256foundation/libreboard/README.md

# Libre-Board
Open Source Bitcoin Mining Control Board.
Learn more at https://libreboard.org/

Libre Logo

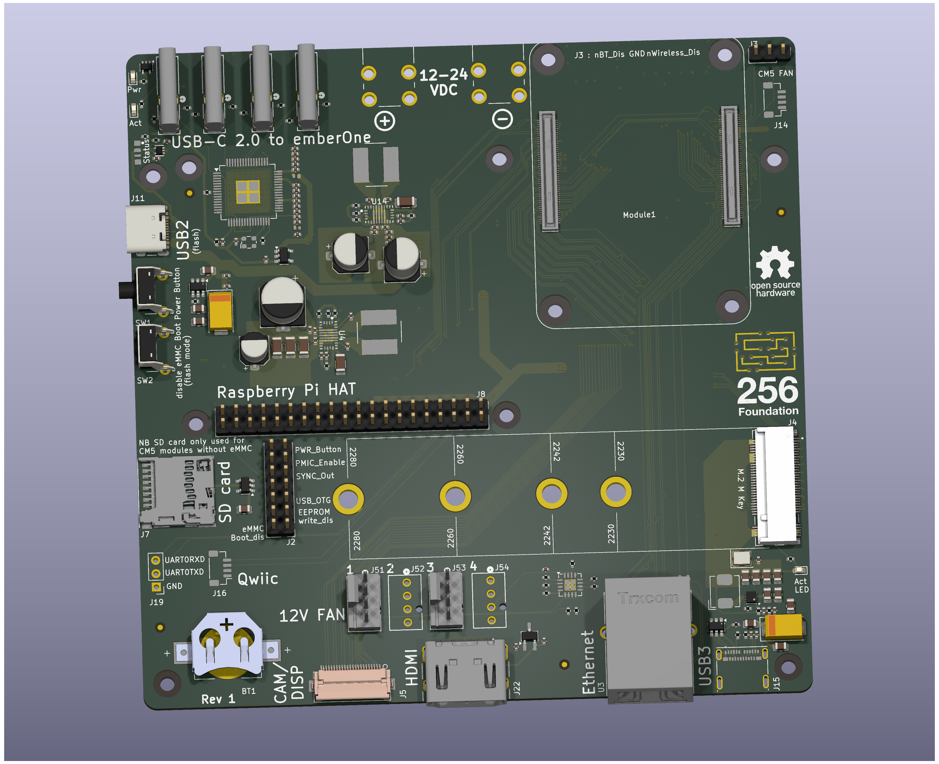
[picture p1: assets/renders/libreboard_front.png]
Libre Board Front


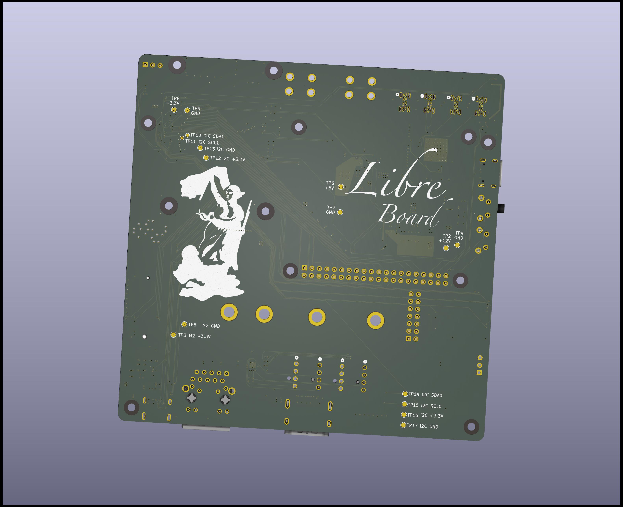
[picture p2: assets/renders/libreboard_back.jpg]
Libre Board Back
