256foundation/libreboard/250916_schematic-pcb-error-report.txt

Info: Processing symbol 'J15:Connector_USB:USB_C_Receptacle_Molex_105450-0101'.
Info: Processing symbol 'J6:libreboard:216989-0001_MOL'.
Info: Processing symbol 'U18:Package_TO_SOT_SMD:SOT-23-5'.
Info: Processing symbol 'U15:Package_TO_SOT_SMD:SOT-23-6'.
Info: Processing symbol 'J7:CM5IO:SDCARD_MOLEX_503398-1892'.
Info: Processing symbol 'J8:Connector_PinHeader_2.54mm:PinHeader_2x20_P2.54mm_Vertical'.
Info: Processing symbol 'J10:libreboard:216989-0001_MOL'.
Info: Processing symbol 'U14:libreboard:RYQ0021A-MFG'.
Info: Processing symbol 'U13:Package_TO_SOT_SMD:SOT-23-5'.
Info: Processing symbol 'U12:Package_TO_SOT_SMD:TSOT-23_HandSoldering'.
Info: Processing symbol 'J11:Connector_USB:USB_C_Receptacle_GCT_USB4105-GF-A_16P_TopMnt_Horizontal'.
Info: Processing symbol 'U11:Package_QFP:HTQFP-64-1EP_10x10mm_P0.5mm_EP8x8mm_Mask4.4x4.4mm_ThermalVias'.
Info: Processing symbol 'J14:Connector_JST:JST_SH_BM04B-SRSS-TB_1x04-1MP_P1.00mm_Vertical'.
Info: Processing symbol 'U10:Package_DFN_QFN:Texas_RGV0016A_VQFN-16-1EP_4x4mm_P0.65mm_EP2.1x2.1mm_ThermalVias'.
Info: Processing symbol 'U9:CM5IO:LED-SMD_4P-L4.0-W1.6-L'.
Info: Processing symbol 'BT1:CM5IO:BatteryHolder_Keystone_3034_1x20mm'.
Info: Processing symbol 'J16:Connector_JST:JST_SH_BM04B-SRSS-TB_1x04-1MP_P1.00mm_Vertical'.
Info: Processing symbol 'U8:Package_DFN_QFN:DFN-8-1EP_2x2mm_P0.5mm_EP1.05x1.75mm'.
Info: Processing symbol 'J17:libreboard:216989-0001_MOL'.
Info: Processing symbol 'U7:Crystal:Crystal_SMD_3225-4Pin_3.2x2.5mm'.
Info: Processing symbol 'U6:Package_TO_SOT_SMD:SOT-23-6'.
Info: Processing symbol 'J19:Connector_PinHeader_2.54mm:PinHeader_1x03_P2.54mm_Vertical'.
Info: Processing symbol 'J22:CM5IO:EDAC 690-019-298-412'.
Info: Processing symbol 'J51:libreboard:CONN_SD-47053-001_H10p00_MOL'.
Info: Processing symbol 'J52:libreboard:CONN_SD-47053-001_H10p00_MOL'.
Info: Processing symbol 'J53:libreboard:CONN_SD-47053-001_H10p00_MOL'.
Info: Processing symbol 'J54:libreboard:CONN_SD-47053-001_H10p00_MOL'.
Info: Processing symbol 'J100:libreboard:KEYSTONE_7790'.
Info: Processing symbol 'U5:Package_TO_SOT_SMD:SOT-353_SC-70-5'.
Info: Processing symbol 'H1:libreboard:MountingHole_2.7mm_M2.5_DIN965'.
Info: Processing symbol 'C62:Capacitor_SMD:C_0402_1005Metric'.
Info: Processing symbol 'C63:Capacitor_SMD:C_0402_1005Metric'.
Info: Processing symbol 'C64:Capacitor_SMD:C_0402_1005Metric'.
Info: Processing symbol 'C65:Capacitor_SMD:C_0402_1005Metric'.
Info: Processing symbol 'C66:Capacitor_SMD:C_0402_1005Metric'.
Info: Processing symbol 'C67:Capacitor_SMD:C_0402_1005Metric'.
Info: Processing symbol 'C68:Capacitor_SMD:C_0402_1005Metric'.
Info: Processing symbol 'C69:Capacitor_SMD:CP_Elec_6.3x9.9'.
Info: Processing symbol 'D1:LED_SMD:LED_0603_1608Metric'.
Info: Processing symbol 'D2:LED_SMD:LED_0603_1608Metric'.
Info: Processing symbol 'D3:LED_SMD:LED_0603_1608Metric'.
Info: Processing symbol 'FB1:libreboard:BEADC1005X55N'.
Info: Processing symbol 'FB2:libreboard:BEADC1005X55N'.
Info: Processing symbol 'U4:libreboard:RYQ0021A-MFG'.
Info: Processing symbol 'H2:libreboard:MountingHole_2.7mm_M2.5_DIN965'.
Info: Processing symbol 'H3:libreboard:MountingHole_2.7mm_M2.5_DIN965'.
Info: Processing symbol 'H4:libreboard:MountingHole_2.7mm_M2.5_DIN965'.
Info: Processing symbol 'H5:libreboard:MountingHole_2.7mm_M2.5_DIN965'.
Info: Processing symbol 'H6:libreboard:MountingHole_2.7mm_M2.5_DIN965'.
Info: Processing symbol 'H7:libreboard:MountingHole_2.7mm_M2.5_DIN965'.
Info: Processing symbol 'H8:libreboard:MountingHole_2.7mm_M2.5_DIN965'.
Info: Processing symbol 'J1:libreboard:216989-0001_MOL'.
Info: Processing symbol 'J2:Connector_PinHeader_2.54mm:PinHeader_2x07_P2.54mm_Vertical'.
Info: Processing symbol 'J3:Connector_PinHeader_2.54mm:PinHeader_1x03_P2.54mm_Vertical'.
Info: Processing symbol 'J4:CM5IO:M.2 M Key socket'.
Info: Processing symbol 'J5:CM5IO:Hirose_FH12-22S-0.5SH_1x22-1MP_P0.50mm_Horizontal'.
Info: Processing symbol 'Y1:Oscillator:Oscillator_SMD_ECS_2520MV-xxx-xx-4Pin_2.5x2.0mm'.
Info: Processing symbol 'R34:Resistor_SMD:R_0402_1005Metric'.
Info: Processing symbol 'R21:Resistor_SMD:R_0402_1005Metric'.
Info: Processing symbol 'R22:Resistor_SMD:R_0402_1005Metric'.
Info: Processing symbol 'R23:Resistor_SMD:R_0402_1005Metric'.
Info: Processing symbol 'R24:Resistor_SMD:R_0402_1005Metric'.
Info: Processing symbol 'R25:Resistor_SMD:R_0402_1005Metric'.
Info: Processing symbol 'R26:Resistor_SMD:R_0402_1005Metric'.
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
Warning: No net found for component J10 pad 16 (no pin 16 in symbol).
Warning: No net found for component J10 pad 17 (no pin 17 in symbol).
Warning: No net found for component J1 pad 16 (no pin 16 in symbol).
Warning: No net found for component J14 pad MP (no pin MP in symbol).
Warning: No net found for component J1 pad 18 (no pin 18 in symbol).
Warning: No net found for component J14 pad MP (no pin MP in symbol).
Warning: No net found for component J16 pad MP (no pin MP in symbol).
Warning: No net found for component J17 pad 18 (no pin 18 in symbol).
Warning: No net found for component J17 pad 17 (no pin 17 in symbol).
Warning: No net found for component J17 pad 16 (no pin 16 in symbol).
Warning: No net found for component J17 pad 15 (no pin 15 in symbol).
Warning: No net found for component J1 pad 17 (no pin 17 in symbol).
Warning: No net found for component J100 pad 1_2 (no pin 1_2 in symbol).
Warning: No net found for component J100 pad 1_4 (no pin 1_4 in symbol).
Warning: No net found for component J100 pad 1_1 (no pin 1_1 in symbol).
Warning: No net found for component J100 pad 1_3 (no pin 1_3 in symbol).
Warning: No net found for component J1 pad 15 (no pin 15 in symbol).
Warning: No net found for component J101 pad 1_4 (no pin 1_4 in symbol).
Warning: No net found for component J101 pad 1_2 (no pin 1_2 in symbol).
Warning: No net found for component J101 pad 1_3 (no pin 1_3 in symbol).
Warning: No net found for component J101 pad 1_1 (no pin 1_1 in symbol).
Error: Cannot add BT1 (footprint 'CM5IO:BatteryHolder_Keystone_3034_1x20mm' not found).
Error: Cannot update J4 (footprint 'CM5IO:M.2 M Key socket' not found).
Error: Cannot update U9 (footprint 'CM5IO:LED-SMD_4P-L4.0-W1.6-L' not found).
Error: Cannot update J5 (footprint 'CM5IO:Hirose_FH12-22S-0.5SH_1x22-1MP_P0.50mm_Horizontal' not found).
Error: Cannot update J7 (footprint 'CM5IO:SDCARD_MOLEX_503398-1892' not found).
Error: Cannot update J11 (footprint 'Connector_USB:USB_C_Receptacle_GCT_USB4105-GF-A_16P_TopMnt_Horizontal' not found).
Error: Cannot update Module1 (footprint 'CM5IO:Raspberry-Pi-5-Compute-Module' not found).
Error: Cannot update J22 (footprint 'CM5IO:EDAC 690-019-298-412' not found).
Error: Cannot update U3 (footprint 'CM5IO:TRJG0926HENL' not found).
Error: Cannot update L1 (footprint 'CM5IO:L_Bourns_SRP5030CC' not found).

Info: Total warnings: 34, errors: 10.
