256foundation/libreboard/bom/rev3-sourcing.csv

refs | qty_per_board | value | footprint | manufacturer | mpn | original_mpn | digikey_pn | digikey_status | digikey_stock | digikey_lifecycle | lcsc | jlc_mpn | jlc_manufacturer | jlc_type | jlc_stock | jlc_unit_price | jlc_decision | compared_specs | notes
R1 R10 R17 | 3 | 1kΩ | R_0402_1005Metric | Panasonic | ERJ-H2RF1001X |  | 10-ERJ-H2RF1001XTR-ND | ok | 21581 | Active | C11702 | 0402WGF1001TCE | UNI-ROYAL(Uniroyal Elec) | basic | 8252664 | 0.0035 | substitute | 1kΩ=1kΩ; 0402=0402; ±1%=±1%; 62.5 mW accepted (worst case < 5 mW); ±100ppm=±100ppm; thick film | Rule change from the coordinator: 62.5 mW is now accepted for all 0402 parts (the designer's worst-case dissipation is under 5 mW). Stock 8252664 covers the 30 needed. The substitute is rated -55..155 °C, against the original's 175 °C. Fallback (previous choice): substitute_extended C242161 ERJ2RKF1; DigiKey returned the same MPN. -55..175 °C rating. Reel (TR) number: the DigiKey 'price' is the single-unit price, and reel price breaks start at 5k/10k.
R2 R3 R9 | 3 | 470Ω | R_0402_1005Metric | Panasonic | ERJ-2RKF4700X |  | P470LTR-ND | ok | 266392 | Active | C25117 | 0402WGF4700TCE | UNI-ROYAL(Uniroyal Elec) | basic | 768020 | 0.0027 | substitute | 470Ω=470Ω; 0402=0402; ±1%=±1%; 62.5 mW accepted (worst case < 5 mW); ±100ppm=±100ppm; thick film | Rule change from the coordinator: 62.5 mW is now accepted for all 0402 parts (the designer's worst-case dissipation is under 5 mW). Stock 768020 covers the 30 needed. These are the LED resistors, the worst case on the board at about 4 mW. Fallback (previous choice): exact_extended C413076 ERJ2RKF470; DigiKey returned the same MPN. Reel (TR) number: the DigiKey 'price' is the single-unit price, and reel price breaks start at 5k/10k.
R6 R18 | 2 | 301kΩ | R_0402_1005Metric | Panasonic | ERJ-2RKF3013X |  | P301KLTR-ND | ok | 248697 | Active | C7209900 | AC0402FR-7W301KL | YAGEO | extended | 5260 | 0.0012 | substitute_extended | 301kΩ=301kΩ; 0402=0402; ±1%=±1%; 125mW>=100mW; ±100ppm=±100ppm; thick film | The exact part ERJ2RKF3013X (C416511) has only 8 in stock at JLC, short of the 20 needed. 62.5 mW is now accepted for 0402 parts, but no Basic/Preferred 0402 part has this exact resistance (live check of all 58 no-fee 0402 resistors). There is no Basic/Preferred 301k (only 300k, C25774). Backup: UNI; DigiKey returned the same MPN. Reel (TR) number: the DigiKey 'price' is the single-unit price, and reel price breaks start at 5k/10k.
R7 R19 | 2 | 45.3kΩ | R_0402_1005Metric | Panasonic | ERJ-2RKF4532X |  | P45.3KLTR-ND | ok | 68079 | Active | C2986582 | ERJ2RKF4532X | PANASONIC | extended | 55136 | 0.0058 | exact_extended | exact part: 45.3kΩ ±1% 100mW ±100ppm 0402 | 62.5 mW is now accepted for 0402 parts, but no Basic/Preferred 0402 part has this exact resistance (live check of all 58 no-fee 0402 resistors). No Basic/Preferred 45.3k exists.; DigiKey returned the same MPN. Reel (TR) number: the DigiKey 'price' is the single-unit price, and reel price breaks start at 5k/10k.
R8 | 1 | 48.7kΩ | R_0402_1005Metric | Panasonic | ERJ-2RKF4872X |  | P48.7KLTR-ND | ok | 0 | Active | C2077134 | ERJ2RKF4872X | PANASONIC | extended | 1373 | 0.0064 | exact_extended | exact part: 48.7kΩ ±1% 100mW ±100ppm 0402 | 62.5 mW is now accepted for 0402 parts, but no Basic/Preferred 0402 part has this exact resistance (live check of all 58 no-fee 0402 resistors). No Basic/Preferred 48.7k exists.; DigiKey returned the same MPN. Tape&reel listing shows 0 stock at DigiKey. Reel (TR) number: the DigiKey 'price' is the single-unit price, and reel price breaks start at 5k/10k.
R11 | 1 | 60.4kΩ | R_0402_1005Metric | Panasonic | ERJ-2RKF6042X |  | P60.4KLTR-ND | ok | 161300 | Active | C2986234 | ERJ2RKF6042X | PANASONIC | extended | 15475 | 0.0063 | exact_extended | exact part: 60.4kΩ ±1% 100mW ±100ppm 0402 | 62.5 mW is now accepted for 0402 parts, but no Basic/Preferred 0402 part has this exact resistance (live check of all 58 no-fee 0402 resistors). No Basic/Preferred 60.4k exists.; DigiKey returned the same MPN. Reel (TR) number: the DigiKey 'price' is the single-unit price, and reel price breaks start at 5k/10k.
R12 R46 | 2 | 15kΩ | R_0402_1005Metric | Panasonic | ERJ-2RKF1502X |  | P15.0KLTR-ND | ok | 975659 | Active | C25756 | 0402WGF1502TCE | UNI-ROYAL(Uniroyal Elec) | basic | 842369 | 0.0016 | substitute | 15kΩ=15kΩ; 0402=0402; ±1%=±1%; 62.5 mW accepted (worst case < 5 mW); ±100ppm=±100ppm; thick film | Rule change from the coordinator: 62.5 mW is now accepted for all 0402 parts (the designer's worst-case dissipation is under 5 mW). Stock 842369 covers the 20 needed. Fallback (previous choice): exact_extended C413097 ERJ2RKF1502X (PANASONIC, 100 mW, stock 52329).; DigiKey returned the same MPN. Reel (TR) number: the DigiKey 'price' is the single-unit price, and reel price breaks start at 5k/10k.
R13 | 1 | 50kΩ | R_0402_1005Metric | Vishay Dale | CRCW040250K0FKED |  | 541-CRCW040250K0FKEDTR-ND | ok | 477581 | Active | C7501196 | CRCW040250K0FKED | Vishay Intertech | extended | 7761 | 0.0256 | exact_extended | exact part: 50kΩ ±1% 63mW ±100ppm 0402 | No Basic/Preferred 50k 0402 exists (the list has only 49.9k C25897 and 51k C25794, both wrong values). The part is rated 63 mW (1/16 W), not the 0.1 W in the BOM description.; DigiKey returned the same MPN. DigiKey rates this part 0.063 W (1/16 W), not the 0.1 W in the BOM description. Reel (TR) number: the DigiKey 'price' is the single-unit price, and reel price breaks sta
R16 | 1 | 2.2kΩ | R_0402_1005Metric | Panasonic | ERJ-2RKF2201X |  | P2.20KLTR-ND | ok | 1063778 | Active | C25879 | 0402WGF2201TCE | UNI-ROYAL(Uniroyal Elec) | basic | 1604628 | 0.0017 | substitute | 2.2kΩ=2.2kΩ; 0402=0402; ±1%=±1%; 62.5 mW accepted (worst case < 5 mW); ±100ppm=±100ppm; thick film | Rule change from the coordinator: 62.5 mW is now accepted for all 0402 parts (the designer's worst-case dissipation is under 5 mW). Stock 1604628 covers the 10 needed. Fallback (previous choice): exact_extended C413087 ERJ2RKF2201X (PANASONIC, 100 mW, stock 54381).; DigiKey returned the same MPN. Reel (TR) number: the DigiKey 'price' is the single-unit price, and reel price breaks start at 5k/10k.
R20 | 1 | 25.5kΩ | R_0402_1005Metric | Panasonic | ERJ-2RKF2552X |  | P25.5KLTR-ND | ok | 33362 | Active | C2076811 | ERJ2RKF2552X | PANASONIC | extended | 6384 | 0.0058 | exact_extended | exact part: 25.5kΩ ±1% 100mW ±100ppm 0402 | 62.5 mW is now accepted for 0402 parts, but no Basic/Preferred 0402 part has this exact resistance (live check of all 58 no-fee 0402 resistors). No Basic/Preferred 25.5k exists.; DigiKey returned the same MPN. Reel (TR) number: the DigiKey 'price' is the single-unit price, and reel price breaks start at 5k/10k.
R21 R22 R23 R24 R29 R30 R33 R62 R4 R52 R15 | 11 | 10kΩ | R_0402_1005Metric | Panasonic | ERJ-U02F1002X |  | 10-ERJ-U02F1002XTR-ND | ok | 252849 | Active | C25744 | 0402WGF1002TCE | UNI-ROYAL(Uniroyal Elec) | basic | 19735080 | 0.0034 | substitute | 10kΩ=10kΩ; 0402=0402; ±1%=±1%; 62.5 mW accepted (worst case < 5 mW); ±100ppm (better than the original's ±200ppm); thick film | Rule change from the coordinator: 62.5 mW is now accepted for all 0402 parts (the designer's worst-case dissipation is under 5 mW). Stock 19735080 covers the 110 needed. Loses the ERJ-U anti-sulfur feature. Fallback (previous choice): substitute_extended C191123 ERJ2RKF1002X (PANASONIC, 100 mW, stoc; DigiKey returned the same MPN. Anti-sulfur, ±200 ppm/°C. Reel (TR) number: the DigiKey 'price' is the single-unit price, and reel price breaks start at 5k/10k.
R27 | 1 | 9.53kΩ | R_0402_1005Metric | Panasonic | ERJ-2RKF9531X |  | P9.53KLTR-ND | ok | 91600 | Active | C409938 | ERJ2RKF9531X | PANASONIC | extended | 999 | 0.0069 | exact_extended | exact part: 9.53kΩ ±1% 100mW ±100ppm 0402 | 62.5 mW is now accepted for 0402 parts, but no Basic/Preferred 0402 part has this exact resistance (live check of all 58 no-fee 0402 resistors). No Basic/Preferred 9.53k exists.; DigiKey returned the same MPN. Reel (TR) number: the DigiKey 'price' is the single-unit price, and reel price breaks start at 5k/10k.
R28 R58 | 2 | 4.7kΩ | R_0402_1005Metric | Panasonic | ERJ-U02F4701X |  | 10-ERJ-U02F4701XTR-ND | ok | 0 | Active | C25900 | 0402WGF4701TCE | UNI-ROYAL(Uniroyal Elec) | basic | 14590156 | 0.0027 | substitute | 4.7kΩ=4.7kΩ; 0402=0402; ±1%=±1%; 62.5 mW accepted (worst case < 5 mW); ±100ppm (better than the original's ±200ppm); thick film | Rule change from the coordinator: 62.5 mW is now accepted for all 0402 parts (the designer's worst-case dissipation is under 5 mW). Stock 14590156 covers the 20 needed. Loses the ERJ-U anti-sulfur feature. Fallback (previous choice): exact_extended C1858865 ERJU02F4701X (PANASONIC, 100 mW, stock 928; DigiKey returned the same MPN. Tape&reel listing shows 0 stock at DigiKey. Anti-sulfur, ±200 ppm/°C. Reel (TR) number: the DigiKey 'price' is the single-unit price, and reel price breaks start at 5k/1
R31 | 1 | 22kΩ | R_0402_1005Metric | Panasonic | ERJ-2RKF2202X |  | P22.0KLTR-ND | ok | 758224 | Active | C25768 | 0402WGF2202TCE | UNI-ROYAL(Uniroyal Elec) | basic | 739614 | 0.0024 | substitute | 22kΩ=22kΩ; 0402=0402; ±1%=±1%; 62.5 mW accepted (worst case < 5 mW); ±100ppm=±100ppm; thick film | Rule change from the coordinator: 62.5 mW is now accepted for all 0402 parts (the designer's worst-case dissipation is under 5 mW). Stock 739614 covers the 10 needed. Fallback (previous choice): exact_extended C413100 ERJ2RKF2202X (PANASONIC, 100 mW, stock 29316).; DigiKey returned the same MPN. Reel (TR) number: the DigiKey 'price' is the single-unit price, and reel price breaks start at 5k/10k.
R32 | 1 | 33kΩ | R_0402_1005Metric | Panasonic | ERJ-U02F3302X |  | 10-ERJ-U02F3302XTR-ND | ok | 38199 | Active | C25779 | 0402WGF3302TCE | UNI-ROYAL(Uniroyal Elec) | basic | 1171145 | 0.0058 | substitute | 33kΩ=33kΩ; 0402=0402; ±1%=±1%; 62.5 mW accepted (worst case < 5 mW); ±100ppm (better than the original's ±200ppm); thick film | Rule change from the coordinator: 62.5 mW is now accepted for all 0402 parts (the designer's worst-case dissipation is under 5 mW). Stock 1171145 covers the 10 needed. Loses the ERJ-U anti-sulfur feature. Fallback (previous choice): substitute_extended C278593 ERJ2RKF3302X (PANASONIC, 100 mW, stock ; DigiKey returned the same MPN. Anti-sulfur, ±200 ppm/°C. Reel (TR) number: the DigiKey 'price' is the single-unit price, and reel price breaks start at 5k/10k.
R34 R35 R36 R37 R38 R39 R40 R41 | 8 | 56kΩ | R_0402_1005Metric | Panasonic | ERJ-2RKF5602X |  | P56.0KLTR-ND | ok | 10089 | Active | C25796 | 0402WGF5602TCE | UNI-ROYAL(Uniroyal Elec) | preferred | 196831 | 0.003 | substitute | 56kΩ=56kΩ; 0402=0402; ±1%=±1%; 62.5 mW accepted (worst case < 5 mW); ±100ppm=±100ppm; thick film | Rule change from the coordinator: 62.5 mW is now accepted for all 0402 parts (the designer's worst-case dissipation is under 5 mW). Stock 196831 covers the 80 needed. Fallback (previous choice): exact_extended C413104 ERJ2RKF5602X (PANASONIC, 100 mW, stock 6041).; DigiKey returned the same MPN. Reel (TR) number: the DigiKey 'price' is the single-unit price, and reel price breaks start at 5k/10k.
R47 | 1 | 4.7kΩ | R_0603_1608Metric | Panasonic | ERJ-3EKF4701V |  | P4.70KHTR-ND | ok | 1040879 | Active | C23162 | 0603WAF4701T5E | UNI-ROYAL(Uniroyal Elec) | basic | 20999866 | 0.0028 | substitute | 4.7kΩ=4.7kΩ; 0603=0603; ±1%=±1%; 100mW=100mW; ±100ppm=±100ppm; thick film | The exact part ERJ3EKF4701V (C192166) is an extended part (stock 57835).; DigiKey returned the same MPN. Reel (TR) number: the DigiKey 'price' is the single-unit price, and reel price breaks start at 5k/10k.
R48 | 1 | 90.9kΩ | R_0603_1608Metric | Panasonic | ERJ-3EKF9092V |  | P90.9KHTR-ND | ok | 47115 | Active | C403390 | ERJ3EKF9092V | PANASONIC | extended | 49056 | 0.0084 | exact_extended | exact part: 90.9kΩ ±1% 100mW ±100ppm 0603 | No Basic/Preferred 90.9k 0603 exists. The search returned only 91k C23265, which is the wrong value.; DigiKey returned the same MPN. Reel (TR) number: the DigiKey 'price' is the single-unit price, and reel price breaks start at 5k/10k.
R49 | 1 | 10kΩ | R_0603_1608Metric | Panasonic | ERJ-3EKF1002V |  | P10.0KHTR-ND | ok | 2231125 | Active | C25804 | 0603WAF1002T5E | UNI-ROYAL(Uniroyal Elec) | basic | 26133491 | 0.0018 | substitute | 10kΩ=10kΩ; 0603=0603; ±1%=±1%; 100mW=100mW; ±100ppm=±100ppm; thick film | The exact part ERJ3EKF1002V (C191124) is an extended part (stock 535392).; DigiKey returned the same MPN. Reel (TR) number: the DigiKey 'price' is the single-unit price, and reel price breaks start at 5k/10k.
R50 | 1 | 158kΩ | R_0603_1608Metric | Panasonic | ERJ-3EKF1583V |  | P158KHTR-ND | ok | 43820 | Active | C22883 | 0603WAF1583T5E | UNI-ROYAL | extended | 52000 | 0.0052 | substitute_extended | exact part: 158kΩ ±1% 100mW ±100ppm 0603 | exact C403004 has only 15 at JLC for 10 needed; UNI-ROYAL 0603WAF1583T5E 158k 1% 0603 100 mW, 52k in stock; LOW STOCK: only 15 in stock (live check) for 10 needed, which leaves almost no room for assembly attrition. No Basic/Preferred 158k 0603 exists. Recommended backup: UNI-ROYAL 0603WAF1583T5E C22883 (extended, 158kΩ ±1% 100mW ±100ppm, stock 52435, $0.0014).; DigiKey returned the same MPN. Reel (TR) number: the DigiKey 'price' is the single-unit price, and reel price breaks start at 5k/10k.
R51 | 1 | 100kΩ | R_0603_1608Metric | Panasonic | ERJ-3EKF1003V |  | P100KHTR-ND | ok | 0 | Active | C25803 | 0603WAF1003T5E | UNI-ROYAL(Uniroyal Elec) | basic | 21036877 | 0.0031 | substitute | 100kΩ=100kΩ; 0603=0603; ±1%=±1%; 100mW=100mW; ±100ppm=±100ppm; thick film | The exact part ERJ3EKF1003V (C189597) is an extended part (stock 10239).; DigiKey returned the same MPN. Tape&reel listing shows 0 stock at DigiKey. Reel (TR) number: the DigiKey 'price' is the single-unit price, and reel price breaks start at 5k/10k.
R53 R55 R63 R42 R14 | 5 | 100kΩ | R_0402_1005Metric | Panasonic | ERJ-U02F1003X |  | 10-ERJ-U02F1003XTR-ND | ok | 65237 | Active | C25741 | 0402WGF1003TCE | UNI-ROYAL(Uniroyal Elec) | basic | 8076053 | 0.0024 | substitute | 100kΩ=100kΩ; 0402=0402; ±1%=±1%; 62.5 mW accepted (worst case < 5 mW); ±100ppm (better than the original's ±200ppm); thick film | Rule change from the coordinator: 62.5 mW is now accepted for all 0402 parts (the designer's worst-case dissipation is under 5 mW). Stock 8076053 covers the 50 needed. Loses the ERJ-U anti-sulfur feature. Fallback (previous choice): exact_extended C4331556 ERJU02F1003X (PANASONIC, 100 mW, stock 1013; DigiKey returned the same MPN. Anti-sulfur, ±200 ppm/°C. Reel (TR) number: the DigiKey 'price' is the single-unit price, and reel price breaks start at 5k/10k.
R54 | 1 | 30.1kΩ | R_0402_1005Metric | Panasonic | ERJ-2RKF3012X |  | P30.1KLTR-ND | ok | 57013 | Active | C2076806 | ERJ2RKF3012X | PANASONIC | extended | 28662 | 0.0059 | exact_extended | exact part: 30.1kΩ ±1% 100mW ±100ppm 0402 | 62.5 mW is now accepted for 0402 parts, but no Basic/Preferred 0402 part has this exact resistance (live check of all 58 no-fee 0402 resistors). No Basic/Preferred 30.1k exists.; DigiKey returned the same MPN. Reel (TR) number: the DigiKey 'price' is the single-unit price, and reel price breaks start at 5k/10k.
R56 | 1 | 11.0kΩ | R_0402_1005Metric | Panasonic | ERJ-2RKF1102X |  | P11.0KLTR-ND | ok | 198499 | Active | C409880 | ERJ2RKF1102X | PANASONIC | extended | 11322 | 0.0082 | exact_extended | exact part: 11kΩ ±1% 100mW ±100ppm 0402 | 62.5 mW is now accepted for 0402 parts, but no Basic/Preferred 0402 part has this exact resistance (live check of all 58 no-fee 0402 resistors). No Basic/Preferred 11k exists.; DigiKey returned the same MPN. Reel (TR) number: the DigiKey 'price' is the single-unit price, and reel price breaks start at 5k/10k.
R57 | 1 | 887kΩ | R_0402_1005Metric | Panasonic | ERJ-2RKF8873X |  | P887KLTR-ND | ok | 150601 | Active | C409935 | ERJ2RKF8873X | PANASONIC | extended | 11735 | 0.0062 | exact_extended | exact part: 887kΩ ±1% 100mW ±100ppm 0402 | 62.5 mW is now accepted for 0402 parts, but no Basic/Preferred 0402 part has this exact resistance (live check of all 58 no-fee 0402 resistors). No Basic/Preferred 887k exists.; DigiKey returned the same MPN. Reel (TR) number: the DigiKey 'price' is the single-unit price, and reel price breaks start at 5k/10k.
R59 | 1 | 499kΩ | R_0402_1005Metric | Panasonic | ERJ-2RKF4993X |  | P499KLTR-ND | ok | 199751 | Active | C2986233 | ERJ2RKF4993X | PANASONIC | extended | 34194 | 0.0066 | exact_extended | exact part: 499kΩ ±1% 100mW ±100ppm 0402 | 62.5 mW is now accepted for 0402 parts, but no Basic/Preferred 0402 part has this exact resistance (live check of all 58 no-fee 0402 resistors). No Basic/Preferred 499k exists.; DigiKey returned the same MPN. Reel (TR) number: the DigiKey 'price' is the single-unit price, and reel price breaks start at 5k/10k.
R60 R61 | 2 | 200kΩ | R_0402_1005Metric | Panasonic | ERJ-2RKF2003X |  | P200KLTR-ND | ok | 604734 | Active | C25764 | 0402WGF2003TCE | UNI-ROYAL(Uniroyal Elec) | basic | 2227884 | 0.0018 | substitute | 200kΩ=200kΩ; 0402=0402; ±1%=±1%; 62.5 mW accepted (worst case < 5 mW); ±100ppm=±100ppm; thick film | Rule change from the coordinator: 62.5 mW is now accepted for all 0402 parts (the designer's worst-case dissipation is under 5 mW). Stock 2227884 covers the 20 needed. Fallback (previous choice): exact_extended C413111 ERJ2RKF2003X (PANASONIC, 100 mW, stock 48403).; DigiKey returned the same MPN. Reel (TR) number: the DigiKey 'price' is the single-unit price, and reel price breaks start at 5k/10k.
C2 C7 C8 C56 C58 C59 C75 C77 C5 C4 C6 C14 C15 C16 C17 | 15 | 10µF | C_0805_2012Metric | Kyocera | 0805ZD106KAT2A |  | 478-KGM21AR51A106KUTR-ND | ok | 59 | Active | C15850 | CL21A106KAYNNNE | Samsung Electro-Mechanics | basic | 4331767 | 0.0688 | substitute | orig 10uF 10V X5R +-10% 0805 -> sub 10uF 25V X5R +-10% 0805 (V higher, same dielectric/tol) | Exact part at JLC is extended C4153103 (stock 4591). Need 150.; DigiKey returns mfr_part_number 0805ZD106KAT2A for this number (DigiKey PN uses Kyocera's new KGM name). 10uF 10V X5R +-10% 0805. LOW STOCK: 59 vs 150 needed; T&R min_qty 3000.
C3 | 1 | 100µF | CP_EIA-7343-31_Kemet-D | Kemet | A700X107M010ATE010 |  | 399-11382-2-ND | ok | 14515 | Active | C3275146 | A700X107M010ATE010 | KEMET | extended | 31 | 5.347 | exact_extended | exact part: 100uF 10V aluminium polymer 10mOhm SMD 7.3x4.3mm | No basic/preferred polymer caps at JLC. LOW STOCK: 31 vs 20 needed (live stock check confirms 31). No 7343 aluminium-polymer alternative at JLC meets ESR <= 10mOhm (closest: C135491 AISHI SA11AM101A19R15XXX and C2997484 Ymin MPD101M1AD19015R, both 100uF 10V 15mOhm@100kHz).; MPN matches. DigiKey: Polymer (aluminium polymer, not tantalum), 100uF 10V 10mOhm, 2917/7343, 4.3mm H, 125C. T&R min_qty 500.
C9 C18 C31 C12 C13 C35 C36 C37 C38 C39 C40 C41 C42 C43 C44 C45 C50 C1 C70 C10 C19 | 21 | 100nF | C_0402_1005Metric | Kyocera | 04026D104KAT4A |  | 478-11504-2-ND | ok | 55525 | Active | C1525 | CL05B104KO5NNNC | Samsung Electro-Mechanics | basic | 24116891 | 0.0045 | substitute | orig 100nF 6.3V X5R +-10% 0402 -> sub 100nF 16V X7R +-10% 0402 (V higher, dielectric better, tol equal) | Exact MPN not found at JLC. Need 210. 50V alternative also basic: C307331 CL05B104KB54PNC.; MPN matches (KYOCERA AVX 04026D104KAT4A, 0.1uF 6.3V X5R +-10% 0402). T&R number, min_qty 50000 - order cut tape for 210 pcs.
C11 | 1 | 4.7nF | C_0402_1005Metric | Kyocera | KGM05AR71A472KH |  | 478-KGM05AR71A472KHTR-ND | ok | 53601 | Active | C1538 | 0402B472K500NT | FH (Guangdong Fenghua Advanced Tech) | basic | 1185783 | 0.0038 | substitute | orig 4.7nF 10V X7R +-10% 0402 -> sub 4.7nF 50V X7R +-10% 0402 (V higher, same dielectric/tol) | Exact MPN not at JLC.; Lookup by DigiKey number returned an API error; lookup by MPN returned this same DigiKey number with matching MPN (4700pF 10V X7R +-10% 0402). T&R min_qty 10000.
C20 | 1 | 39µF | CP_Elec_8x6.7 | Kemet | A770KE396M1HLAS042 |  | 399-A770KE396M1HLAS042TR-ND | ok | 6839 | Active | C7059708 | A770KE396M1HLAS042 | KEMET | extended | 24 | 0.3242 | exact_extended | exact part: 39uF 50V polymer 42mOhm D8xL6.7 (7mm max) | No basic/preferred polymer aluminium caps exist at JLC. LOW STOCK: 24 vs 10 needed (live stock check confirms 24). Backup with same specs/case: C1517683 KEMET A768KE396M1HLAE042 (39uF 50V 42mOhm@100kHz, 8x6.7mm, 125C, stock 45, $1.0571, extended).; MPN matches. DigiKey: Type Polymer (aluminium polymer, not wet electrolytic), 39uF 50V 42mOhm, 8mm dia x 7.0mm, AEC-Q200, 125C. T&R min_qty 1000.
C21 C52 | 2 | 10µF | C_0805_2012Metric | Murata Electronics | GRM21BR61H106KE43L |  | 490-18663-2-ND | ok | 0 | Active | C440198 | GRM21BR61H106KE43L | Murata Electronics | basic | 1370400 | 0.2069 | exact | exact part: 10uF 50V X5R +-10% 0805 | Exact part is basic at JLC. Need 20.; MPN matches. DigiKey STOCK 0 on this T&R number (min_qty 3000).
C22 C30 C54 C74 | 4 | 1µF | C_0402_1005Metric | Murata Electronics | GRM155R61H105KE05D |  | 490-GRM155R61H105KE05DTR-ND | ok | 0 | Active | C1518208 | GRM155R61H105KE05D | Murata Electronics | extended | 191710 | 0.0341 | exact_extended | exact part: 1uF 50V X5R +-10% 0402 | Only basic 1uF 0402 is C52923 (25V) - lower voltage than original 50V, so not used. Need 40.; MPN matches. DigiKey STOCK 0 on this T&R number (min_qty 10000).
C23 C53 | 2 | 4.7µF | C_1206_3216Metric | Kyocera | 12065C475KAT2A |  | 478-KGM31AR71H475KUTR-ND | ok | 12061 | Active | C29823 | 1206B475K500NT | FH (Guangdong Fenghua Advanced Tech) | basic | 531847 | 0.1674 | substitute | orig 4.7uF 50V X7R +-10% 1206 -> sub 4.7uF 50V X7R +-10% 1206 (identical ratings) | Exact part also at JLC as extended C141667 (stock 2248, $0.4121). Need 20.; DigiKey returns mfr_part_number 12065C475KAT2A for this number (DigiKey PN uses Kyocera's new KGM name). 4.7uF 50V X7R +-10% 1206. T&R min_qty 2000.
C24 C25 C55 C65 C76 C78 | 6 | 100nF | C_0402_1005Metric | Murata Electronics | GRM155R71H104KE14D |  | 490-10700-2-ND | ok | 1300291 | Active | C307331 | CL05B104KB54PNC | Samsung Electro-Mechanics | basic | 16068309 | 0.0104 | substitute | orig 100nF 50V X7R +-10% 0402 -> sub 100nF 50V X7R +-10% 0402 (identical ratings) | Exact part at JLC is extended C77020 (stock 1601775). Need 60.; MPN matches. T&R min_qty 10000.
C26 | 1 | 56µF | CP_Elec_5x5.9 | APAQ Technology | 250AVCP470M0506 | 20SVF56M |  | not_checked |  |  | C54864098 | 250AVCP470M0506 | APAQ Tech | extended | 1035 | 0.1927 | substitute_extended (decided 2026-10-20) | polymer, 47uF (was 56uF), 25V (was 20V), 35 mOhm @100kHz (was 30), 1.7A ripple, D5xL5.8mm (same 5 mm footprint) | Fitted again (was DNP by accident since 82c34c4). Panasonic 20SVPF56MX C2162042 has 2 at JLC, min order 6. Distributor = LCSC C54864098; no EasyEDA footprint.
C27 C28 C29 | 3 | 33µF | C_1206_3216Metric | TDK Corporation | C3216X5R1E336M160AC |  | 445-8046-1-ND | ok | 0 | Active | C342307 | C3216X5R1E336MT000E | TDK | extended | 22926 | 1.1825 | substitute_extended | orig 33uF 25V X5R +-20% 1206 -> sub 33uF 25V X5R +-20% 1206 (identical ratings, same maker) | strip trailing ' - Cut Tape' text; Exact MPN not at JLC; no basic/preferred 33uF 1206 exists. Need 30.; Lookup of 445-8046-1-ND resolved to its T&R sibling 445-8046-2-ND with matching MPN (TDK C3216X5R1E336M160AC, 33uF 25V X5R +-20% 1206); existing cut-tape number kept. Stock/price shown are those retur
C34 C46 | 2 | 10µF | C_0402_1005Metric | Kyocera | 04026D106MAT2A |  | 478-KGM05CR50J106MHTR-ND | ok | 155910 | Active | C15525 | CL05A106MQ5NUNC | Samsung Electro-Mechanics | basic | 10912233 | 0.0256 | substitute | orig 10uF 6.3V X5R +-20% 0402 -> sub 10uF 6.3V X5R +-20% 0402 (identical ratings) | Exact part at JLC is extended C2178725 (stock 6189). Need 30.; DigiKey returns mfr_part_number 04026D106MAT2A for this number (DigiKey PN uses Kyocera's new KGM name). 10uF 6.3V X5R +-20% 0402. T&R min_qty 10000.
C71 | 1 | 10µF | C_0402_1005Metric | Murata | GRM155R61A106ME11D | 04026D106MAT2A | 490-GRM155R61A106ME11DTR-ND | ok | 0 | Active | C408132 | GRM155R61A106ME11D | Murata Electronics | extended | 184526 | 0.0453 | upgrade (decided 2026-10-20) | 10uF 0402 X5R +-20%, 10 V instead of 6.3 V (C71 sits on +5v at 5.19 V) | Voltage margin only; any 0402 10 uF keeps a fraction of its capacity at 5 V. DigiKey TR reel number (0 in stock on 2026-10-20, Active); Mouser 81-GRM155R61A106ME1D.
C51 | 1 | 22µF | CP_Elec_6.3x5.9 | Kemet | A768EB226M1HLAE048 |  | 399-A768EB226M1HLAE048TR-ND | ok | 8911 | Active | C46550474 | MA50V22M6X6 | jieerrui | extended | 73859 | 0.1862 | substitute_extended | orig polymer 22uF 50V 48mOhm D6.3x6.0 -> sub polymer 22uF 50V 40mOhm@100kHz SMD D6.3xL6mm (C equal, V equal, ESR lower, same case) | Exact MPN not at JLC; no basic/preferred polymer caps exist. Substitute rated -55~+105C, 2000h@105C (original 125C). On 12-24 V input: 50 V rating kept.; MPN matches. DigiKey: Polymer (aluminium polymer), 22uF 50V 48mOhm, 6.3mm dia x 6.0mm, 125C. T&R min_qty 1000.
C60 | 1 | 6.8pF | C_0402_1005Metric | Kyocera | 04025A6R8CAT2A |  | 478-KGM05ACG1H6R8CHTR-ND | not_at_digikey |  |  | C1576 | 0402CG6R8C500NT | FH (Guangdong Fenghua Advanced Tech) | preferred | 202831 | 0.0046 | substitute | orig 6.8pF 50V C0G +-0.25pF 0402 -> sub 6.8pF 50V C0G 0402; tolerance letter 'C' in MPN (+-0.25pF) - JLC tolerance field is empty | AVX renamed 04025A6R8CAT2A to KGM05ACG1H6R8CH (new global PN); DigiKey lists the new PN; Exact part at JLC is extended C597037 with only 18 in stock (need 10). Substitute tolerance taken from the MPN code, not a JLC spec field - confirm +-0.25pF in datasheet before use.; Blank dkpn. digikey_get_part('04025A6R8CAT2A') returned 'DigiKey part lookup failed' on 2 attempts - not found or API error; UNCONFIRMED, check manually.
C61 | 1 | 1nF | C_0402_1005Metric | Murata Electronics | GRM1555C1H102JA01D |  | 490-3244-2-ND | filled | 2798015 | Active | C76947 | GRM1555C1H102JA01D | Murata Electronics | extended | 448061 | 0.0103 | exact_extended | exact part: 1nF 50V C0G +-5% 0402 | Only basic 1nF 0402 is C1523 (X7R +-10%) - worse dielectric/tolerance, not used.; Blank dkpn; filled from MPN lookup (Murata GRM1555C1H102JA01D, 1000pF 50V C0G +-5% 0402). T&R min_qty 10000.
C62 | 1 | 2.2nF | C_0402_1005Metric | Kyocera | KGM05AR71H222KH |  | 478-KGM05AR71H222KHTR-ND | ok | 108999 | Active | C1531 | 0402B222K500NT | FH (Guangdong Fenghua Advanced Tech) | preferred | 453137 | 0.0028 | substitute | orig 2.2nF 50V X7R +-10% 0402 -> sub 2.2nF 50V X7R +-10% 0402 (identical ratings) | Exact MPN not at JLC.; MPN matches (2200pF 50V X7R +-10% 0402). T&R min_qty 10000.
C63 | 1 | 3.9pF | C_0402_1005Metric | Kyocera | KGM05ACG1H3R9BH |  | 478-KGM05ACG1H3R9BHTR-ND | ok | 48083 | Active | C1517504 | GJM1555C1H3R9GB01D | Murata Electronics | extended | 5582 | 0.0453 | substitute_extended | orig 3.9pF 50V C0G +-0.1pF 0402 -> sub 3.9pF 50V C0G +-2% (= +-0.078pF) 0402 per JLC spec field | Exact MPN not at JLC; no basic/preferred 3.9pF 0402 exists. Chosen because it is the only candidate whose tolerance is stated in JLC data. Alternative with more stock: C76907 Murata GJM1555C1H3R9BB01D (tolerance letter B = +-0.1pF from MPN code, JLC field empty; stock 19967, $0.0359).; MPN matches. DigiKey tolerance +-0.1pF (BOM text says +-2.5%), 50V C0G 0402. T&R min_qty 10000.
C64 C47 C48 | 3 | 1µF | C_0402_1005Metric | Kyocera | 04026D105KAT2A |  | 478-KGM05AR50J105KHTR-ND | ok | 1265648 | Active | C52923 | CL05A105KA5NQNC | Samsung Electro-Mechanics | basic | 7478708 | 0.0087 | substitute | orig 1uF 6.3V X5R +-10% 0402 -> sub 1uF 25V X5R +-10% 0402 (V higher, same dielectric/tol) | Exact MPN not at JLC. Need 30.; DigiKey returns mfr_part_number 04026D105KAT2A for this number (DigiKey PN uses Kyocera's new KGM name). 1uF 6.3V X5R +-10% 0402. T&R min_qty 10000.
C57 C66 C67 C68 | 4 | 47µF | C_1206_3216Metric | TDK Corporation | C3216X5R1A476M160AB |  | 445-6006-2-ND | filled | 15890 | Active | C96123 | CL31A476MPHNNNE | Samsung Electro-Mechanics | basic | 390136 | 0.2593 | substitute | orig 47uF 10V X5R +-20% 1206 -> sub 47uF 10V X5R +-20% 1206 (identical ratings) | Exact MPN not at JLC. Need 30. On 5.2 V rail.; Blank dkpn; filled from MPN lookup (TDK C3216X5R1A476M160AB, 47uF 10V X5R +-20% 1206). T&R min_qty 2000.
C69 | 1 | 270µF | CP_Elec_6.3x9.9 | Panasonic | 10SVP270M |  | P16432TR-ND | ok | 500 | Active | C2944013 | APXJ160ARA271MF80J | NCC(Nippon Chemi-Con) | extended | 4308 | 0.3981 | substitute_extended | orig polymer 270uF 10V 25mOhm -> sub polymer 270uF 16V 10mOhm SMD D6.3xL7.7mm, 15000h@105C (C equal, V higher, ESR lower; 6.3mm can fits the CP_Elec_6.3x9.9 land pattern) | Exact MPN not at JLC; no basic/preferred polymer caps exist. Alternatives: C46550459 jieerrui MA10V470M6X8 (470uF 10V 20mOhm@100kHz D6.3xL7.7, stock 80334, $0.1994); C178351 Panasonic 16SVPG270M (270uF 16V, D6.3xL9.9 = exact footprint size, but ESR not listed at JLC, stock 596, $1.6043). If the boar; MPN matches. DigiKey: Polymer, 270uF 10V 25mOhm, 105C. FOOTPRINT CHECK: DigiKey lists size 10.00mm dia x 8.00mm H, land 10.3x10.3mm, which does not match footprint CP_Elec_6.3x9.9 - verify against Pan
C72 | 1 | 0.1µF | C_0603_1608Metric | YAGEO | CC0603KRX7R9BB104 | GRM188R71C104KA01D | 311-1344-2-ND | ok | 0 | Obsolete | C14663 | CC0603KRX7R9BB104 | YAGEO | basic | 56561970 | 0.014 | substitute | orig 100nF 16V X7R +-10% 0603 -> sub 100nF 50V X7R +-10% 0603 (V higher, same dielectric/tol) | Murata GRM188R71C104KA01D obsolete (also successors KA01J / 71H104KA93D obsolete at DigiKey); Yageo is JLC Basic and DigiKey active; Exact part at JLC is extended C45000 (stock 41431).; MPN matches, but DigiKey lifecycle OBSOLETE, stock 0, no price. Needs a replacement DigiKey part (e.g. the JLC substitute's MPN) - not looked up (quota).
C73 | 1 | 1nF | C_0603_1608Metric | Murata | GRM1885C1H102JA01D |  |  | wrong |  |  | C77026 | GRM1885C1H102JA01D | Murata Electronics | extended | 113635 | 0.0261 | exact_extended | exact part: 1nF 50V C0G +-5% 0603 | old number 490-1494-2-ND is GRM188R71H102KA01D (X7R, obsolete); DigiKey API lookup for the right part failed - fill manually; Only basic 1nF 0603 is C1588 (X7R +-10%) - worse dielectric/tolerance, not used.; 490-1494-2-ND is GRM188R71H102KA01D (1000pF 50V X7R +-10% 0603, Obsolete, stock 0) - not the C0G +-5% part in the BOM. MPN lookup of GRM1885C1H102JA01D returned 'DigiKey part lookup failed' (API error
L1 | 1 | 2.2µH | L_Bourns_SRP5030CC | Bourns | SRP5030CC-2R2M |  | 118-SRP5030CC-2R2MTR-ND | ok | 258 | Active | C22404330 | SRP5030CC-2R2M | BOURNS | extended | 640 | 1.1304 | exact_extended | Exact MPN: 2.2uH ±20%, 7A, Isat 8A, 5.7x5.2mm | BOM description says '32Ω'. DigiKey gives DCR as 32mΩ max.
L2 L3 | 2 | 4.7µH | L_Bourns_SRN8040TA | Bourns | SRN8040-4R7Y |  | SRN8040-4R7YCT-ND | ok | 3000 | Active | C6685196 | SRN8040-4R7Y | BOURNS | extended | 159 | 0.7118 | exact_extended | Exact MPN: 4.7uH ±30%, 4.1A rated, Isat 4.7A, DCR 24mΩ | BOM said Coilcraft; SRN8040 is a Bourns series (DigiKey/JLC both list Bourns); Need 20; stock 159 OK.; Lookup of the CT number resolved to the SRN8040-4R7YTR-ND listing (same MPN); stock/price are from that listing (min_qty 1000). BOM manufacturer field says Coilcraft, but SRN8040 is a Bourns part (Dig
FB1 | 1 | 220Ω @ 100Mhz | BEADC1005X55N | Laird Signal | LI0402C221R-10 |  | 240-2554-2-ND | ok | 1 | Active | C85813 | BLM15AG221SN1D | Murata Electronics | extended | 263309 | 0.01 | substitute_extended | Orig: 220Ω@100MHz, 300mA, DCR ≤350mΩ, 0402. Sub: 220Ω@100MHz ±25%, 450mA, DCR 290mΩ, 0402 — impedance identical, current ≥, DCR ≤. | Exact part is listed at JLC (C3716595) with stock 0. JLC has no Basic/Preferred 0402 ferrite beads at all, so the best qualifying extended part was chosen. Other qualifying extended options: Murata BLM15PX221SN1D C160973 (1.4A, 100mΩ), TDK MPZ1005S221HT000 C1870222 (1.5A, 95mΩ).; LOW STOCK at DigiKey: 1 (need 10). Specs: 220Ω@100MHz, 300mA, DCR 350mΩ max, 0402. Listing min_qty 10000 (reel).
FB2 | 1 | 120Ω @ 100MHz | L_0603_1608Metric | Murata | BLM18KG121TN1D |  | 490-5254-2-ND | ok | 531438 | Active | C85831 | BLM18KG121TN1D | Murata Electronics | extended | 243149 | 0.0232 | exact_extended | Need 120Ω@100MHz ±25%, ≥3A, DCR ≤30mΩ, 0603. Only no-fee 0603 120Ω bead is BLM18PG121SN1D (C14709, Basic): 2A and 50mΩ — fails current and DCR. No qualifying Basic/Preferred part. | Exact part used as extended.
D1 | 1 | LED Red | LED_0603_1608Metric | Lite-On Inc. | LTST-S270KRKT |  | 160-1479-2-ND | ok | 311431 | Active | C125114 | LTST-S270KRKT | Lite-On | extended | 346 | 0.0395 | exact_extended | Exact MPN: red 631nm, side-view, SMD 1.6x1.2mm, 2V@20mA | Right-angle (side-view) 0603 red, 631nm dominant.
D2 D3 | 2 | LED Green | LED_0603_1608Metric | Lite-On Inc. | LTST-S270KGKT |  | 160-1478-2-ND | ok | 320494 | Active | C125113 | LTST-S270KGKT | Lite-On | extended | 6640 | 0.0349 | exact_extended | Exact MPN: 571nm (LCSC calls it yellow-green), side-view, SMD 1.6x1.2mm | Right-angle (side-view) 0603 green, 571nm dominant.
Q1 Q2 | 2 | 2N7002 | SOT-23 | Diodes Incorporated | 2N7002-7-F |  | 2N7002-FDITR-ND | filled | 506719 | Active | C8545 | 2N7002 | Jiangsu Changjing Electronics Technology Co., Ltd. | basic | 1317646 | 0.0178 | substitute | Orig Diodes 2N7002-7-F: N-ch 60V, 115mA, Vgs(th) 2.5V max, 7.5Ω@5V, 370mW, SOT-23. Sub CJ 2N7002: N-ch 60V, 115mA, Vgs(th) 2.5V, 5Ω@10V, Vgs ±20V, 225mW, SOT-23. | Done per the group note (any SOT-23 2N7002 with G=1,S=2,D=3 is a valid drop-in; prefer Basic). The tools did not return a pinout, so check the CJ datasheet for the standard pinout. Pd is lower (225 vs 370 mW). That should be fine if Q1/Q2 are small-signal switches. The exact part is also at JLC as e; Dist. P/N was blank; filled from MPN lookup.
U1 U2 | 2 | TPD4EUSB30 | USON-10_2.5x1.0mm_P0.5mm | Texas Instruments | TPD4EUSB30DQAR |  | 296-28063-2-ND | ok | 109906 | Active | C90627 | TPD4EUSB30DQAR | Texas Instruments | extended | 25446 | 0.3763 | exact_extended | Exact MPN, USON-10 (1x2.5), 4-ch, 8V clamp | DNP - not fitted (2026-10-11). The CM5 IO board, where these come from, labels them 'Ethernet POE Protection'; LibreBoard has no PoE (cable-side taps unconnected) and the MagJack isolates 1500 Vrms. On Rev1 badly soldered U1/U2 caused the 100 Mb/s dropouts. Flow-through footprints keep the lines connected when unfitted, so they can be fitted later.
U3 | 1 | LPJG0926HENL | TRJG0926HENL | LINK-PP | LPJG0926HENL | TMJG4926HENL |  | not_at_digikey |  |  | C22457393 | LPJG0926HENL | Link-PP Intl Technology | extended | 2305 | 4.4464 | substitute_extended (pinout verified) | Same internal schematic and pin layout as TMJG4926HENL (LINK-PP drawing LP18022610 rev A vs Taoglas SPE-23-8-193-B): TD1-TD4 on pins 1/2, 3/6, 7/8, 9/10; CT 4/5; cable-side centre taps 11-14; green LED 15/16, yellow 17/18; 1CT:1CT, 350 uH OCL, 1500 Vrms hipot, PoE 720 mA. Rated 0-70 C (Taoglas -40-85 C). | Switched 2026-10-11. The Rev1 boards were fitted with Taoglas TMJG0813GENL, which fits the same holes but has a different pinout (9 = centre tap, 10 = GND, 4/5 = a signal pair), so gigabit could never link. Never accept TMJG0813GENL. DigiKey alternative with the right pinout: Taoglas TMJG4926HENL, 931-TMJG4926HENL-ND (4 in stock 2026-10-11). LPJG0926HENL not found at DigiKey or Mouser.
U4 U14 | 2 | TPS552892QWRYQRQ1 | RYQ0021A-MFG | Texas Instruments | TPS552892QWRYQRQ1 | TPS552892RYQR | 296-TPS552892QWRYQRQ1TR-ND | filled | 0 | Active | C22375748 | TPS552892QWRYQRQ1 | Texas Instruments | extended | 0 | 7.9953 | JLC global sourcing, else hand-fit (decided 2026-10-11) | AEC-Q100 version of the same die: 21 pins, RYQ VQFN-HR, VREF 1.2 V, 3-36 V input (both TI datasheets; JLC lists 3-27 V). | Plan A: JLC global parts sourcing from Mouser 595-PS552892QWRYQRQ1 (25 in stock 2026-10-11). Plan B: buy at Mouser and hand-fit after assembly (exclude from placement like U17). Automotive grade not required; it is the only TPS552892 in stock. JLC 0, DigiKey 0. TPS55289RYQR rejected (I2C enable needed, cannot self-start U14).
U5 | 1 | 74LVC1G07SE-7 | SOT-353_SC-70-5 | Diodes Inc. | 74LVC1G07SE-7 |  | 74LVC1G07SE-7DITR-ND | ok | 0 | Active | C67531 | 74LVC1G07SE-7 | Diodes Incorporated | extended | 8159 | 0.3036 | exact_extended | Exact MPN, SOT-353, open-drain buffer 1.65–5.5V | OUT OF STOCK at DigiKey (0; need 10).
U6 U15 | 2 | AP22653W6 | SOT-23-6 | Diodes Inc. | AP22653W6-7 |  | 31-AP22653W6-7TR-ND | ok | 75812 | Active | C2158037 | AP22653W6-7 | Diodes Incorporated | extended | 13769 | 0.2605 | exact_extended | Exact MPN, SOT-26, 2.1A, 65mΩ | Need 20; stock OK.
U7 | 1 | ASEK-32.768KHZ-L-R-T | Crystal_SMD_3225-4Pin_3.2x2.5mm | Abracon | ASEK-32.768KHZ-L-R-T |  | 535-ASEK-32.768KHZ-L-R-TTR-ND | ok | 0 | Active | C2650753 | ASEK-32.768KHZ-LRT | Abracon LLC | extended | 1136 | 1.6971 | exact_extended | 32.768kHz CMOS XO, 3.3V, ±25ppm, -40~85°C, 3.5mA, SMD3225-4P. Identical to the DigiKey listing for ASEK-32.768KHZ-L-R-T. | LCSC writes the MPN without the inner hyphens ('-LRT'). It is the same Abracon part, and every spec field matches.; OUT OF STOCK at DigiKey (0; need 10). 3.3V-only CMOS XO.
U8 | 1 | AP3441SHE-7B | DFN-8-1EP_2x2mm_P0.5mm_EP1.05x1.75mm | Diodes Inc. | AP3441SHE-7B |  | AP3441SHE-7BDITR-ND | ok | 0 | Active | C2070918 | AP3441SHE-7B | Diodes Incorporated | extended | 9112 | 1.8616 | exact_extended | Exact MPN, DFN2020-8-EP, 3A buck, 1MHz | OUT OF STOCK at DigiKey (0; need 10).
U9 | 1 | SK6812 | LED-SMD_4P-L4.0-W1.6-L | OPSCO | SK6812SIDE-A-RVS |  |  | not_at_digikey |  |  | C2890037 | SK6812SIDE-A-RVS | OPSCO Optoelectronics | extended | 19682 | 0.1064 | exact_extended | Exact MPN, SMD-4P 4x2mm side-view RGB with IC, 3.7–5.5V | not sold by DigiKey; fix 'LSCS' typo; Matches the existing LCSC code.; The existing value is an LCSC code, not a DigiKey number. DigiKey lookups for 'SK6812SIDE-A-RVS' and 'SK6812SIDE-A' both failed with no result. This OPSCO part does not appear to be carried by DigiKey
U10 | 1 | EMC2305-x-AP | Texas_RGV0016A_VQFN-16-1EP_4x4mm_P0.65mm_EP2.1x2.1mm_ThermalVias | Microchip Technology | EMC2305-1-AP-TR |  | EMC2305-1-AP-TR-ND | ok | 36056 | Active | C621415 | EMC2305-1-AP-TR | Microchip Tech | extended | 307 | 4.6206 | exact_extended | Exact MPN, QFN-16-EP(4x4), 3.0–3.6V | Need 10; stock 307 OK.; Listing min_qty 5000 (reel).
U11 | 1 | TUSB4041I | Texas_TQFP-64-1EP_10x10mm_P0.5mm_EP8x8mm_Mask4.44x4.44mm_ThermalVias | Texas Instruments | TUSB4041IPAPR |  | 296-43143-2-ND | ok | 141 | Active | C192089 | TUSB4041IPAPR | Texas Instruments | extended | 10 | 8.1435 | exact_extended (kept 2026-10-11) | Exact MPN, TQFP-64 (10x10) PowerPAD | LOW STOCK: live stock 10 = exactly the 10 needed, with no attrition margin. Order promptly or use DigiKey (141). Other listings at JLC (not checked as drop-ins): TUSB4041IPAP C2865272 (tray suffix of the same part, stock 2), TUSB4041IPAPQ1 C2879403 (stock 16), TUSB4041IPAPRQ1 C702377 (stock 5).; Listing min_qty 1000 (reel).
U12 | 1 | RT9742SNGV | TSOT-23_HandSoldering | RichTek | RT9742SNGV |  | 1028-RT9742SNGVTR-ND | ok | 6273 | Active | C3235509 | RT9742SNGV | Richtek Tech | extended | 888 | 0.4805 | exact_extended | Exact MPN, SOT-23-3, 500mA, 70mΩ
U13 | 1 | TLV75712PDBVR | SOT-23-5 | Texas Instruments | TLV75712PDBVR |  | 296-50412-2-ND | ok | 5 | Active | C1509296 | TLV75712PDBVR | Texas Instruments | extended | 5282 | 0.2774 | exact_extended | Exact MPN, 1.2V fixed, 1A, SOT-23-5 | LOW STOCK at DigiKey: 5 (need 10).
U16 | 1 | SN74AHCT1G125DCKR | SOT-353_SC-70-5 | Texas Instruments | SN74AHCT1G125DCKR | SN74AHCT1G125DRLR |  | not_checked (lookup failed) |  |  | C350557 | SN74AHCT1G125DCKR | Texas Instruments | extended | 16672 | 0.1123 | footprint change (decided 2026-10-11) | Same die in SC-70-5; pinout 1 OE, 2 A, 3 GND, 4 Y, 5 VCC identical to DRL (EasyEDA pin data for both). | SC-70-5 chosen over SOT-23-5 (C7484) because U16 sits 1.5-2.3 mm from C71/C70/R9/R52. Distributor = LCSC; Mouser 595-SNAHCT1G125DCKR had 0. Needs F8 and re-routing.
U17 | 1 | TCA9538DBR | DB0016A_N | Texas Instruments | TCA9538DBR |  | 296-43160-2-ND | ok | 21302 | Active | C2652331 | TCA9538DBR | Texas Instruments | extended | 1 | 1.5424 | hand-fit (decided 2026-10-11) | Exact part is listed at JLC, but live stock is 1 (need 10). The only other 9538 parts in SSOP-16 208mil are PCA9538DBR C2652330 and PCA9538DB C1542533, both with stock 0. The in-stock 9538 variants are TSSOP-16 or QFN, which is a different footprint. | Bought from DigiKey (296-43160-2-ND) and soldered after JLC assembly. Excluded from the placement file. JLC had 1.
U18 | 1 | RT9742GGJ5 | SOT-23-5 | RichTek | RT9742GGJ5 |  | 1028-1436-2-ND | ok | 13493 | Active | C250547 | RT9742GGJ5 | Richtek Tech | extended | 12755 | 0.1749 | exact_extended | Exact MPN, TSOT-23-5, 1A, 70mΩ
U19 | 1 | TPS3808G01DBVR | SOT-23-6 | Texas Instruments | TPS3808G01DBVR |  | 296-17188-2-ND | ok | 47841 | Active | C19653 | TPS3808G01DBVR | Texas Instruments | extended | 15774 | 0.4144 | exact_extended | Exact MPN, 405mV adj. threshold, open-drain, SOT-23-6
U20 | 1 | LP38693MP-3.3 | SOT-223-5 | Texas Instruments | LP38693MP-3.3/NOPB |  | LP38693MP-3.3/NOPBTR-ND | filled | 20199 | Active | C130904 | LP38693MP-3.3/NOPB | Texas Instruments | extended | 296 | 1.702 | exact_extended | Exact MPN, 3.3V, 500mA, enable, SOT-223-5 | Dist. P/N was blank; filled from MPN lookup. Listing min_qty 1000 (reel).
U21 | 1 | HD3SS3220RNHR | Texas_RNH0030A_WQFN-30-1EP_2.5x4.5mm_P0.4mm_EP1.2x3.2mm_ThermalVias | Texas Instruments | HD3SS3220RNHR |  | 296-48293-2-ND | filled | 2726 | Active | C165155 | HD3SS3220RNHR | Texas Instruments | extended | 2010 | 1.9463 | exact_extended | Exact MPN, WQFN-30-EP (2.5x4.5) | Dist. P/N was blank; filled from MPN lookup. Listing min_qty 3000 (reel). Temp range 0–70°C.
Y1 | 1 | OT252024MJBA4SL | Oscillator_SMD_ECS_2520MV-xxx-xx-4Pin_2.5x2.0mm | Seiko Epson | X1G0041710031 | ECS-2520MV-240-DN-TR |  | not_at_digikey |  |  | C70559 | X1G0041710031 | Seiko Epson | extended | 7235 | 0.5736 | candidate_reviewed (decided 2026-10-20) | SG-210STF 24 MHz CMOS, 1.6-3.6 V, +-50 ppm, -40..85 C; pin 1 ST (high or open = output), 2 GND, 3 OUT, 4 VCC (Epson datasheet) | YXC OT252024MJBA4SL (C669072) dropped to 1 at JLC on 2026-10-20. Distributor = LCSC C70559. JLC footprint OSC-SMD_4P-L2.5-W2.0-BL, same as the YXC part.
J1 J6 J10 J17 | 4 | USB-C | 216989-0001_MOL | Molex | 2169890001 |  | 900-2169890001TR-ND | ok | 17733 | Active | C3197955 | 2169890001 | MOLEX | extended | 4228 | 1.461 | exact_extended | exact MPN; Type-C USB 2.0, right angle, through hole, 5 A 30 V | Through-hole; needed 40 (4/board).; MPN matches (Molex 2169890001 USB-C 2.0 THT RA). TR reel number, DigiKey min qty 300 - for 10 boards order cut tape.
J2 | 1 | Conn_2x07_Male | PinHeader_2x07_P2.54mm_Vertical | BOOMELE(Boom Precision Elec) | 2.54-2*7PPin | 0010897140 |  | not_at_digikey |  |  | C71397 | 2.54-2*7PPin | BOOMELE(Boom Precision Elec) | extended | 21510 | 0.0925 | substitute_extended (decided 2026-10-12) | 2x7 male header, 2.54 mm, vertical, gold; 6 mm mating / 3 mm tail pins, 2.5 mm insulator (C-Grid: 6.1 / 2.8 mm, 2.29 mm). | Distributor = LCSC C71397. Replaces Molex 0010897142 (C561778), which has no footprint in JLC's library. JLC footprint HDR-TH_14P-P2.54-V-M-R2-C7-S2.54 matches ours.
J3 J19 | 2 | Conn_1x03_Male | PinHeader_1x03_P2.54mm_Vertical | Molex | 0022032031 |  | 900-0022032031-ND | ok | 18725 | Active | C505002 | 22032031 | MOLEX | extended | 7757 | 0.1559 | exact_extended | same Molex part (leading zeros dropped in LCSC MPN); 1x3P 2.54 mm THT tin | J19 not fitted (DNP); J3 fitted. Through-hole; 10 needed for J3 (20 if J19 were fitted).
J4 | 1 | Bus_M.2_Socket_M | M.2 M Key socket | TE Connectivity | 1-2199119-5 |  | A115902TR-ND | ok | 4919 | Active | C574849 | 1-2199119-5 | TE Connectivity | extended | 8065 | 1.2085 | exact_extended | exact MPN; 67P 0.5 mm M.2 edge connector, SMD RA, gold | MPN matches (TE M.2 67-pos socket). TR reel number, DigiKey min qty 1200 - for 10 boards order cut tape.
J5 | 1 | Conn_1x22_Female | Hirose_FH12-22S-0.5SH_1x22-1MP_P0.50mm_Horizontal | Hirose | FH12-22S-0.5SH55 |  | HFJ122TR-ND | ok | 18035 | Active | C597981 | FH12-22S-0.5SH(55) | HRS(Hirose) | extended | 1224 | 2.2965 | exact_extended | exact MPN; 22P 0.5 mm FFC/FPC, bottom contact, flip lock, 2 mm height | DigiKey MPN FH12-22S-0.5SH(55) = same part (parentheses only). TR reel number, DigiKey min qty 2000 - for 10 boards order cut tape.
J7 | 1 | Micro_SD_Card_Det | SDCARD_MOLEX_503398-1892 | Molex | 503398-1892 |  | WM11190TR-ND | filled | 60519 | Active | C428492 | 5033981892 | MOLEX | extended | 21655 | 1.1385 | exact_extended | same Molex part; microSD push-push, 1.28 mm height, SMD | was Farnell 2358234; Old value 2358234 is not a DigiKey number (Farnell). Lookup by '503398-1892' failed; '5033981892' returned WM11190TR-ND (Molex 5033981892 microSD push-push, card detect). TR reel number, DigiKey min q
J8 | 1 | Conn_2x20_Male | PinHeader_2x20_P2.54mm_Vertical | Wurth Elektronik | 61304021121 | 0010897400 | 732-5310-ND | filled | 10232 | Active | C5364405 | 61304021121 | Wurth Elektronik | extended | 192 | 1.575 | substitute_extended (decided 2026-10-11) | 2x20 2.54 mm THT vertical, gold, 3 A; insulator 2.54 mm vs 2.29 mm, mating pin 6 mm vs 6.1 mm, tail 3 mm vs 2.71 mm | Insulator 2.54 mm instead of 2.29 mm: a HAT sits 0.25 mm higher. Original Molex 0010897400 at DigiKey: WM19411-ND.
J11 | 1 | USB_C_Receptacle_USB2.0 | USB_C_Receptacle_GCT_USB4105-xx-A_16P_TopMnt_Horizontal | GCT | USB4105-GF-A-120 | USB4105-GF-A | 2073-USB4105-GF-A-120TR-ND | ok | 45542 | Active | C5184243 | USB4105-GF-A-120 | Global Connector Technology | extended | 1153 | 0.9152 | substitute_extended (decided 2026-10-12) | same GCT USB4105 series and PCB layout; shell stakes 1.20 mm instead of 0.95 mm (GCT drawing) | USB4105-GF-A (C3020560) went to 0 at JLC on 2026-10-12. -120 = 1.20 mm shell stakes; on the 1.6 mm board they do not protrude. JLC footprint USB-C-SMD_MC-311D matches ours exactly. Mouser 640-USB4105-GF-A-120 (88k). TR reel number, DigiKey min qty 800 - for 10 boards order cut tape.
J14 J16 | 2 | JST_BM04B-SRSS-TB | JST_SH_BM04B-SRSS-TB_1x04-1MP_P1.00mm_Vertical | JST | BM04B-SRSS-TB |  | 455-BM04B-SRSS-TBTR-ND | ok | 114263 | Active | C160390 | BM04B-SRSS-TB(LF)(SN) | JST | extended | 25177 | 0.2535 | exact_extended | same JST part with (LF)(SN) lead-free/tin suffix; 1x4P 1 mm SMD vertical, 1 A 50 V | Alt packaging variant BM04B-SRSS-TBT(LF)(SN) C495539 (stock 33296) also available.; MPN matches (JST SH 4-pos vertical SMD). TR reel number, DigiKey min qty 1500 - for 10 boards order cut tape.
J15 | 1 | USB_C_Receptacle | USB_C_Receptacle_Molex_105450-0101 | Molex | 1054500101 |  | WM12856TR-ND | ok | 66171 | Active | C134092 | 1054500101 | MOLEX | extended | 181730 | 0.8388 | exact_extended | exact MPN; Type-C 24P USB 3.2, SMD | MPN matches (Molex 1054500101 USB-C 3.2 Gen 2). TR reel number, DigiKey min qty 1300 - for 10 boards order cut tape.
J22 | 1 | Conn_HDMI | EDAC 690-019-298-412 | EDAC | 690-019-298-412 | 2086581051 |  | not_at_digikey |  |  | C5291558 | 690-019-298-412 | EDAC | extended | 1850 | 0.5895 | exact_extended (decided 2026-10-12) | HDMI-A 19P female, SMD right angle; the part our footprint (from the CM5 IO board) was drawn for | Distributor = LCSC C5291558 (not at DigiKey or Mouser). Replaces Molex 2086581051 (C5240402), which has no footprint in JLC's library and was never checked against the EDAC footprint. JLC footprint matches ours pad for pad.
J51 J52 J53 J54 | 4 | 12V Fan 1 | CONN_SD-47053-001_H10p00_MOL | Molex | 0470531000 |  | WM4330-ND | ok | 32196 | Active | C240840 | 470531000 | MOLEX | extended | 5440 | 0.1888 | exact_extended | same Molex part (leading zero dropped in LCSC MPN); 1x4P 2.54 mm THT | Through-hole; needed 40 (4/board). Lookup by '0470531000' failed; found as '470531000'.; MPN matches (Molex 0470531000, 4-pos 2.54 mm fan header, THT).
J100 J101 | 2 | Screw Terminal | KEYSTONE_7790 | Keystone | 7790 |  | 36-7790-ND | ok | 55101 | Active | C5187194 | 7790 | Keystone | extended | 242 | 0.9691 | exact_extended | exact MPN; 4 legs, M3, 15 A, brass/tin | Through-hole; needed 20 (2/board).; MPN matches (Keystone 7790, M3 4-pin PCB screw terminal, 15 A).
SW1 SW2 | 2 | Right angle Tact button | SW_Tactile_SPST_Angled_PTS645Vx39-2LFS | C&K | PTS645VK39-2 LFS | PTS645VH58-2 LFS | CKN10053-ND | filled | 9011 | Active | C285519 | PTS645VK392LFS | C&K | extended | 6513 | 0.5066 | substitute_extended (decided 2026-10-11) | same C&K PTS645 right-angle THT family, SPST, 12 V 50 mA; operating force 2.6 N vs 2 N; actuator code 39 vs 58 (shorter actuator) | 3.85 mm actuator instead of 5.85 mm; 2.6 N instead of 2 N. Footprint Vx39-2LFS has the same pads as Vx58/Vx31; needs F8.
BT1 | 1 | Battery_Cell | BAT_BAT-HLD-007-SMT-TR | Keystone Electronics | 3000TR | BAT-HLD-007-SMT-TR | 36-3000TR-ND | filled | 31741 | Active | C6997853 | 3000TR | Keystone | extended | 715 | 0.5847 | substitute_extended (decided 2026-10-11) | Keystone 3000 is the 12 mm SMD coin retainer the Linx part copies: + tabs at +-7.9 mm, - contact = round board pad under the cell (KiCad BatteryHolder_Keystone_3000_1x12mm matches the existing footprint). CR1216/1220/1225. | No footprint change. Side-loading CR1220 holders at JLC (XDCR-1220-006, KH-BS1220-2-SMT) were rejected: their drawings do not mark + and -.
Module1 Module2 | 2 | ComputeModule5-CM5 | CM5_Connector_A / CM5_Connector_B | Amphenol | 10164227-1001A1RLF | 10164227-1001A1RLF x2 | 609-10164227-1001A1RLFTR-ND | ok | 7351 | Active | C6782225 | 10164227-1001A1RLF | Amphenol ICC | extended | 7575 | 1.7753 | exact_extended (split 2026-10-11) | exact MPN; 100P 0.4 mm 2-row BTB receptacle, gold | Split 2026-10-11 into Module1 (pins 1-100, footprint CM5_Connector_A, also carries the four CM5 mounting holes and the module outline) and Module2 (pins 101-200, CM5_Connector_B), one placement-file entry each, origin at each connector centre. Needed 20 (2 per board). DigiKey min qty 5000 for the TR number; order cut tape for 10 boards.
M1 | 1 | M2x4mm screw |  | Misc. | N/A |  |  | digikey_not_checked |  |  |  |  |  |  |  |  | not_checked |  | Skipped per group notes: M2x4 screw for the M.2 card, fitted by hand, not assembled by JLC. McMaster 92000A011.; Skipped per group notes: mechanical, not assembled. Source from McMaster 92000A011 (PHCS M2-0.4 x 4 mm, stainless).
M2 M3 M4 M5 | 4 | M2-0.4mm nut |  | Sinhoo | SMTSO2015CTJ |  |  | not_at_digikey |  |  | C2916320 | SMTSO2015CTJ | Sinhoo | extended | 19215 | 0.0729 | hand-fit (decided 2026-10-11) | exact MPN; M2 x 1.5 mm SMT round nut, tin plated | Fitted by hand; no footprint in the design. LCSC only.
