256foundation/libreboard/libreboard.kicad_pcb

## KiCad design libreboard.kicad_pcb (2026-10-20)

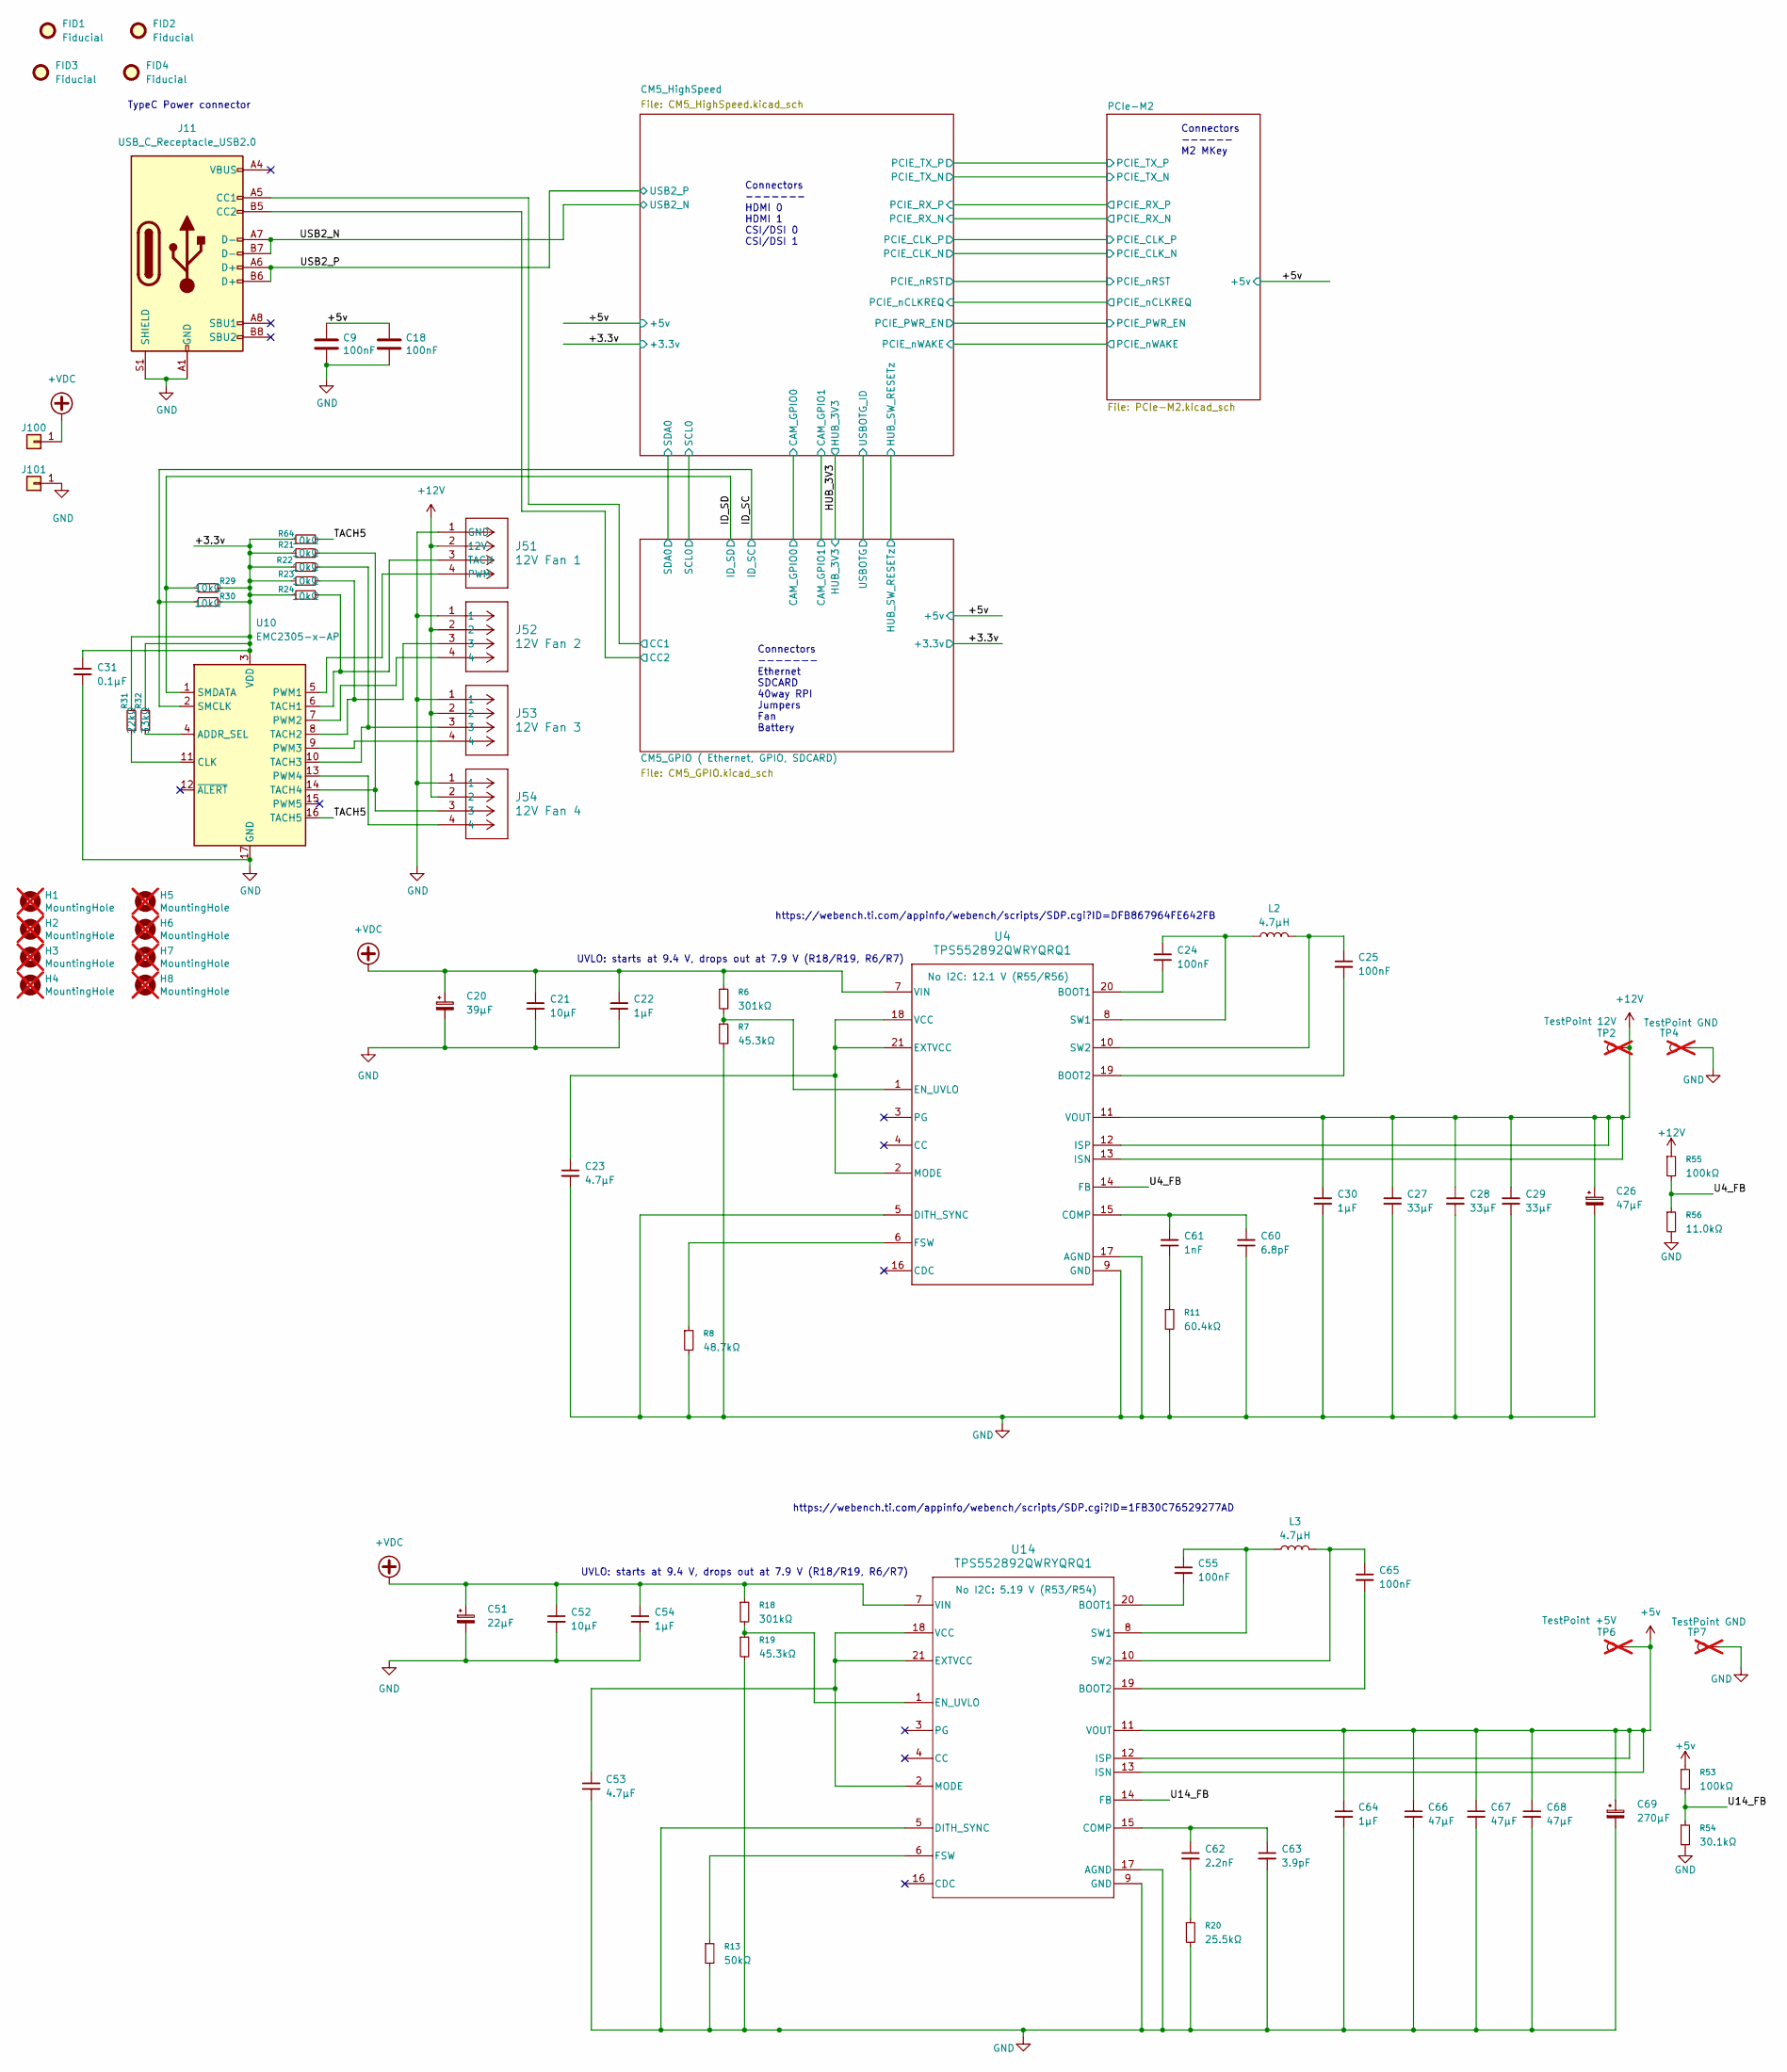
[picture p3: schematic libreboard.kicad_sch, Compute Module 5 IO Board - Top Level]

Parts:
C9, C18: 100nF; C_0402_1005Metric; Part Description Capacitor, Ceramic, 0.1µF, ±10%, 6.3V, 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; LCSC C1525
C20: 39µF; CP_Elec_8x6.7; Part Description Capacitor, Aluminum, 39µF, ±20%, 50V, 4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; LCSC C7059708
C21, C52: 10µF; C_0805_2012Metric; Part Description 10 µF ±10% 50V Ceramic Capacitor X5R 08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; LCSC C440198
C22, C30, C54: 1µF; C_0402_1005Metric; Part Description 1 µF ±10% 50V Ceramic Capacitor X5R 040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; LCSC C1518208
C23, C53: 4.7µF; C_1206_3216Metric; Part Description Capacitor, Ceramic, 4.7µF, ±10%, 50V, X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; LCSC C29823
C24, C25, C55, C65: 100nF; C_0402_1005Metric; Part Description CAP CER 0.1UF 50V X7R 0402; LCSC C307331
C26: 47µF; CP_Elec_5x5.9; Part Description Capacitor, Polymer Aluminum, 47µF, ±20%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; LCSC C54864098
C27, C28, C29: 33µF; C_1206_3216Metric; Part Description 33 µF ±20% 25V Ceramic Capacitor X5R 12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; LCSC C342307
C31: 0.1µF; C_0402_1005Metric; Part Description Capacitor, Ceramic, 0.1µF, ±10%, 6.3V, 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; LCSC C1525
C51: 22µF; CP_Elec_6.3x5.9; Part Description Capacitor, Aluminum, 22µF, ±20%, 50V, 4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; LCSC C46550474
C60: 6.8pF; C_0402_1005Metric; Part Description Capacitor, Ceramic, 6.8pF, ±0.25pF, 50V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; LCSC C1576
C61: 1nF; C_0402_1005Metric; Part Description Capacitor, Ceramic, 1nF, ±5%, 50V, C0G/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; LCSC C76947
C62: 2.2nF; C_0402_1005Metric; Part Description Capacitor, Ceramic, 2.2nF, ±10%, 50V, X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; LCSC C1531
C63: 3.9pF; C_0402_1005Metric; Part Description Capacitor, Ceramic, 3.9pF, ±2.5%, 50V, 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; LCSC C1517504
C64: 1µF; C_0402_1005Metric; Part Description Capacitor, Ceramic, 1µF, ±10%, 6.3V, X5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; LCSC C52923
C66, C67, C68: 47µF; C_1206_3216Metric; Part Description 47 µF ±20% 10V Ceramic Capacitor X5R 12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; LCSC C96123
C69: 270µF; CP_Elec_6.3x9.9; Part Description Capacitor, Aluminum, 270µF, ±20%, 10V, 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; LCSC C2944013
FID1, FID2, FID3, FID4: Fiducial; Fiducial_1mm_Mask2mm
H1, H2, H3, H4, H5, H6, H7, H8: MountingHole; MountingHole_2.7mm_M2.5_DIN965; Part Description M2.5 mounting hole; not fitted
J11: USB_C_Receptacle_USB2.0; USB_C_Receptacle_GCT_USB4105-xx-A_16P_TopMnt_Horizontal; Part Description Connector, USB-C, 2.0 data and power; LCSC C5184243
J51: 12V Fan 1; CONN_SD-47053-001_H10p00_MOL; Part Description Connector, Fan 1, 12V, 4 pin; LCSC C240840
J52: 12V Fan 2; CONN_SD-47053-001_H10p00_MOL; Part Description Connector, Fan 2, 12V, 4 pin; LCSC C240840
J53: 12V Fan 3; CONN_SD-47053-001_H10p00_MOL; Part Description Connector, Fan 3, 12V, 4 pin; LCSC C240840
J54: 12V Fan 4; CONN_SD-47053-001_H10p00_MOL; Part Description Connector, Fan 4, 12V, 4 pin; LCSC C240840
J100, J101: Screw Terminal; KEYSTONE_7790; PARTNO 36-7770; LCSC C5187194
L2, L3: 4.7µH; L_Bourns_SRN8040TA; Part Description FIXED IND 4.7UH 4.1A 24 MOHM SMD; LCSC C6685196
R6, R18: 301kΩ; R_0402_1005Metric; Part Description Resistor, 301kΩ, ±1%, 0.1W, SMD 0402 (1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; LCSC C7209900
R7, R19: 45.3kΩ; R_0402_1005Metric; Part Description Resistor, 45.3kΩ, ±1%, 0.1W, SMD 0402 (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; LCSC C2986582
R8: 48.7kΩ; R_0402_1005Metric; Part Description Resistor, 48.7kΩ, ±1%, 0.1W, SMD 0402 (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; LCSC C2077134
R11: 60.4kΩ; R_0402_1005Metric; Part Description Resistor, 60.4kΩ, ±1%, 0.1W, SMD 0402 (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; LCSC C2986234
R13: 50kΩ; R_0402_1005Metric; Part Description Resistor, 50kΩ, ±1%, 0.1W, SMD 0402 (10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; LCSC C7501196
R20: 25.5kΩ; R_0402_1005Metric; Part Description Resistor, 25.5kΩ, ±1%, 0.1W, SMD 0402 (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; LCSC C2076811
R21, R22, R23, R24, R29, R30, R64: 10kΩ; R_0402_1005Metric; Part Description Resistor, 10kΩ, ±1%, 0.1W, SMD 0402 (10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; LCSC C25744
R31: 22kΩ; R_0402_1005Metric; Part Description Resistor, 22kΩ, ±1%, 0.1W, SMD 0402 (10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; LCSC C25768
R32: 33kΩ; R_0402_1005Metric; Part Description Resistor, 33kΩ, ±1%, 0.1W, SMD 0402 (10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; LCSC C25779
R53, R55: 100kΩ; R_0402_1005Metric; Part Description Resistor, 100kΩ, ±1%, 0.1W, SMD 0402 (1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; LCSC C25741
R54: 30.1kΩ; R_0402_1005Metric; Part Description Resistor, 30.1kΩ, ±1%, 0.1W, SMD 0402 (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; LCSC C2076806
R56: 11.0kΩ; R_0402_1005Metric; Part Description Resistor, 11.0kΩ, ±1%, 0.1W, SMD 0402 (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; LCSC C409880
TP2: TestPoint 12V; TestPoint_Pad_D1.5mm; Part Description Test point; not fitted
TP4, TP7: TestPoint GND; TestPoint_Pad_D1.5mm; Part Description Test point; not fitted
TP6: TestPoint +5V; TestPoint_Pad_D1.5mm; Part Description Test point; not fitted
U4, U14: TPS552892QWRYQRQ1; RYQ0021A-MFG; Part Description IC, Buck Boost, 0.8-22V, 1-output, 8A, 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; LCSC C22375748
U10: EMC2305-x-AP; Texas_RGV0016A_VQFN-16-1EP_4x4mm_P0.65mm_EP2.1x2.1mm_Therma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; Part Description Motor Driver, PWM, 16-QFN, 4x4; LCSC C621415

Connections:
+5v: C9.1, C18.1, C64.1, C66.1, C67.1, C68.1, C69.1, R53.1, TP6.1 (1_1), U14.11 (VOUT), U14.12 (ISP), U14.13 (ISN); also elsewhere on the board
+12V: C26.1, C27.1, C28.1, C29.1, C30.1, J51.2 (12V), J52.2, J53.2, J54.2, R55.1, TP2.1 (1_1), U4.11 (VOUT), U4.12 (ISP), U4.13 (ISN)
+VDC: C20.1, C21.1, C22.1, C51.1, C52.1, C54.1, J100.1 (Pin_1_1), R6.1, R18.1, U4.7 (VIN), U14.7 (VIN)
/+3.3v: C31.1, R21.1, R22.1, R23.1, R24.1, R29.2, R30.2, R31.2, R32.2, R64.1, U10.3 (VDD); also elsewhere on the board
/CM5_GPIO ( Ethernet, GPIO, SDCARD)/CC1: J11.A5 (CC1); also elsewhere on the board
/CM5_GPIO ( Ethernet, GPIO, SDCARD)/CC2: J11.B5 (CC2); also elsewhere on the board
/ID_SC: R30.1, U10.2 (SMCLK); also elsewhere on the board
/ID_SD: R29.1, U10.1 (SMDATA); also elsewhere on the board
/TACH5: R64.2, U10.16 (TACH5)
/U4_FB: R55.2, R56.1, U4.14 (FB)
/U14_FB: R53.2, R54.1, U14.14 (FB)
/USB2_N: J11.A7 (D-), J11.B7 (D-); also elsewhere on the board
/USB2_P: J11.A6 (D+), J11.B6 (D+); also elsewhere on the board
GND: C9.2, C18.2, C20.2, C21.2, C22.2, C23.2, C26.2, C27.2, C28.2, C29.2, C30.2, C31.2, C51.2, C52.2, C53.2, C54.2, C60.2, C63.2, C64.2, C66.2, C67.2, C68.2, C69.2, J11.A1 (GND), J11.A12 (GND), J11.B1 (GND), J11.B12 (GND), J11.S1 (SHIELD), J51.1 (GND), J52.1, J53.1, J54.1, J101.1 (Pin_1_1), R7.2, R8.2, R11.2, R13.2, R19.2, R20.2, R54.2, R56.2, TP4.1 (1_1), TP7.1 (1_1), U4.5 (DITH_SYNC), U4.9 (GND), U4.17 (AGND), U10.17 (GND), U14.5 (DITH_SYNC), U14.9 (GND), U14.17 (AGND); also elsewhere on the board
unnamed: C61.2, R11.1
unnamed: C62.2, R20.1
unnamed: J51.4 (PWM), U10.5 (PWM1)
unnamed: J51.3 (TACH), R24.2, U10.6 (TACH1)
unnamed: C24.2, U4.20 (BOOT1)
unnamed: C25.2, U4.19 (BOOT2)
unnamed: C60.1, C61.1, U4.15 (COMP)
unnamed: R6.2, R7.1, U4.1 (EN_UVLO)
unnamed: C23.1, U4.2 (MODE), U4.18 (VCC), U4.21 (EXTVCC)
unnamed: R8.1, U4.6 (FSW)
unnamed: C24.1, L2.1, U4.8 (SW1)
unnamed: C25.1, L2.2, U4.10 (SW2)
unnamed: R32.1, U10.4 (ADDR_SEL)
unnamed: R31.1, U10.11 (CLK)
unnamed: J52.4, U10.7 (PWM2)
unnamed: J53.4, U10.9 (PWM3)
unnamed: J54.4, U10.13 (PWM4)
unnamed: J52.3, R23.2, U10.8 (TACH2)
unnamed: J53.3, R22.2, U10.10 (TACH3)
unnamed: J54.3, R21.2, U10.14 (TACH4)
unnamed: C55.2, U14.20 (BOOT1)
unnamed: C65.2, U14.19 (BOOT2)
unnamed: C62.1, C63.1, U14.15 (COMP)
unnamed: R18.2, R19.1, U14.1 (EN_UVLO)
unnamed: C53.1, U14.2 (MODE), U14.18 (VCC), U14.21 (EXTVCC)
unnamed: R13.1, U14.6 (FSW)
unnamed: C55.1, L3.1, U14.8 (SW1)
unnamed: C65.1, L3.2, U14.10 (SW2)

Notes on the sheet:
Connectors ------- Ethernet SDCARD 40way RPI Jumpers Fan Battery
Connectors ------ M2 MKey
UVLO: starts at 9.4 V, drops out at 7.9 V (R18/R19, R6/R7)
TypeC Power connector
Connectors ------- HDMI 0 HDMI 1 CSI/DSI 0 CSI/DSI 1
https://webench.ti.com/appinfo/webench/scripts/SDP.cgi?ID=1FB30C76529277AD
https://webench.ti.com/appinfo/webench/scripts/SDP.cgi?ID=DFB867964FE642FB

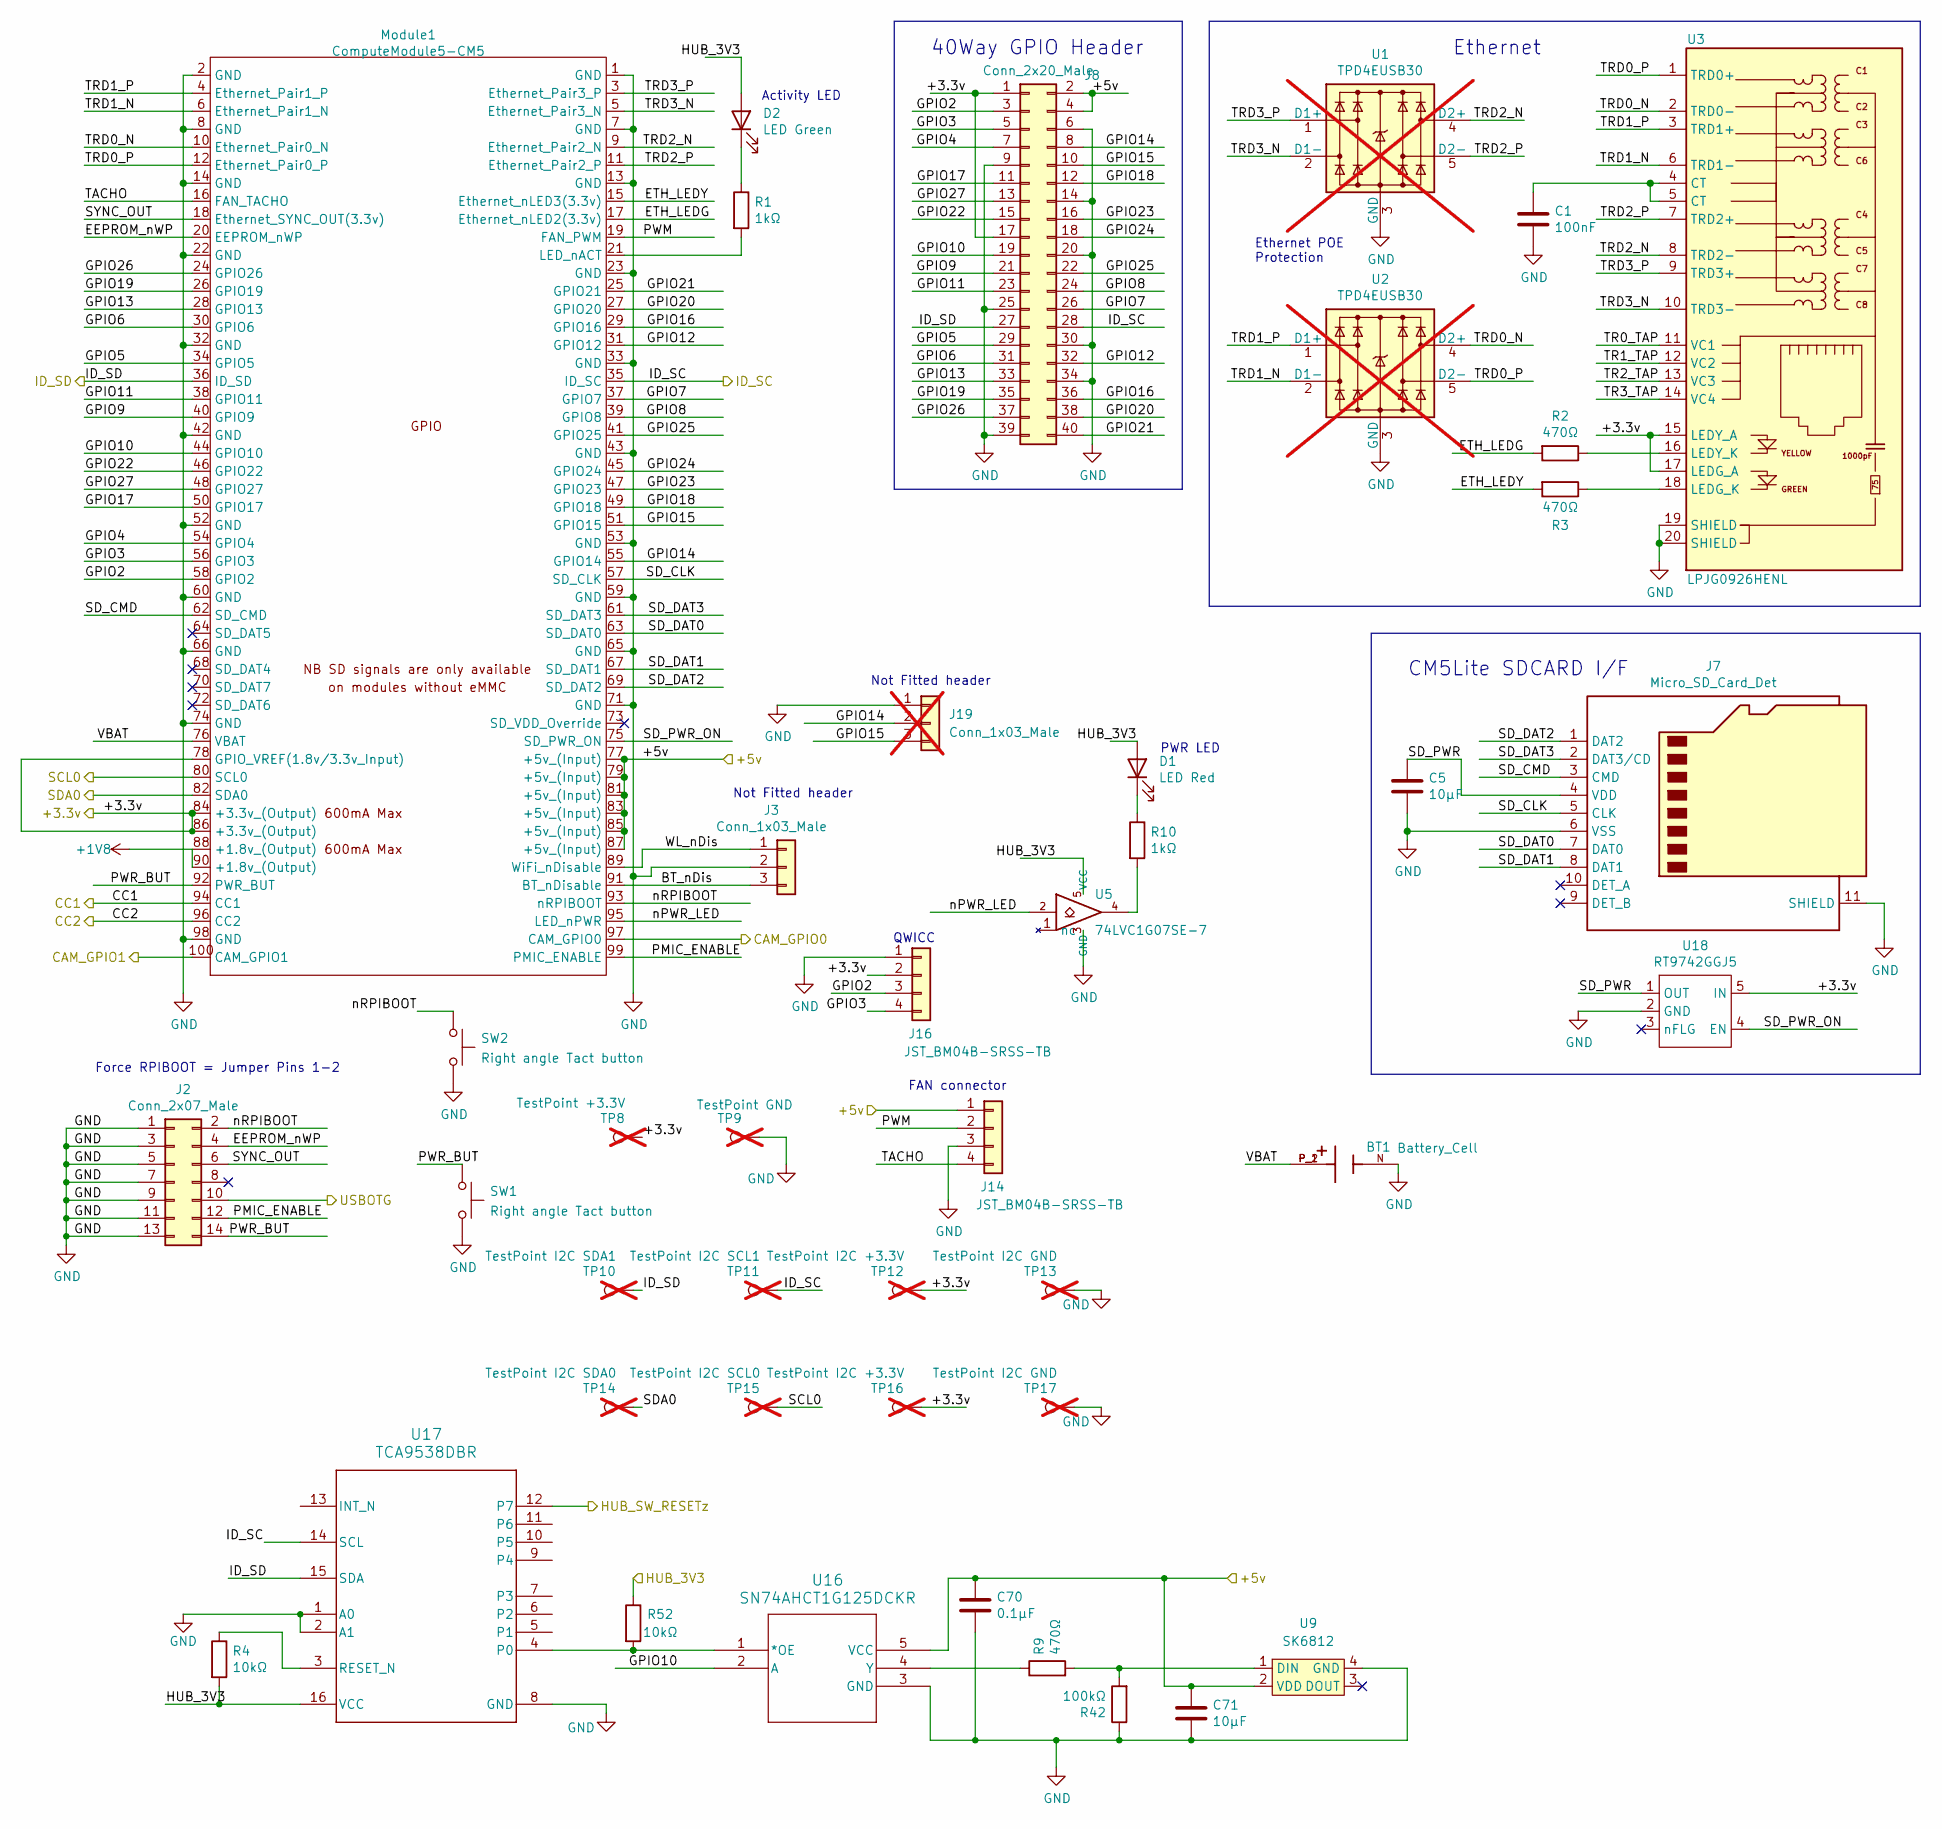
[picture p4: schematic CM5_GPIO.kicad_sch, Compute Module 5 IO Board - GPIO - Ethernet]

Parts:
BT1: Battery_Cell; BAT_BAT-HLD-007-SMT-TR; Part Description BATTERY RETAINER COIN 12MM SMD (CR1216/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; LCSC C6997853
C1: 100nF; C_0402_1005Metric; Part Description Capacitor, Ceramic, 0.1µF, ±10%, 6.3V, 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; LCSC C1525
C5: 10µF; C_0805_2012Metric; Part Description Capacitor, Ceramic, 10µF, ±10%, 10V, X5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; LCSC C15850
C70: 0.1µF; C_0402_1005Metric; Part Description Capacitor, Ceramic, 0.1µF, ±10%, 6.3V, 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; LCSC C1525
C71: 10µF; C_0402_1005Metric; Part Description Capacitor, Ceramic, 10µF, ±20%, 10V, X5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; LCSC C408132
D1: LED Red; LED_0603_1608Metric; Part Description LED, Red, 620nm, 2.2V, SMD 0603; LCSC C125114
D2: LED Green; LED_0603_1608Metric; Part Description LED, Green, 572nm, 2.2V, SMD 0603; LCSC C125113
J2: Conn_2x07_Male; PinHeader_2x07_P2.54mm_Vertical; Part Description Pin Header, Male, 2x07, 2.54mm P, Verti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; LCSC C71397
J3: Conn_1x03_Male; PinHeader_1x03_P2.54mm_Vertical; Part Description Pin Header, Male, 1x03, 2.54mm P, Verti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; LCSC C505002
J7: Micro_SD_Card_Det; SDCARD_MOLEX_503398-1892; Part Description 9 (8 + 1) Position Card Connector micro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; LCSC C428492
J8: Conn_2x20_Male; PinHeader_2x20_P2.54mm_Vertical; Part Description Pin Header, Male, 2x20, 2.54mm P, Verti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; LCSC C5364405
J14, J16: JST_BM04B-SRSS-TB; JST_SH_BM04B-SRSS-TB_1x04-1MP_P1.00mm_Vertical; Part Description Connector, Male, 1x04, vertical, 1mm P; LCSC C160390
J19: Conn_1x03_Male; PinHeader_1x03_P2.54mm_Vertical; Part Description Pin Header, Male, 1x03, 2.54mm P, Verti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; LCSC C505002; not fitted
Module1: ComputeModule5-CM5; CM5_Connector_A; Part Description Connector, CM Receptacle, 100 pin, 0.4m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
R1, R10: 1kΩ; R_0402_1005Metric; Part Description Resistor, 1kΩ, ±1%, 0.1W, SMD 0402 (100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; LCSC C11702
R2, R3, R9: 470Ω; R_0402_1005Metric; Part Description Resistor, 470Ω, ±1%, 0.1W, SMD 0402 (10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; LCSC C25117
R4, R52: 10kΩ; R_0402_1005Metric; Part Description Resistor, 10kΩ, ±1%, 0.1W, SMD 0402 (10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; LCSC C25744
R42: 100kΩ; R_0402_1005Metric; Part Description Resistor, 100kΩ, ±1%, 0.1W, SMD 0402 (1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; LCSC C25741
SW1, SW2: Right angle Tact button; SW_Tactile_SPST_Angled_PTS645Vx39-2LFS; Part Description Switch, Tactile, SPST-NO, Right Angle; LCSC C285519
TP8: TestPoint +3.3V; TestPoint_Pad_D1.5mm; Part Description Test point; not fitted
TP9: TestPoint GND; TestPoint_Pad_D1.5mm; Part Description Test point; not fitted
TP10: TestPoint I2C SDA1; TestPoint_Pad_D1.0mm; Part Description Test point; not fitted
TP11: TestPoint I2C SCL1; TestPoint_Pad_D1.0mm; Part Description Test point; not fitted
TP12, TP16: TestPoint I2C +3.3V; TestPoint_Pad_D1.5mm; Part Description Test point; not fitted
TP13, TP17: TestPoint I2C GND; TestPoint_Pad_D1.5mm; Part Description Test point; not fitted
TP14: TestPoint I2C SDA0; TestPoint_Pad_D1.5mm; Part Description Test point; not fitted
TP15: TestPoint I2C SCL0; TestPoint_Pad_D1.5mm; Part Description Test point; not fitted
U1, U2: TPD4EUSB30; USON-10_2.5x1.0mm_P0.5mm; Part Description Diode, TVS, 8V clamp, 1A; LCSC C90627; not fitted
U3: LPJG0926HENL; TRJG0926HENL; Part Description Receptacle, RJ45, 1Gb; LCSC C22457393
U5: 74LVC1G07SE-7; SOT-353_SC-70-5; Part Description Buffer, Non-Inverting, 1 Element, 1 Bit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; LCSC C67531
U9: SK6812; LED-SMD_4P-L4.0-W1.6-L; Part Description LED, RGB, 475-620nm, 3.7v-5.5v, SMD; LCSC C2890037
U16: SN74AHCT1G125DCKR; SOT-353_SC-70-5; Part Description Buffer, Non-Inverting 1 Element 1 Bit p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; LCSC C350557
U17: TCA9538DBR; DB0016A_N; Part Description I/O Expander 8 I2C 400 kHz 16-SSOP; LCSC C2652331
U18: RT9742GGJ5; SOT-23-5; Part Description Power Switch/Driver, 1:1, N-Channel, 1A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; LCSC C250547

Connections:
+1V8: Module1.88 (+1.8v_(Output)), Module1.90 (+1.8v_(Output)); also elsewhere on the board
+5v: C70.1, C71.1, J8.2, J8.4, J14.1, Module1.77 (+5v_(Input)), Module1.79 (+5v_(Input)), Module1.81 (+5v_(Input)), Module1.83 (+5v_(Input)), Module1.85 (+5v_(Input)), Module1.87 (+5v_(Input)), U9.2 (VDD), U16.5 (VCC); also elsewhere on the board
/+3.3v: J8.1, J8.17, J16.2, Module1.78 (GPIO_VREF(1.8v/3.3v_Input)), Module1.84 (+3.3v_(Output)), Module1.86 (+3.3v_(Output)), TP8.1 (1_1), TP12.1 (1_1), TP16.1 (1_1), U3.15 (LEDY_A), U3.17 (LEDG_A), U18.5 (IN); also elsewhere on the board
/CM5_GPIO ( Ethernet, GPIO, SDCARD)/BT_nDis: J3.3, Module1.91 (BT_nDisable)
/CM5_GPIO ( Ethernet, GPIO, SDCARD)/CAM_GPIO0: Module1.97 (CAM_GPIO0); also elsewhere on the board
/CM5_GPIO ( Ethernet, GPIO, SDCARD)/CAM_GPIO1: Module1.100 (CAM_GPIO1); also elsewhere on the board
/CM5_GPIO ( Ethernet, GPIO, SDCARD)/CC1: Module1.94 (CC1); also elsewhere on the board
/CM5_GPIO ( Ethernet, GPIO, SDCARD)/CC2: Module1.96 (CC2); also elsewhere on the board
/CM5_GPIO ( Ethernet, GPIO, SDCARD)/EEPROM_nWP: J2.4, Module1.20 (EEPROM_nWP)
/CM5_GPIO ( Ethernet, GPIO, SDCARD)/ETH_LEDG: Module1.17 (Ethernet_nLED2(3.3v)), R2.2
/CM5_GPIO ( Ethernet, GPIO, SDCARD)/ETH_LEDY: Module1.15 (Ethernet_nLED3(3.3v)), R3.2
/CM5_GPIO ( Ethernet, GPIO, SDCARD)/GPIO2: J8.3, J16.3, Module1.58 (GPIO2)
/CM5_GPIO ( Ethernet, GPIO, SDCARD)/GPIO3: J8.5, J16.4, Module1.56 (GPIO3)
/CM5_GPIO ( Ethernet, GPIO, SDCARD)/GPIO4: J8.7, Module1.54 (GPIO4)
/CM5_GPIO ( Ethernet, GPIO, SDCARD)/GPIO5: J8.29, Module1.34 (GPIO5)
/CM5_GPIO ( Ethernet, GPIO, SDCARD)/GPIO6: J8.31, Module1.30 (GPIO6)
/CM5_GPIO ( Ethernet, GPIO, SDCARD)/GPIO7: J8.26, Module1.37 (GPIO7)
/CM5_GPIO ( Ethernet, GPIO, SDCARD)/GPIO8: J8.24, Module1.39 (GPIO8)
/CM5_GPIO ( Ethernet, GPIO, SDCARD)/GPIO9: J8.21, Module1.40 (GPIO9)
/CM5_GPIO ( Ethernet, GPIO, SDCARD)/GPIO10: J8.19, Module1.44 (GPIO10), U16.2 (A)
/CM5_GPIO ( Ethernet, GPIO, SDCARD)/GPIO11: J8.23, Module1.38 (GPIO11)
/CM5_GPIO ( Ethernet, GPIO, SDCARD)/GPIO12: J8.32, Module1.31 (GPIO12)
/CM5_GPIO ( Ethernet, GPIO, SDCARD)/GPIO13: J8.33, Module1.28 (GPIO13)
/CM5_GPIO ( Ethernet, GPIO, SDCARD)/GPIO14: J8.8, J19.2, Module1.55 (GPIO14)
/CM5_GPIO ( Ethernet, GPIO, SDCARD)/GPIO15: J8.10, J19.3, Module1.51 (GPIO15)
/CM5_GPIO ( Ethernet, GPIO, SDCARD)/GPIO16: J8.36, Module1.29 (GPIO16)
/CM5_GPIO ( Ethernet, GPIO, SDCARD)/GPIO17: J8.11, Module1.50 (GPIO17)
/CM5_GPIO ( Ethernet, GPIO, SDCARD)/GPIO18: J8.12, Module1.49 (GPIO18)
/CM5_GPIO ( Ethernet, GPIO, SDCARD)/GPIO19: J8.35, Module1.26 (GPIO19)
/CM5_GPIO ( Ethernet, GPIO, SDCARD)/GPIO20: J8.38, Module1.27 (GPIO20)
/CM5_GPIO ( Ethernet, GPIO, SDCARD)/GPIO21: J8.40, Module1.25 (GPIO21)
/CM5_GPIO ( Ethernet, GPIO, SDCARD)/GPIO22: J8.15, Module1.46 (GPIO22)
/CM5_GPIO ( Ethernet, GPIO, SDCARD)/GPIO23: J8.16, Module1.47 (GPIO23)
/CM5_GPIO ( Ethernet, GPIO, SDCARD)/GPIO24: J8.18, Module1.45 (GPIO24)
/CM5_GPIO ( Ethernet, GPIO, SDCARD)/GPIO25: J8.22, Module1.41 (GPIO25)
/CM5_GPIO ( Ethernet, GPIO, SDCARD)/GPIO26: J8.37, Module1.24 (GPIO26)
/CM5_GPIO ( Ethernet, GPIO, SDCARD)/GPIO27: J8.13, Module1.48 (GPIO27)
/CM5_GPIO ( Ethernet, GPIO, SDCARD)/HUB_SW_RESETz: U17.12 (P7); also elsewhere on the board
/CM5_GPIO ( Ethernet, GPIO, SDCARD)/PMIC_ENABLE: J2.12, Module1.99 (PMIC_ENABLE)
/CM5_GPIO ( Ethernet, GPIO, SDCARD)/PWM: J14.2, Module1.19 (FAN_PWM)
/CM5_GPIO ( Ethernet, GPIO, SDCARD)/PWR_BUT: J2.14, Module1.92 (PWR_BUT), SW1.1
/CM5_GPIO ( Ethernet, GPIO, SDCARD)/SCL0: Module1.80 (SCL0), TP15.1 (1_1); also elsewhere on the board
/CM5_GPIO ( Ethernet, GPIO, SDCARD)/SDA0: Module1.82 (SDA0), TP14.1 (1_1); also elsewhere on the board
/CM5_GPIO ( Ethernet, GPIO, SDCARD)/SD_CLK: J7.5 (CLK), Module1.57 (SD_CLK)
/CM5_GPIO ( Ethernet, GPIO, SDCARD)/SD_CMD: J7.3 (CMD), Module1.62 (SD_CMD)
/CM5_GPIO ( Ethernet, GPIO, SDCARD)/SD_DAT0: J7.7 (DAT0), Module1.63 (SD_DAT0)
/CM5_GPIO ( Ethernet, GPIO, SDCARD)/SD_DAT1: J7.8 (DAT1), Module1.67 (SD_DAT1)
/CM5_GPIO ( Ethernet, GPIO, SDCARD)/SD_DAT2: J7.1 (DAT2), Module1.69 (SD_DAT2)
/CM5_GPIO ( Ethernet, GPIO, SDCARD)/SD_DAT3: J7.2 (DAT3/CD), Module1.61 (SD_DAT3)
/CM5_GPIO ( Ethernet, GPIO, SDCARD)/SD_PWR: C5.1, J7.4 (VDD), U18.1 (OUT)
/CM5_GPIO ( Ethernet, GPIO, SDCARD)/SD_PWR_ON: Module1.75 (SD_PWR_ON), U18.4 (EN)
/CM5_GPIO ( Ethernet, GPIO, SDCARD)/SYNC_OUT: J2.6, Module1.18 (Ethernet_SYNC_OUT(3.3v))
/CM5_GPIO ( Ethernet, GPIO, SDCARD)/TACHO: J14.4, Module1.16 (FAN_TACHO)
/CM5_GPIO ( Ethernet, GPIO, SDCARD)/TR0_TAP: U3.11 (VC1)
/CM5_GPIO ( Ethernet, GPIO, SDCARD)/TR1_TAP: U3.12 (VC2)
/CM5_GPIO ( Ethernet, GPIO, SDCARD)/TR2_TAP: U3.13 (VC3)
/CM5_GPIO ( Ethernet, GPIO, SDCARD)/TR3_TAP: U3.14 (VC4)
/CM5_GPIO ( Ethernet, GPIO, SDCARD)/TRD0_N: Module1.10 (Ethernet_Pair0_N), U2.4 (D2+), U2.7, U3.2 (TRD0-)
/CM5_GPIO ( Ethernet, GPIO, SDCARD)/TRD0_P: Module1.12 (Ethernet_Pair0_P), U2.5 (D2-), U2.6, U3.1 (TRD0+)
/CM5_GPIO ( Ethernet, GPIO, SDCARD)/TRD1_N: Module1.6 (Ethernet_Pair1_N), U2.2 (D1-), U2.9, U3.6 (TRD1-)
/CM5_GPIO ( Ethernet, GPIO, SDCARD)/TRD1_P: Module1.4 (Ethernet_Pair1_P), U2.1 (D1+), U2.10, U3.3 (TRD1+)
/CM5_GPIO ( Ethernet, GPIO, SDCARD)/TRD2_N: Module1.9 (Ethernet_Pair2_N), U1.4 (D2+), U1.7, U3.8 (TRD2-)
/CM5_GPIO ( Ethernet, GPIO, SDCARD)/TRD2_P: Module1.11 (Ethernet_Pair2_P), U1.5 (D2-), U1.6, U3.7 (TRD2+)
/CM5_GPIO ( Ethernet, GPIO, SDCARD)/TRD3_N: Module1.5 (Ethernet_Pair3_N), U1.2 (D1-), U1.9, U3.10 (TRD3-)
/CM5_GPIO ( Ethernet, GPIO, SDCARD)/TRD3_P: Module1.3 (Ethernet_Pair3_P), U1.1 (D1+), U1.10, U3.9 (TRD3+)
/CM5_GPIO ( Ethernet, GPIO, SDCARD)/USBOTG: J2.10; also elsewhere on the board
/CM5_GPIO ( Ethernet, GPIO, SDCARD)/VBAT: BT1.P_1, BT1.P_2, Module1.76 (VBAT)
/CM5_GPIO ( Ethernet, GPIO, SDCARD)/WL_nDis: J3.1, Module1.89 (WiFi_nDisable)
/CM5_GPIO ( Ethernet, GPIO, SDCARD)/nPWR_LED: Module1.95 (LED_nPWR), U5.2
/CM5_GPIO ( Ethernet, GPIO, SDCARD)/nRPIBOOT: J2.2, Module1.93 (nRPIBOOT), SW2.1
/HUB_3V3: D1.2 (A), D2.2 (A), R4.2, R52.1, U5.5 (VCC), U17.16 (VCC); also elsewhere on the board
/ID_SC: J8.28, Module1.35 (ID_SC), TP11.1 (1_1), U17.14 (SCL); also elsewhere on the board
/ID_SD: J8.27, Module1.36 (ID_SD), TP10.1 (1_1), U17.15 (SDA); also elsewhere on the board
GND: BT1.N, C1.2, C5.2, C70.2, C71.2, J2.1, J2.3, J2.5, J2.7, J2.9, J2.11, J2.13, J3.2, J7.6 (VSS), J7.11 (SHIELD), J8.6, J8.9, J8.14, J8.20, J8.25, J8.30, J8.34, J8.39, J14.3, J16.1, J19.1, Module1.1 (GND), Module1.2 (GND), Module1.7 (GND), Module1.8 (GND), Module1.13 (GND), Module1.14 (GND), Module1.22 (GND), Module1.23 (GND), Module1.32 (GND), Module1.33 (GND), Module1.42 (GND), Module1.43 (GND), Module1.52 (GND), Module1.53 (GND), Module1.59 (GND), Module1.60 (GND), Module1.65 (GND), Module1.66 (GND), Module1.71 (GND), Module1.74 (GND), Module1.98 (GND), R42.1, SW1.2, SW2.2, TP9.1 (1_1), TP13.1 (1_1), TP17.1 (1_1), U1.3 (GND), U1.8 (GND), U2.3 (GND), U2.8 (GND), U3.19 (SHIELD), U3.20 (SHIELD), U5.3 (GND), U9.4 (GND), U16.3 (GND), U17.1 (A0), U17.2 (A1), U17.8 (GND), U18.2 (GND); also elsewhere on the board
unnamed: C1.1, U3.4 (CT), U3.5 (CT)
unnamed: D1.1 (K), R10.1
unnamed: D2.1 (K), R1.1
unnamed: Module1.21 (LED_nACT), R1.2
unnamed: R10.2, U5.4
unnamed: R3.1, U3.18 (LEDG_K)
unnamed: R2.1, U3.16 (LEDY_K)
unnamed: R9.2, R42.2, U9.1 (DIN)
unnamed: R52.2, U16.1 (*OE), U17.4 (P0)
unnamed: R9.1, U16.4 (Y)
unnamed: R4.1, U17.3 (RESET_N)

Notes on the sheet:
QWICC
40Way GPIO Header
Activity LED
FAN connector
Ethernet POE Protection
Not Fitted header
Force RPIBOOT = Jumper Pins 1-2
PWR LED
Ethernet
CM5Lite SDCARD I/F
