256foundation/libreboard/libreboard.kicad_pcb

## KiCad design libreboard.kicad_pcb (continued)

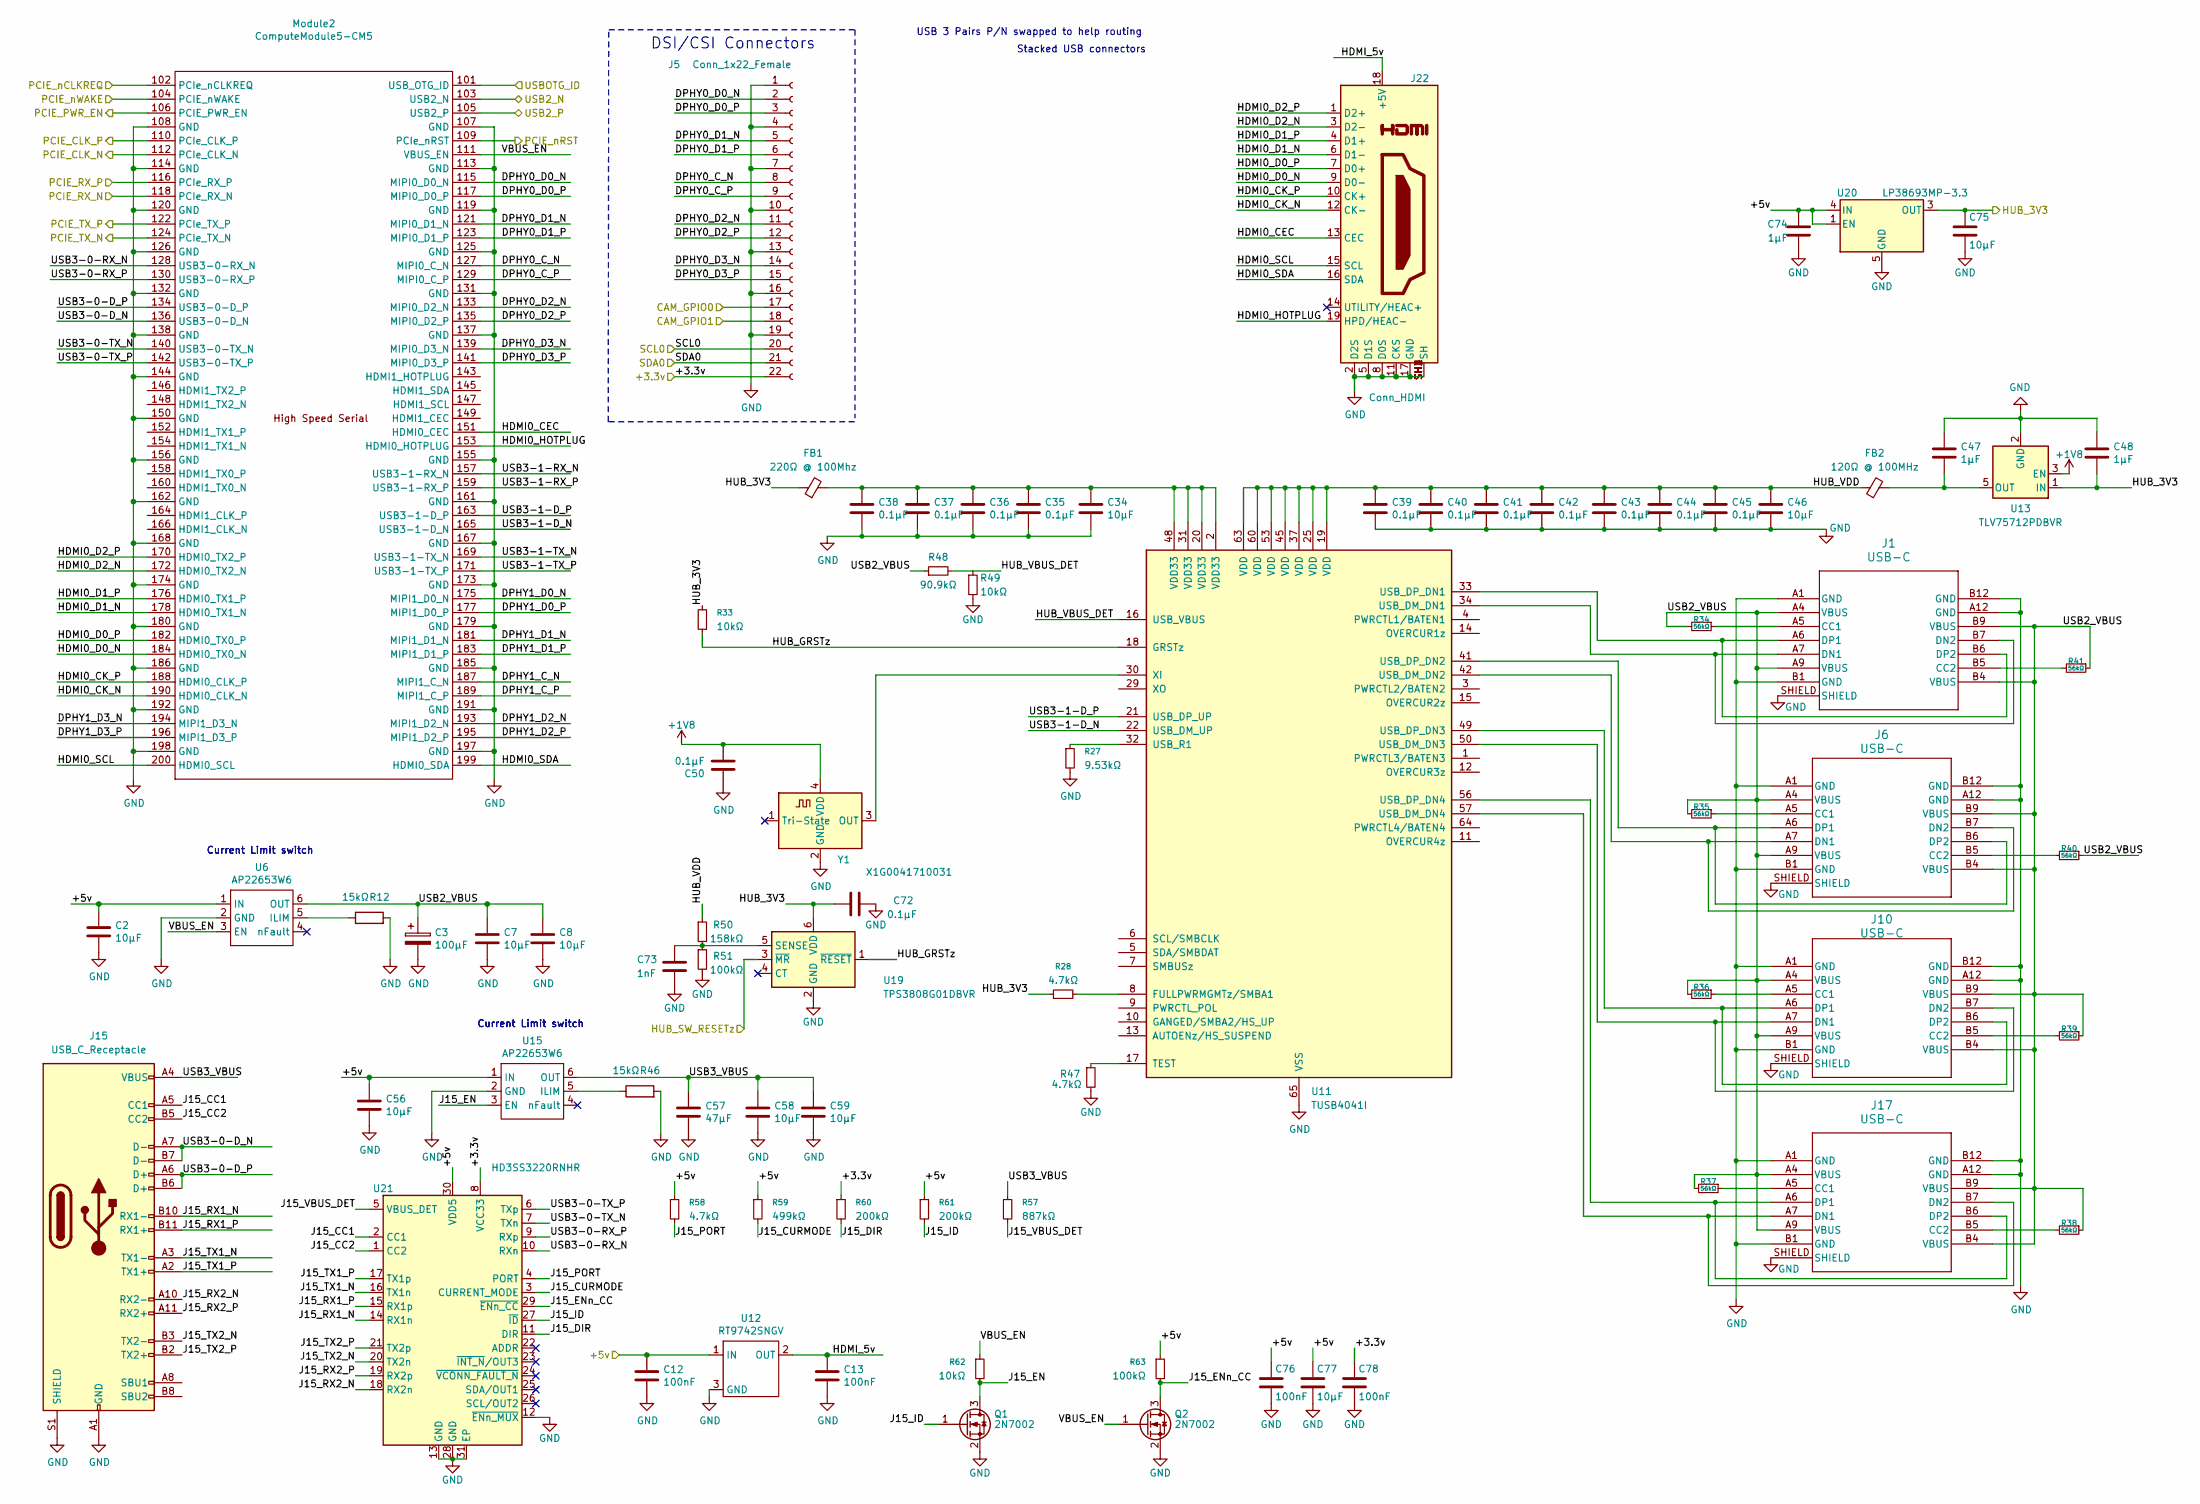
[picture p5: schematic CM5_HighSpeed.kicad_sch, Compute Module 5 IO Board - CM5 - Highspeed]

Parts:
C2, C7, C8, C56, C58, C59, C75, C77: 10µF; C_0805_2012Metric; Part Description Capacitor, Ceramic, 10µF, ±10%, 10V, X5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; LCSC C15850
C3: 100µF; CP_EIA-7343-31_Kemet-D; Part Description Capacitor, Aluminum, 100µF, ±20%, 10V, 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; LCSC C3275146
C12, C13: 100nF; C_0402_1005Metric; Part Description Capacitor, Ceramic, 0.1µF, ±10%, 6.3V, 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; LCSC C1525
C34, C46: 10µF; C_0402_1005Metric; Part Description Capacitor, Ceramic, 10µF, ±20%, 6.3V, X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; LCSC C15525
C35, C36, C37, C38, C39, C40, C41, C42, C43, C44, C45, C50: 0.1µF; C_0402_1005Metric; Part Description Capacitor, Ceramic, 0.1µF, ±10%, 6.3V, 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; LCSC C1525
C47, C48: 1µF; C_0402_1005Metric; Part Description Capacitor, Ceramic, 1µF, ±10%, 6.3V, X5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; LCSC C52923
C57: 47µF; C_1206_3216Metric; Part Description 47 µF ±20% 10V Ceramic Capacitor X5R 12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; LCSC C96123
C72: 0.1µF; C_0603_1608Metric; Part Description CAP CER 0.1UF 50V X7R 0603; LCSC C14663
C73: 1nF; C_0603_1608Metric; Part Description Capacitor, Ceramic, 1nF, ±5%, 50V, C0G,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; LCSC C77026
C74: 1µF; C_0402_1005Metric; Part Description 1 µF ±10% 50V Ceramic Capacitor X5R 040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; LCSC C1518208
C76, C78: 100nF; C_0402_1005Metric; Part Description CAP CER 0.1UF 50V X7R 0402; LCSC C307331
FB1: 220Ω @ 100Mhz; BEADC1005X55N; Part Description Filter, Ferrite Bead, 220Ω @ 100MHz, SM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; LCSC C85813
FB2: 120Ω @ 100MHz; L_0603_1608Metric; Part Description Filter, Ferrite Bead, 120Ω @ 100MHz, 3A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; LCSC C85831
J1, J6, J10, J17: USB-C; 216989-0001_MOL; Part Description Receptacle, USB-C, 2.0, 24 pin (14+10 D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; LCSC C3197955
J5: Conn_1x22_Female; Hirose_FH12-22S-0.5SH_1x22-1MP_P0.50mm_Horizontal; Part Description Connector, 22 Position FFC, FPC Connect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; LCSC C597981
J15: USB_C_Receptacle; USB_C_Receptacle_Molex_105450-0101; Part Description Connector, USB-C 3.2 Gen 2; LCSC C134092
J22: Conn_HDMI; EDAC 690-019-298-412; Part Description Connector, HDMI Type A, Female, Right A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; LCSC C5291558
Module2: ComputeModule5-CM5; CM5_Connector_B; Part Description Connector, CM Receptacle, 100 pin, 0.4m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; LCSC C6782225
Q1, Q2: 2N7002; SOT-23; Part Description MOSFET, N-channel, 60V, 115mA, SOT-23; LCSC C8545
R12, R46: 15kΩ; R_0402_1005Metric; Part Description Resistor, 15kΩ, ±1%, 0.1W, SMD 0402 (10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; LCSC C25756
R27: 9.53kΩ; R_0402_1005Metric; Part Description Resistor, 9.53kΩ, ±1%, 0.1W, SMD 0402 (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; LCSC C409938
R28, R58: 4.7kΩ; R_0402_1005Metric; Part Description Resistor, 4.7kΩ, ±1%, 0.1W, SMD 0402 (1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; LCSC C25900
R33, R62: 10kΩ; R_0402_1005Metric; Part Description Resistor, 10kΩ, ±1%, 0.1W, SMD 0402 (10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; LCSC C25744
R34, R35, R36, R37, R38, R39, R40, R41: 56kΩ; R_0402_1005Metric; Part Description Resistor, 56kΩ, ±1%, 0.1W, SMD 0402 (10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; LCSC C25796
R47: 4.7kΩ; R_0603_1608Metric; Part Description Resistor, 4.7kΩ, ±1%, 0.1W, SMD 0603 (1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; LCSC C23162
R48: 90.9kΩ; R_0603_1608Metric; Part Description Resistor, 90.9kΩ, ±1%, 0.1W, SMD 0603 (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; LCSC C403390
R49: 10kΩ; R_0603_1608Metric; Part Description Resistor, 10kΩ, ±1%, 0.1W, SMD 0603 (16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; LCSC C25804
R50: 158kΩ; R_0603_1608Metric; Part Description Resistor, 158kΩ, ±1%, 0.1W, SMD 0603 (1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; LCSC C22883
R51: 100kΩ; R_0603_1608Metric; Part Description Resistor, 100kΩ, ±1%, 0.1W, SMD 0603 (1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; LCSC C25803
R57: 887kΩ; R_0402_1005Metric; Part Description Resistor, 887kΩ, ±1%, 0.1W, SMD 0402 (1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; LCSC C409935
R59: 499kΩ; R_0402_1005Metric; Part Description Resistor, 499kΩ, ±1%, 0.1W, SMD 0402 (1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; LCSC C2986233
R60, R61: 200kΩ; R_0402_1005Metric; Part Description Resistor, 200kΩ, ±1%, 0.1W, SMD 0402 (1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; LCSC C25764
R63: 100kΩ; R_0402_1005Metric; Part Description Resistor, 100kΩ, ±1%, 0.1W, SMD 0402 (1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; LCSC C25741
U6, U15: AP22653W6; SOT-23-6; Part Description Power Switch/Driver, 1:1, P-Channel, 2.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; LCSC C2158037
U11: TUSB4041I; Texas_TQFP-64-1EP_10x10mm_P0.5mm_EP8x8mm_Mask4.44x4.44mm_Th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; Part Description Controller, USB Hub, 64-HTQFP; LCSC C192089
U12: RT9742SNGV; TSOT-23_HandSoldering; Part Description Power Switch/Driver, 1:1, N-Channel, 50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; LCSC C3235509
U13: TLV75712PDBVR; SOT-23-5; Part Description LDO, fixed 1.2 V, 1 A, SOT-23-5; LCSC C1509296
U19: TPS3808G01DBVR; SOT-23-6; Part Description Voltage supervisor, adjustable (0.405 V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; LCSC C19653
U20: LP38693MP-3.3; SOT-223-5; Part Description IC, LDO, 3.3V, 500mA, SOT-223-5, enable; LCSC C130904
U21: HD3SS3220RNHR; Texas_RNH0030A_WQFN-30-1EP_2.5x4.5mm_P0.4mm_EP1.2x3.2mm_The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; Part Description IC, USB Type-C DRP port controller + US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; LCSC C165155
Y1: X1G0041710031; Oscillator_SMD_ECS_2520MV-xxx-xx-4Pin_2.5x2.0mm; Part Description Oscillator SG-210STF, 24MHz, CMOS, 1.6V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; LCSC C70559

Connections:
+1V8: C50.2, U13.3 (EN), Y1.4 (VDD); also elsewhere on the board
+5v: C2.1, C12.1, C56.1, C74.1, C76.1, C77.1, R58.1, R59.1, R61.1, R63.1, U6.1 (IN), U12.1 (IN), U15.1 (IN), U20.1 (EN), U20.4 (IN), U21.30 (VDD5); also elsewhere on the board
/+3.3v: C78.1, J5.22, R60.1, U21.8 (VCC33); also elsewhere on the board
/CM5_GPIO ( Ethernet, GPIO, SDCARD)/CAM_GPIO0: J5.17; also elsewhere on the board
/CM5_GPIO ( Ethernet, GPIO, SDCARD)/CAM_GPIO1: J5.18; also elsewhere on the board
/CM5_GPIO ( Ethernet, GPIO, SDCARD)/HUB_SW_RESETz: U19.3 (~MR); also elsewhere on the board
/CM5_GPIO ( Ethernet, GPIO, SDCARD)/SCL0: J5.20; also elsewhere on the board
/CM5_GPIO ( Ethernet, GPIO, SDCARD)/SDA0: J5.21; also elsewhere on the board
/CM5_GPIO ( Ethernet, GPIO, SDCARD)/USBOTG: Module2.101 (USB_OTG_ID); also elsewhere on the board
/CM5_HighSpeed/DPHY0_C_N: J5.8, Module2.127 (MIPI0_C_N)
/CM5_HighSpeed/DPHY0_C_P: J5.9, Module2.129 (MIPI0_C_P)
/CM5_HighSpeed/DPHY0_D0_N: J5.2, Module2.115 (MIPI0_D0_N)
/CM5_HighSpeed/DPHY0_D0_P: J5.3, Module2.117 (MIPI0_D0_P)
/CM5_HighSpeed/DPHY0_D1_N: J5.5, Module2.121 (MIPI0_D1_N)
/CM5_HighSpeed/DPHY0_D1_P: J5.6, Module2.123 (MIPI0_D1_P)
/CM5_HighSpeed/DPHY0_D2_N: J5.11, Module2.133 (MIPI0_D2_N)
/CM5_HighSpeed/DPHY0_D2_P: J5.12, Module2.135 (MIPI0_D2_P)
/CM5_HighSpeed/DPHY0_D3_N: J5.14, Module2.139 (MIPI0_D3_N)
/CM5_HighSpeed/DPHY0_D3_P: J5.15, Module2.141 (MIPI0_D3_P)
/CM5_HighSpeed/DPHY1_C_N: Module2.187 (MIPI1_C_N)
/CM5_HighSpeed/DPHY1_C_P: Module2.189 (MIPI1_C_P)
/CM5_HighSpeed/DPHY1_D0_N: Module2.175 (MIPI1_D0_N)
/CM5_HighSpeed/DPHY1_D0_P: Module2.177 (MIPI1_D0_P)
/CM5_HighSpeed/DPHY1_D1_N: Module2.181 (MIPI1_D1_N)
/CM5_HighSpeed/DPHY1_D1_P: Module2.183 (MIPI1_D1_P)
/CM5_HighSpeed/DPHY1_D2_N: Module2.193 (MIPI1_D2_N)
/CM5_HighSpeed/DPHY1_D2_P: Module2.195 (MIPI1_D2_P)
/CM5_HighSpeed/DPHY1_D3_N: Module2.194 (MIPI1_D3_N)
/CM5_HighSpeed/DPHY1_D3_P: Module2.196 (MIPI1_D3_P)
/CM5_HighSpeed/HDMI0_CEC: J22.13 (CEC), Module2.151 (HDMI0_CEC)
/CM5_HighSpeed/HDMI0_CK_N: J22.12 (CK-), Module2.190 (HDMI0_CLK_N)
/CM5_HighSpeed/HDMI0_CK_P: J22.10 (CK+), Module2.188 (HDMI0_CLK_P)
/CM5_HighSpeed/HDMI0_D0_N: J22.9 (D0-), Module2.184 (HDMI0_TX0_N)
/CM5_HighSpeed/HDMI0_D0_P: J22.7 (D0+), Module2.182 (HDMI0_TX0_P)
/CM5_HighSpeed/HDMI0_D1_N: J22.6 (D1-), Module2.178 (HDMI0_TX1_N)
/CM5_HighSpeed/HDMI0_D1_P: J22.4 (D1+), Module2.176 (HDMI0_TX1_P)
/CM5_HighSpeed/HDMI0_D2_N: J22.3 (D2-), Module2.172 (HDMI0_TX2_N)
/CM5_HighSpeed/HDMI0_D2_P: J22.1 (D2+), Module2.170 (HDMI0_TX2_P)
/CM5_HighSpeed/HDMI0_HOTPLUG: J22.19 (HPD/HEAC-), Module2.153 (HDMI0_HOTPLUG)
/CM5_HighSpeed/HDMI0_SCL: J22.15 (SCL), Module2.200 (HDMI0_SCL)
/CM5_HighSpeed/HDMI0_SDA: J22.16 (SDA), Module2.199 (HDMI0_SDA)
/CM5_HighSpeed/HDMI_5v: C13.1, J22.18 (+5V), U12.2 (OUT)
/CM5_HighSpeed/HUB_GRSTz: R33.1, U11.18 (GRSTz), U19.1 (~RESET)
/CM5_HighSpeed/HUB_VBUS_DET: R48.2, R49.1, U11.16 (USB_VBUS)
/CM5_HighSpeed/HUB_VDD: C39.1, C40.1, C41.1, C42.1, C43.1, C44.1, C45.1, C46.1, FB2.1, R50.1, U11.19 (VDD), U11.25 (VDD), U11.37 (VDD), U11.45 (VDD), U11.53 (VDD), U11.60 (VDD), U11.63 (VDD)
/CM5_HighSpeed/J15_CC1: J15.A5 (CC1), U21.2 (CC1)
/CM5_HighSpeed/J15_CC2: J15.B5 (CC2), U21.1 (CC2)
/CM5_HighSpeed/J15_CURMODE: R59.2, U21.3 (CURRENT_MODE)
/CM5_HighSpeed/J15_DIR: R60.2, U21.11 (DIR)
/CM5_HighSpeed/J15_EN: Q1.3 (D), R62.2, U15.3 (EN)
/CM5_HighSpeed/J15_ENn_CC: Q2.3 (D), R63.2, U21.29 (~ENn_CC)
/CM5_HighSpeed/J15_ID: Q1.1 (G), R61.2, U21.27 (~ID)
/CM5_HighSpeed/J15_PORT: R58.2, U21.4 (PORT)
/CM5_HighSpeed/J15_RX1_N: J15.B10 (RX1-), U21.14 (RX1n)
/CM5_HighSpeed/J15_RX1_P: J15.B11 (RX1+), U21.15 (RX1p)
/CM5_HighSpeed/J15_RX2_N: J15.A10 (RX2-), U21.18 (RX2n)
/CM5_HighSpeed/J15_RX2_P: J15.A11 (RX2+), U21.19 (RX2p)
/CM5_HighSpeed/J15_TX1_N: J15.A3 (TX1-), U21.16 (TX1n)
/CM5_HighSpeed/J15_TX1_P: J15.A2 (TX1+), U21.17 (TX1p)
/CM5_HighSpeed/J15_TX2_N: J15.B3 (TX2-), U21.20 (TX2n)
/CM5_HighSpeed/J15_TX2_P: J15.B2 (TX2+), U21.21 (TX2p)
/CM5_HighSpeed/J15_VBUS_DET: R57.2, U21.5 (VBUS_DET)
/CM5_HighSpeed/PCIE_CLK_N: Module2.112 (PCIe_CLK_N); also elsewhere on the board
/CM5_HighSpeed/PCIE_CLK_P: Module2.110 (PCIe_CLK_P); also elsewhere on the board
/CM5_HighSpeed/PCIE_PWR_EN: Module2.106 (PCIE_PWR_EN); also elsewhere on the board
/CM5_HighSpeed/PCIE_RX_N: Module2.118 (PCIe_RX_N); also elsewhere on the board
/CM5_HighSpeed/PCIE_RX_P: Module2.116 (PCIe_RX_P); also elsewhere on the board
/CM5_HighSpeed/PCIE_TX_N: Module2.124 (PCIe_TX_N); also elsewhere on the board
/CM5_HighSpeed/PCIE_TX_P: Module2.122 (PCIe_TX_P); also elsewhere on the board
/CM5_HighSpeed/PCIE_nCLKREQ: Module2.102 (PCIe_nCLKREQ); also elsewhere on the board
/CM5_HighSpeed/PCIE_nRST: Module2.109 (PCIe_nRST); also elsewhere on the board
/CM5_HighSpeed/PCIE_nWAKE: Module2.104 (PCIE_nWAKE); also elsewhere on the board
/CM5_HighSpeed/USB2_VBUS: C3.1, C7.1, C8.1, J1.A4 (VBUS), J1.A9 (VBUS), J1.B4 (VBUS), J1.B9 (VBUS), J6.A4 (VBUS), J6.A9 (VBUS), J6.B4 (VBUS), J6.B9 (VBUS), J10.A4 (VBUS), J10.A9 (VBUS), J10.B4 (VBUS), J10.B9 (VBUS), J17.A4 (VBUS), J17.A9 (VBUS), J17.B4 (VBUS), J17.B9 (VBUS), R34.2, R35.2, R36.2, R37.2, R38.1, R39.1, R40.1, R41.1, R48.1, U6.6 (OUT)
/CM5_HighSpeed/USB3-0-D_N: J15.A7 (D-), J15.B7 (D-), Module2.136 (USB3-0-D_N)
/CM5_HighSpeed/USB3-0-D_P: J15.A6 (D+), J15.B6 (D+), Module2.134 (USB3-0-D_P)
/CM5_HighSpeed/USB3-0-RX_N: Module2.128 (USB3-0-RX_N), U21.10 (RXn)
/CM5_HighSpeed/USB3-0-RX_P: Module2.130 (USB3-0-RX_P), U21.9 (RXp)
/CM5_HighSpeed/USB3-0-TX_N: Module2.140 (USB3-0-TX_N), U21.7 (TXn)
/CM5_HighSpeed/USB3-0-TX_P: Module2.142 (USB3-0-TX_P), U21.6 (TXp)
/CM5_HighSpeed/USB3-1-D_N: Module2.165 (USB3-1-D_N), U11.22 (USB_DM_UP)
/CM5_HighSpeed/USB3-1-D_P: Module2.163 (USB3-1-D_P), U11.21 (USB_DP_UP)
/CM5_HighSpeed/USB3-1-RX_N: Module2.157 (USB3-1-RX_N)
/CM5_HighSpeed/USB3-1-RX_P: Module2.159 (USB3-1-RX_P)
/CM5_HighSpeed/USB3-1-TX_N: Module2.169 (USB3-1-TX_N)
/CM5_HighSpeed/USB3-1-TX_P: Module2.171 (USB3-1-TX_P)
/CM5_HighSpeed/USB3_VBUS: C57.1, C58.1, C59.1, J15.A4 (VBUS), J15.A9 (VBUS), J15.B4 (VBUS), J15.B9 (VBUS), R57.1, U15.6 (OUT)
/CM5_HighSpeed/VBUS_EN: Module2.111 (VBUS_EN), Q2.1 (G), R62.1, U6.3 (EN)
/HUB_3V3: C48.2, C72.1, C75.1, FB1.1, R28.1, R33.2, U13.1 (IN), U19.6 (VDD), U20.3 (OUT); also elsewhere on the board
/USB2_N: Module2.103 (USB2_N); also elsewhere on the board
/USB2_P: Module2.105 (USB2_P); also elsewhere on the board
GND: C2.2, C3.2, C7.2, C8.2, C12.2, C13.2, C34.2, C35.2, C36.2, C37.2, C38.2, C39.2, C40.2, C41.2, C42.2, C43.2, C44.2, C45.2, C46.2, C47.1, C48.1, C50.1, C56.2, C57.2, C58.2, C59.2, C72.2, C73.2, C74.2, C75.2, C76.2, C77.2, C78.2, J1.A1 (GND), J1.A12 (GND), J1.B1 (GND), J1.B12 (GND), J1.SHIELD, J5.1, J5.4, J5.7, J5.10, J5.13, J5.16, J5.19, J6.A1 (GND), J6.A12 (GND), J6.B1 (GND), J6.B12 (GND), J6.SHIELD, J10.A1 (GND), J10.A12 (GND), J10.B1 (GND), J10.B12 (GND), J10.SHIELD, J15.A1 (GND), J15.A12 (GND), J15.B1 (GND), J15.B12 (GND), J15.S1 (SHIELD), J17.A1 (GND), J17.A12 (GND), J17.B1 (GND), J17.B12 (GND), J17.SHIELD, J22.2 (D2S), J22.5 (D1S), J22.8 (D0S), J22.11 (CKS), J22.17 (GND), J22.SH1 (SH), J22.SH2 (SH), J22.SH3 (SH), J22.SH4 (SH), Module2.107 (GND), Module2.108 (GND), Module2.113 (GND), Module2.114 (GND), Module2.119 (GND), Module2.120 (GND), Module2.125 (GND), Module2.126 (GND), Module2.131 (GND), Module2.132 (GND), Module2.137 (GND), Module2.138 (GND), Module2.144 (GND), Module2.150 (GND), Module2.155 (GND), Module2.156 (GND), Module2.161 (GND), Module2.162 (GND), Module2.167 (GND), Module2.168 (GND), Module2.173 (GND), Module2.174 (GND), Module2.179 (GND), Module2.180 (GND), Module2.185 (GND), Module2.186 (GND), Module2.191 (GND), Module2.192 (GND), Module2.197 (GND), Module2.198 (GND), Q1.2 (S), Q2.2 (S), R12.2, R27.2, R46.2, R47.2, R49.2, R51.2, U6.2 (GND), U11.65 (VSS), U12.3 (GND), U13.2 (GND), U15.2 (GND), U19.2 (GND), U20.5 (GND), U21.12 (~ENn_MUX), U21.13 (GND), U21.28 (GND), U21.31 (EP), Y1.2 (GND); also elsewhere on the board
unnamed: C34.1, C35.1, C36.1, C37.1, C38.1, FB1.2, U11.2 (VDD33), U11.20 (VDD33), U11.31 (VDD33), U11.48 (VDD33)
unnamed: J1.A5 (CC1), R34.1
unnamed: J1.B5 (CC2), R41.2
unnamed: J1.A7 (DN1), J1.B7 (DN2), U11.34 (USB_DM_DN1)
unnamed: J1.A6 (DP1), J1.B6 (DP2), U11.33 (USB_DP_DN1)
unnamed: J6.A5 (CC1), R35.1
unnamed: J6.B5 (CC2), R40.2
unnamed: J6.A7 (DN1), J6.B7 (DN2), U11.42 (USB_DM_DN2)
unnamed: J6.A6 (DP1), J6.B6 (DP2), U11.41 (USB_DP_DN2)
unnamed: J10.A5 (CC1), R36.1
unnamed: J10.B5 (CC2), R39.2
unnamed: J10.A7 (DN1), J10.B7 (DN2), U11.50 (USB_DM_DN3)
unnamed: J10.A6 (DP1), J10.B6 (DP2), U11.49 (USB_DP_DN3)
unnamed: J17.A5 (CC1), R37.1
unnamed: J17.B5 (CC2), R38.2
unnamed: J17.A7 (DN1), J17.B7 (DN2), U11.57 (USB_DM_DN4)
unnamed: J17.A6 (DP1), J17.B6 (DP2), U11.56 (USB_DP_DN4)
unnamed: R12.1, U6.5 (ILIM)
unnamed: R28.2, U11.8 (FULLPWRMGMTz/SMBA1)
unnamed: R47.1, U11.17 (TEST)
unnamed: R27.1, U11.32 (USB_R1)
unnamed: U11.30 (XI), Y1.3 (OUT)
unnamed: C47.2, FB2.2, U13.5 (OUT)
unnamed: R46.1, U15.5 (ILIM)
unnamed: C73.1, R50.2, R51.1, U19.5 (SENSE)

Notes on the sheet:
USB 3 Pairs P/N swapped to help routing
Current Limit switch
DSI/CSI Connectors
Stacked USB connectors

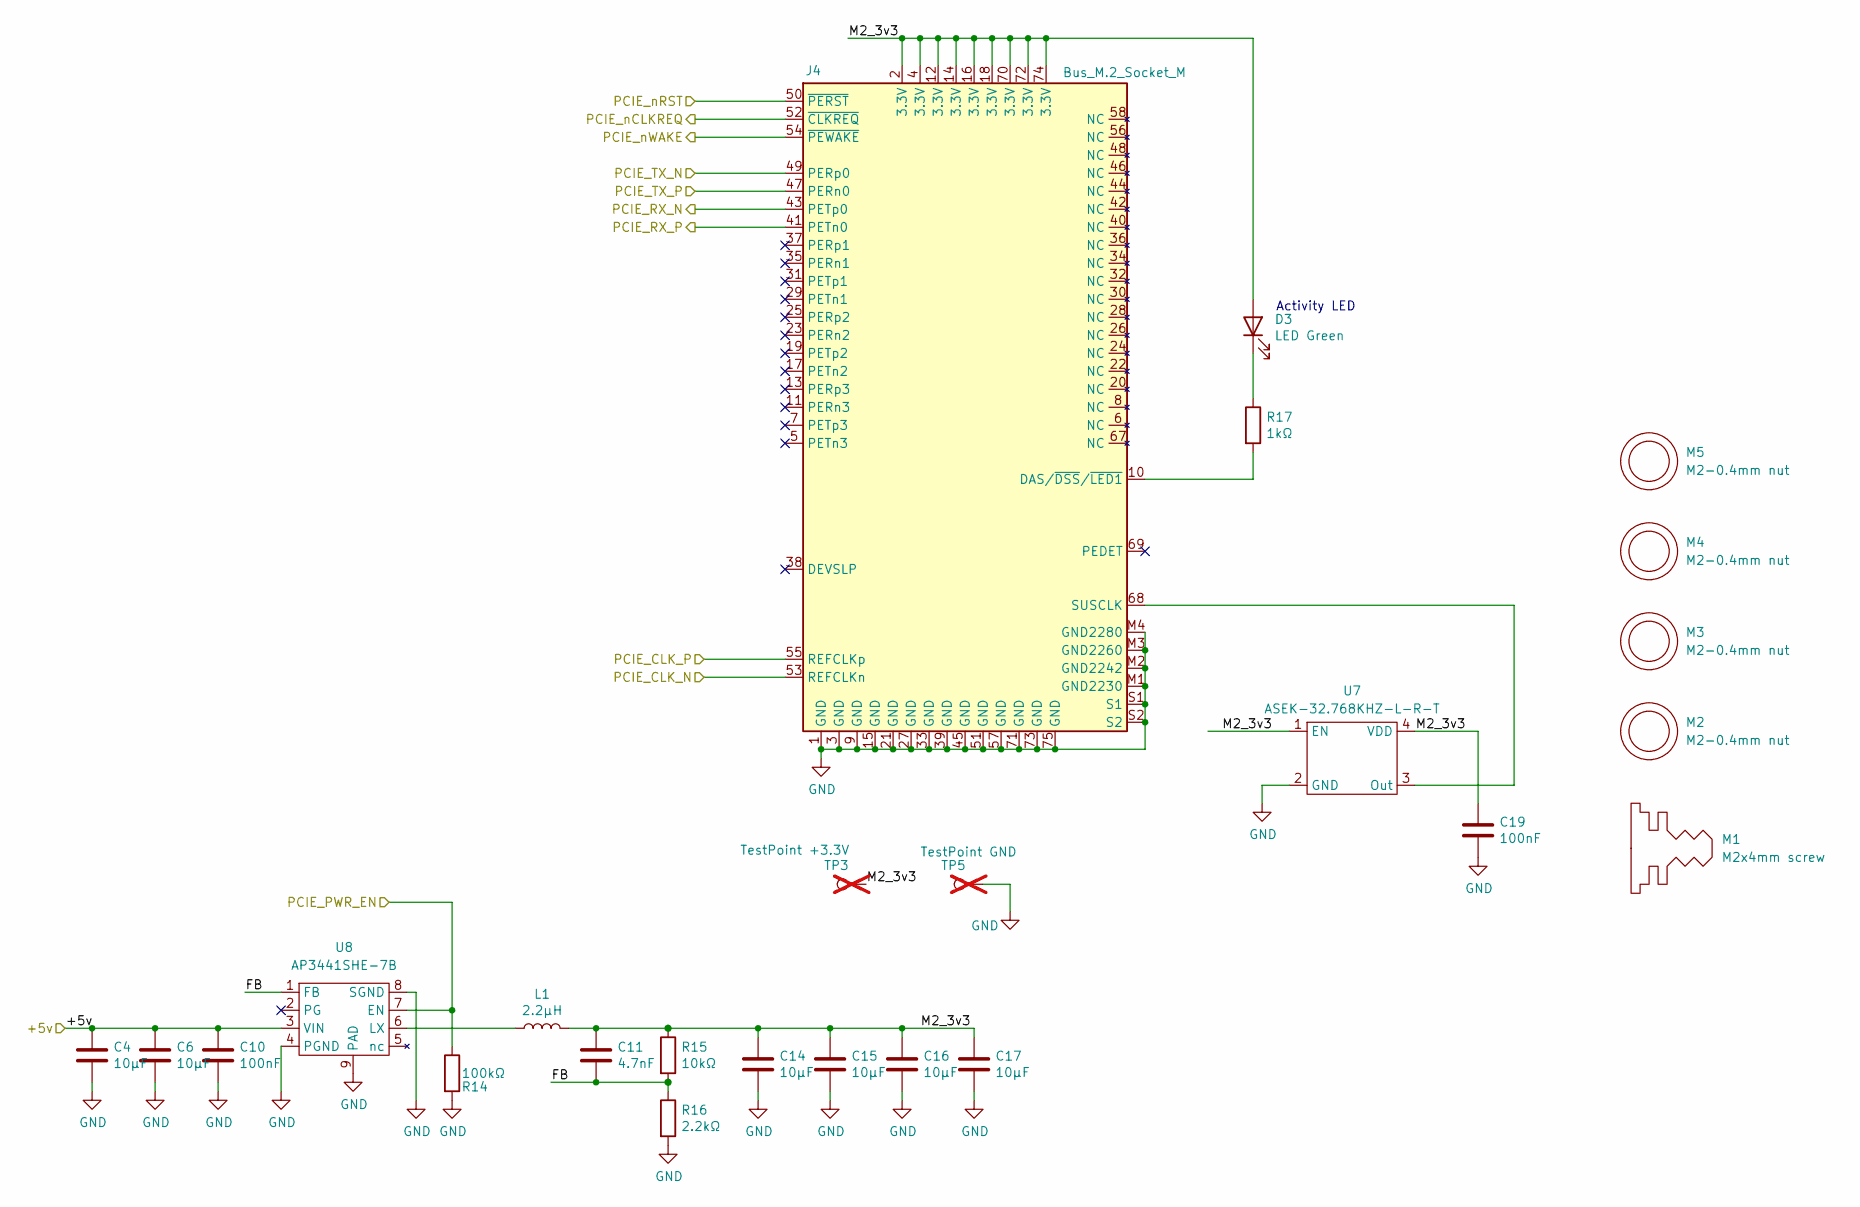
[picture p6: schematic PCIe-M2.kicad_sch, Compute Module 5 IO Board - M2 Socket]

Parts:
C4, C6, C14, C15, C16, C17: 10µF; C_0805_2012Metric; Part Description Capacitor, Ceramic, 10µF, ±10%, 10V, X5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; LCSC C15850
C10, C19: 100nF; C_0402_1005Metric; Part Description Capacitor, Ceramic, 0.1µF, ±10%, 6.3V, 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; LCSC C1525
C11: 4.7nF; C_0402_1005Metric; Part Description Capacitor, Ceramic, 4700pF, ±10%, 10V, 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; LCSC C1538
D3: LED Green; LED_0603_1608Metric; Part Description LED, Green, 572nm, 2.2V, SMD 0603; LCSC C125113
J4: Bus_M.2_Socket_M; M.2 M Key socket; Part Description Connector, M.2, M-Key, 67 pin, 0.5mm P,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; LCSC C574849
L1: 2.2µH; L_Bourns_SRP5030CC; Part Description Inductor, 2.2µH, ±20%, 7A, 32Ω; LCSC C22404330
M1: M2x4mm screw; Part Description PHCS, M2-0.4 x 4mm, Phillips, Stainless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
M2, M3, M4, M5: M2-0.4mm nut; Part Description Standoff, M2 thread, 1.5mm H, 5.56mm Di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; LCSC C2916320
R14: 100kΩ; R_0402_1005Metric; Part Description Resistor, 100kΩ, ±1%, 0.1W, SMD 0402 (1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; LCSC C25741
R15: 10kΩ; R_0402_1005Metric; Part Description Resistor, 10kΩ, ±1%, 0.1W, SMD 0402 (10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; LCSC C25744
R16: 2.2kΩ; R_0402_1005Metric; Part Description Resistor, 2.2kΩ, ±1%, 0.1W, SMD 0402 (1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; LCSC C25879
R17: 1kΩ; R_0402_1005Metric; Part Description Resistor, 1kΩ, ±1%, 0.1W, SMD 0402 (100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; LCSC C11702
TP3: TestPoint +3.3V; TestPoint_Pad_D1.5mm; Part Description Test point; not fitted
TP5: TestPoint GND; TestPoint_Pad_D1.5mm; Part Description Test point; not fitted
U7: ASEK-32.768KHZ-L-R-T; Crystal_SMD_3225-4Pin_3.2x2.5mm; Part Description Oscillator, 32.768kHz, 3.3V; LCSC C2650753
U8: AP3441SHE-7B; DFN-8-1EP_2x2mm_P0.5mm_EP1.05x1.75mm; Part Description Buck Converter, 0.6V, 3A; LCSC C2070918

Connections:
+5v: C4.1, C6.1, C10.1, U8.3 (VIN); also elsewhere on the board
/CM5_HighSpeed/PCIE_CLK_N: J4.53 (REFCLKn); also elsewhere on the board
/CM5_HighSpeed/PCIE_CLK_P: J4.55 (REFCLKp); also elsewhere on the board
/CM5_HighSpeed/PCIE_PWR_EN: R14.1, U8.7 (EN); also elsewhere on the board
/CM5_HighSpeed/PCIE_RX_N: J4.43 (PETp0); also elsewhere on the board
/CM5_HighSpeed/PCIE_RX_P: J4.41 (PETn0); also elsewhere on the board
/CM5_HighSpeed/PCIE_TX_N: J4.49 (PERp0); also elsewhere on the board
/CM5_HighSpeed/PCIE_TX_P: J4.47 (PERn0); also elsewhere on the board
/CM5_HighSpeed/PCIE_nCLKREQ: J4.52 (~CLKREQ); also elsewhere on the board
/CM5_HighSpeed/PCIE_nRST: J4.50 (~PERST); also elsewhere on the board
/CM5_HighSpeed/PCIE_nWAKE: J4.54 (~PEWAKE); also elsewhere on the board
/PCIe-M2/FB: C11.2, R15.2, R16.1, U8.1 (FB)
/PCIe-M2/M2_3v3: C11.1, C14.1, C15.1, C16.1, C17.1, C19.1, D3.2 (A), J4.2 (3.3V), J4.4 (3.3V), J4.12 (3.3V), J4.14 (3.3V), J4.16 (3.3V), J4.18 (3.3V), J4.70 (3.3V), J4.72 (3.3V), J4.74 (3.3V), L1.2, R15.1, TP3.1 (1_1), U7.1 (EN), U7.4 (VDD)
GND: C4.2, C6.2, C10.2, C14.2, C15.2, C16.2, C17.2, C19.2, J4.1 (GND), J4.3 (GND), J4.9 (GND), J4.15 (GND), J4.21 (GND), J4.27 (GND), J4.33 (GND), J4.39 (GND), J4.45 (GND), J4.51 (GND), J4.57 (GND), J4.71 (GND), J4.73 (GND), J4.75 (GND), J4.M1 (GND2230), J4.M2 (GND2242), J4.M3 (GND2260), J4.M4 (GND2280), J4.S1, J4.S2, R14.2, R16.2, TP5.1 (1_1), U7.2 (GND), U8.4 (PGND), U8.8 (SGND), U8.9 (PAD); also elsewhere on the board
unnamed: D3.1 (K), R17.1
unnamed: J4.10 (DAS/~DSS/~LED1), R17.2
unnamed: J4.68 (SUSCLK), U7.3 (Out)
unnamed: L1.1, U8.6 (LX)

Notes on the sheet:
Activity LED

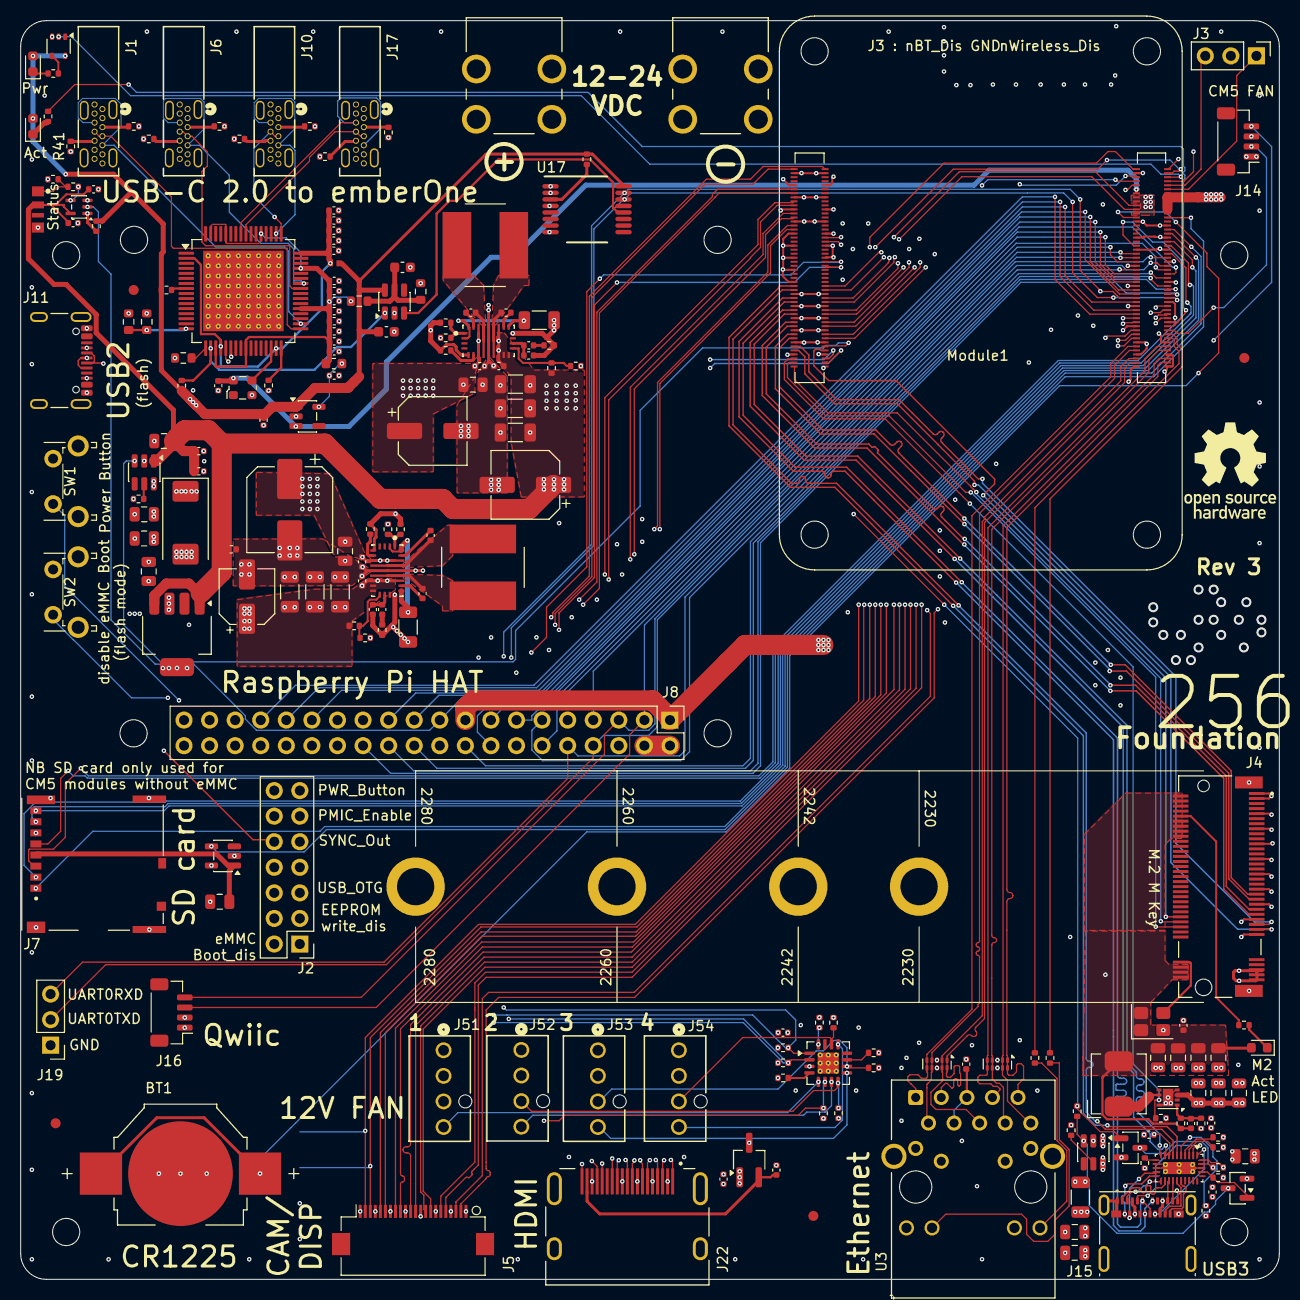
[picture p7: board libreboard.kicad_pcb from above]

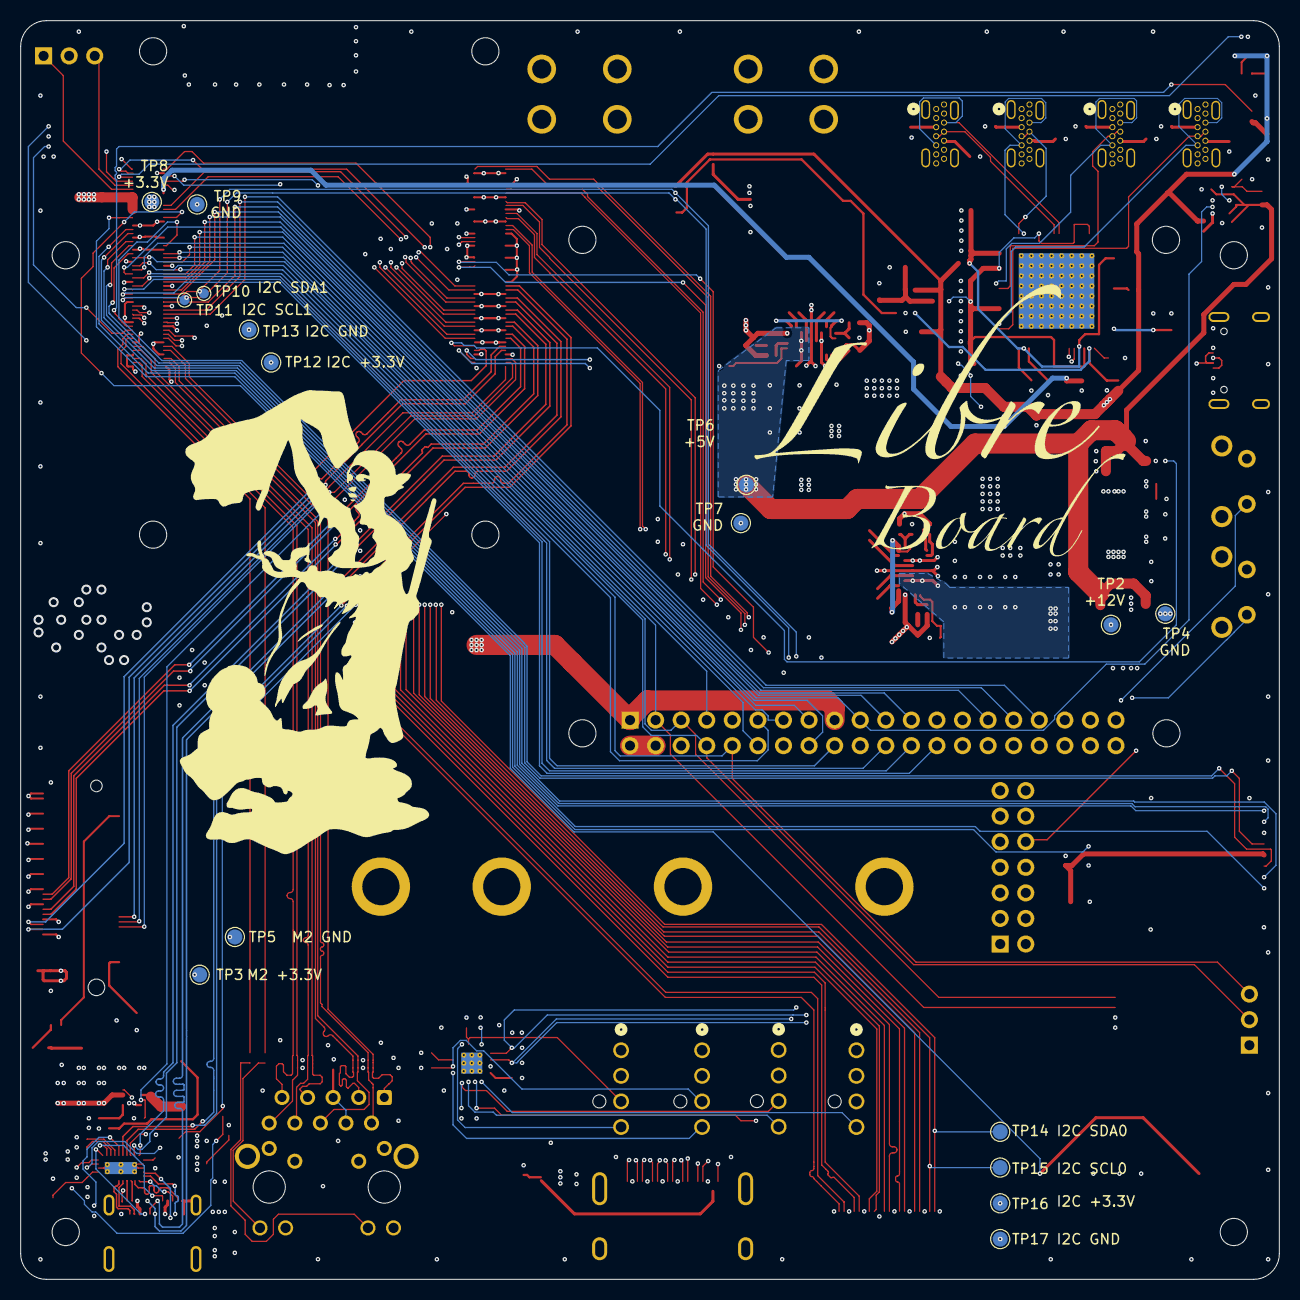
[picture p8: board libreboard.kicad_pcb from below]

Board: 6 copper layers, 125.0 x 125.0 mm, 220 parts (16 on the bottom side), 211 nets.
