256foundation/libreboard/(commit log)

2025-08-20 starting to trace
    [CM5_GPIO.kicad_sch, CM5_HighSpeed.kicad_sch, libreboard.kicad_sch]
2025-08-25 fully traced
    [CM5_HighSpeed.kicad_sch]
2025-09-12 voltage regulator refactoring
    [CM5_GPIO.kicad_sch, CM5_HighSpeed.kicad_sch, PCIe-M2.kicad_sch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]
2025-09-15 place all components
    [CM5_GPIO.kicad_sch, CM5_HighSpeed.kicad_sch, PCIe-M2.kicad_sch, libreboard.kicad_sch]
2025-09-17 updates BOM, sychronizes PCB from schematic, & includes error report.
    [CM5_HighSpeed.kicad_sch, libreboard.kicad_sch]
2025-09-18 change C27-C29 to 1206, reroute i2c
    [CM5_GPIO.kicad_sch, libreboard.kicad_sch]
2025-09-19 C27-C29 update
    [libreboard.kicad_sch]
2025-09-23 cleanup, testpoints
    [CM5_GPIO.kicad_sch, CM5_HighSpeed.kicad_sch, libreboard.kicad_sch]
2025-09-24 fix all DRC issues
    [PCIe-M2.kicad_sch, libreboard.kicad_sch]
2025-09-25 final review, added coincell back, additional testpoints, updated i2c bus for quic
    [CM5_GPIO.kicad_sch, CM5_HighSpeed.kicad_sch, PCIe-M2.kicad_sch, libreboard.kicad_sch]
2025-09-29 updating traces: min 1.3mm width, diff pairs lengths
2025-10-03 Update README and replace images: removed outdated edge views and top face view, added new front and back images of the Libre Board.
2025-10-03 Update thickness of traces, smaller fixes
    [CM5_GPIO.kicad_sch, CM5_HighSpeed.kicad_sch]
2025-11-14 switch places of C52/C54 and C21/C22 - in order for easier compatbility with Rev2
2025-11-14 switch C21 and C52 to 50V, 0805 size and reposition; Rev2 text
    [CM5_GPIO.kicad_sch, libreboard.kicad_sch]
2026-10-01 Re-save project in KiCad 10 format
    Schematics and PCB were opened and saved with KiCad 10.0, which upgrades
    the file format (PCB 20241229 -> 20260206, schematic 20250114 -> 20260306)
    and adds KiCad 10 settings keys to the .kicad_pro.
    No design changes: connectivity (netlist), tracks, vias, zones and all
    194 footprint placements are identical to the previous commit.
2026-10-01 Move backup project file out of the project root
    A second .kicad_pro next to libreboard.kicad_pro makes project ownership
    of the schematic sheets ambiguous, which blocks tools such as Konnect from
    editing them. The backup is kept, now in libreboard-backups/.
2026-10-01 USB hub: pull TEST (U11 pin 17) to GND through 4.7k
    Pin 17 was left floating. It has an internal pull-down, but TI's
    application circuit (TUSB4041I datasheet, Figure 7-8) pulls it down
    externally with 4.7k, so follow the reference design.
    New R47: 4.7k 1% 0603, Panasonic ERJ-3EKF4701V.
    Refs #26 (verify on hardware before closing).
2026-10-01 USB hub: divide VBUS down before U11 USB_VBUS (pin 16)
    U11 pin 16 was tied straight to the 5 V USB2_VBUS rail. Its absolute
    maximum is 1.4 V and the recommended maximum 1.155 V (TUSB4041I
    datasheet 5.1/5.3); the pin function table requires a 90.9k/10k 1%
    divider. Continuous overstress of this pin is the most likely reason
    the Rev1 hub worked for a while and then never enumerated again.
    New R48 90.9k (ERJ-3EKF9092V) from USB2_VBUS and R49 10k (ERJ-3EKF1002V)
    to GND, 0603; the midpoint feeds pin 16 through the HUB_VBUS_DET label.
    5.0 V gives 0.495 V, 5.5 V gives 0.545 V at the pin.
    Refs #23 (verify on hardware before closing).
2026-10-01 USB hub: run the 24 MHz oscillator Y1 from the CM5 1.8 V output
    Y1 (ECS-2520MV, 1.6-3.6 V supply) was powered from +3.3 V and drove
    U11 XI (pin 30) with a 3.3 V clock. XI is rated 2.45 V absolute maximum
    and TI requires a 1.8 V clock source (TUSB4041I datasheet 5.1, 6.3.6).
    - Y1 VDD and its decoupling cap C50 move from +3.3v to a new +1V8 net.
    - +1V8 comes from the CM5's +1.8 V output pins 88/90 (600 mA total),
    which were unused (no-connect flags removed).
    - Y1 tri-state pin 1 gets a no-connect flag: open = output enabled per
    the ECS-2520MV datasheet.
    Note: Y1's Value field says ECS-2520MV-240-CN-TR while its MPN/Digikey
    fields say -DN-TR (C = +/-25 ppm, D = +/-20 ppm); both meet the h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
2026-10-01 USB hub: 1 A / 1.2 V core LDO enabled from 1.8 V, low-DCR core bead
    - U13 TLV73311PDBV (300 mA, current limit 360 mA min) -> TLV75712PDBVR
    (1 A, 1.2 V, same SOT-23-5 pinout). The hub's VDD draws up to
    332-370 mA while held in reset (TUSB4041I rev F, 5.7), above what the
    old LDO could supply. TI allows a 1.2 V core supply (5.3 note 1:
    VDD 0.99-1.26 V). The symbol keeps its TLV73311PDBV library link
    (identical pins); use KiCad "Change Symbol" if the link should
    follow.
    - U13 EN moves from +3.3v to +1V8 so the core rail, and therefore the
    hub's reset release, only starts after the oscillator Y1 is powered:
    3.3 V -> 1.8 V (Y1 runs) -> 1.2 V core -> reset release.
    - FB2 LI0402C221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
2026-10-01 USB hub: hold GRSTz with a TPS3808 supervisor on the core rail
    GRSTz (U11 pin 18) only had a 10k/100nF RC from +3.3 V (~1 ms to VIH).
    TI requires the reset held >= 3 ms after both VDD33 and VDD are stable,
    and an active reset whenever VDD33 is up before VDD (TUSB4041I 5.6,
    6.3.7) - which is always the case here, since the core LDO runs from
    3.3 V.
    - New U19 TPS3808G01DBVR (SOT-23-6), powered from +3.3v (C72 0.1 uF),
    senses the hub core rail (new label HUB_VDD, hub side of FB2) through
    R50 158k / R51 100k: trip = 0.405 V x 2.58 = 1.045 V (1.01-1.08 V
    worst case) on the 1.2 V rail; hub VDD minimum is 0.99 V. C73 1 nF on
    SENSE per the TPS3808 datasheet.
    - CT left open: 20 ms typical (1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
2026-10-01 USB hub ports: CC pins get 56k Rp pull-ups to VBUS instead of 5.1k Rd
    R34-R41 pulled CC1/CC2 of the four hub USB-C ports (J1, J6, J10, J17)
    to GND through 5.1k. That is Rd, the signature of a USB-C *sink*, on
    ports that are meant to be hosts/sources. USB-A-to-C cables hide this,
    but a proper C-to-C device may not attach, and a charger or another host
    plugged in sees a sink and can push its own 5 V into USB2_VBUS.
    Now 56k from each CC pin to USB2_VBUS: Rp for "Default USB Power"
    (USB Type-C spec R2.0, Table 4-24, Rp pulled to 4.75-5.5 V). Default
    power is the honest advertisement, since one 1.735 A switch (U6)
    feeds all four ports.
    0603, Panasonic ERJ-3EKF5602V (Digikey number not confirmed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
2026-10-01 KiCad 10.0.6 re-save of the board and project
    Housekeeping written by KiCad 10.0.6 on open/save, no design change:
    - 78 footprint 3D models repointed from ${KICAD8_3DMODEL_DIR}/*.wrl to
    ${KICAD10_3DMODEL_DIR}/*.step (all resolve in the KiCad 10 install).
    - Tracks and vias re-sorted in the file. All tracks, vias, zones,
    footprints, graphics and setup are identical, with the same 10,381
    item UUIDs.
    - .kicad_pro gains KiCad 10 default zone settings (no rule changes).
2026-10-01 Schematic: add missing libreboard: library prefix to six footprint links
    J1, J6, J10, J17 (216989-0001_MOL) and U4, U14 (RYQ0021A-MFG) had
    footprint fields without a library nickname, so KiCad could not resolve
    them (ERC footprint_link_issues) and "Update PCB from Schematic" saw a
    footprint change against the board, which already uses the
    libreboard:-prefixed footprints. No connectivity change.
2026-10-01 USB hub ports: keep the 56k CC pull-ups in 0402
    R34-R41 sit between the stacked USB-C connectors J1/J6/J10/J17. As 0603
    they overlap each other (R34/R40, R35/R39), the connector courtyards and,
    for R38, a J17 D+ track and a GND via. Keep the original 0402 footprints
    and positions; value stays 56k. Panasonic ERJ-2RKF5602X (Digikey number
    not confirmed live).
    Their former GND vias were re-netted to USB2_VBUS by the PCB update and
    sit inside the USB2_VBUS pour on In2 (PWR), so they pick up VBUS after a
    zone refill; R41's via is just outside the pour and needs a connection.
    Refs #22.
2026-10-01 PCB (WIP): sync USB hub changes from schematic, place new parts
    Checkpoint, routing still pending:
    - Update PCB from Schematic (KiCad GUI): adds U19, R47-R51, C72, C73;
    removes C49; FB2 -> 0603 bead footprint; pad nets for HUB_VBUS_DET,
    HUB_GRSTz, HUB_VDD, +1V8, TEST and the CC pull-ups.
    - New parts placed clear of courtyards, pads, top copper and vias:
    supervisor block (U19, C72, C73, R50, R51) right of U11 next to the
    core rail; R47 and the VBUS divider R48/R49 left of U11.
    - Removed the +3.3v copper that now shorted into +1V8 pads: the feed into
    C50/Y1 and the EN-IN loop at U13 (incl. the EN-C48 link). The C50-Y1
    decoupling link is re-routed as +1V8. Zones refilled.
    Still ope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
2026-10-05 PCB: route the USB hub fixes; schematic drawing tidy-up
    Routing of the new hub parts (U19 supervisor block, R47 TEST pull-down,
    R48/R49 VBUS divider), +1V8 from CM5 pins 88/90 to U13 EN and Y1/C50,
    C48 back to U13 IN, R41's VBUS via, zones refilled, silkscreen cleaned
    up. R34-R41 back on 0402 footprints.
    DRC with schematic parity: 0 unconnected items, 0 shorts, 0 clearance
    and courtyard violations. Remaining items match the pre-v3 baseline
    (111 library-footprint version mismatches, 4 J11 pin-naming notes) plus
    one text-thickness warning.
    The schematic change is drawing only; the netlist is unchanged.
2026-10-05 USB hub: per-port VBUS power switching on the four hub ports
    The hub can now switch each downstream port's VBUS on its own, so the
    host (Mujina, uhubctl, Linux sysfs) can power-cycle a single hashboard
    with standard USB hub requests (Set/ClearPortFeature PORT_POWER). No
    CM5 GPIOs are involved.
    - U6 (one AP22653 for all four ports, 1.735 A shared) and its R12, C3,
    C7, C8 are replaced by four AP22653W6 switches U20-U23, one per port.
    Each: IN from +5v (C74-C77 0.1 uF), EN from the hub's PWRCTLn pin
    (HUB_PWRENn), nFAULT into OVERCURnz (HUB_OCnz, R56-R59 10k pull-ups to
    +3.3v), OUT to the port's own VBUS net HUB_VBUSn (C78-C81 22 uF).
    - Current limit R52-R55 43.2k: 570 mA typical, 505 m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
2026-10-11 Revert "USB hub: per-port VBUS power switching on the four hub ports"
    This reverts commit e31a2f7. Per-port switching (four AP22653 switches,
    split VBUS bus, new straps) is more board change than v3 needs. The
    four hub ports go back to the single shared switch U6 enabled by CM5
    VBUS_EN, as routed in 657f076. A software-controlled hub reset is added
    separately instead.
    The PCB was never updated for e31a2f7, so the board at 657f076 matches
    this schematic again.
    Refs #21.
2026-10-11 USB hub: software-controlled hub reset from TCA9538 P7
    The CM5 can now hard-reset the TUSB4041 hub over I2C, without
    power-cycling anything else.
    - U17 (TCA9538) P7 drives new net HUB_SW_RESETz into the manual-reset
    input (MR, pin 3) of the hub supervisor U19 (TPS3808G01). MR has an
    internal ~90k pull-up and the TCA9538 has no I/O pull-ups, so at
    power-up (P7 = input) the supervisor alone controls GRSTz as before.
    - To reset: write 0 to P7 in the output register (0x01), then clear bit
    7 of the configuration register (0x03) so P7 drives low; after ~1 ms
    set the bit again. U19 holds GRSTz low while MR is low and for its
    20 ms timeout after release, so the hub always gets a valid (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
2026-10-11 PCB: route the software hub reset and TCA9538 address straps
    Update from schematic for 3e2c6ba and Michael's routing:
    - U17 pin 12 (P7) to U19 pin 3 (MR) on HUB_SW_RESETz.
    - U17 pins 1 and 2 (A0, A1) to GND through two new vias.
    - Some existing tracks moved to make room; zones refilled.
    DRC with schematic parity matches 657f076 exactly: 0 unconnected,
    no new errors (remaining: library footprint mismatches, R41 silk text
    thickness, the existing J11 parity warnings).
    Refs #25.
2026-10-11 Status LED: hold the U16 buffer off by default (R52 pull-up on OE#)
    U16 (SN74AHCT1G125) gates the shared SPI0 MOSI line (GPIO10, also
    header pin 19) to the SK6812 status LED U9. Its active-low OE# comes
    from TCA9538 P0, which is an input at power-up and after any expander
    reset, and the TCA9538 has no internal pull-ups. OE# therefore floated:
    the buffer could be on from boot and pass a HAT's SPI traffic to the
    LED as random colour data.
    New R52 10k (0603, ERJ-3EKF1002V) from OE# to +3.3v keeps the buffer
    off (LED input held low by R42) until software drives P0 low for an
    LED update, so P0 now acts as a proper chip-select for the LED and no
    40-pin header pin is used.
    Netlist: only R52 added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
2026-10-11 Status LED: R52 OE# pull-up in 0402
    The 0603 footprint was hard to fit next to U16. R52 now uses the same
    0402 10k (Panasonic ERJ-U02F1002X) as R4, R29, R30 and the other 10k
    pull-ups, so it adds no BOM line. No connectivity change.
2026-10-11 PCB: place and route R52 (U16 OE# pull-up, 0402)
    Update from schematic for ff49f84/1d3743d and Michael's placement and
    routing: R52 sits next to U16, pad 1 on +3.3v, pad 2 on the OE# net
    (U16.1 / U17.4).
    DRC with schematic parity matches 58a2f26: 0 unconnected, no new
    errors.
2026-10-11 Power: U4/U14 start on their own (TPS552892, resistor-set outputs)
    The TPS55289 powers up with its output disabled (OE bit = 0) and needs
    an I2C write to turn on. U14 makes the CM5's +5v, so the CM5 could
    never send that write itself; Rev1 boards are jump-started by a Pico
    on the 40-pin header. U4 (+12V for the fans) also waited for software.
    Both become the TPS552892RYQR: the non-I2C variant in the same 21-pin
    RYQ package with the same power, FSW, COMP, EN/UVLO and CDC pins. It
    soft-starts (2.5-5 ms) as soon as EN/UVLO is above threshold.
    - New symbol TPS55289:TPS552892RYQR (copy of PTPS55289RYQR with pins
    3/4/14 renamed PG/CC/FB).
    - Pins 3/4 (PG/CC, open-drain on the new part) are take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
2026-10-11 PCB: self-starting U4/U14 (TPS552892) layout
    Update from schematic for a2bb35c plus Michael's routing:
    - R53/R54 (U14, 5.19 V) and R55/R56 (U4, 12.1 V) feedback dividers
    placed next to the FB pins; FB traces 7.1 / 5.7 mm on F.Cu, no vias.
    - U14 MODE (pin 2) re-routed from GND to EXTVCC/VCC (pin 21/18).
    - Old I2C copper on U4/U14 pins 3/4 (now PG/CC, no-connect) removed:
    the ID_SD vias in pins 4, ID_SC stubs and vias at pins 3, and the
    dead-end ID_SC branch on SIG. The ID_SC/ID_SD bus still connects
    J8, the CM5, R29/R30, TP10/TP11, U10 and U17.
    - R54 ground via moved off USB2_P / USB3-1-D_P on SIG; zones refilled.
    DRC with schematic parity matches bbce620: 0 unconnected, no new
    error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
2026-10-11 PCB: straighten the ID_SC/ID_SD bus now that U4/U14 are off it
    Michael's tidy-up after 479928f: with the regulators no longer on
    I2C, the bottom-layer ID_SC/ID_SD run no longer detours past U14 and
    U4; VBUS_EN is shifted to make room. Same vias (783).
    DRC with schematic parity unchanged: 0 unconnected, no new
    violations.
2026-10-11 Power: C66-C68 are real 47 uF caps on U14's +5v output
    C66-C68 (U14 output, CM5 +5v) were drawn as 47 uF in 0603 in
    7a278c5. The BOM pass in e28bff3 gave them Wurth 885012005011, a
    47 pF C0G 0402 part, and shrank the footprint to 0402; the value field
    kept saying 47 uF. The same pass also put U4's 33 uF outputs (C27-C29)
    in 0402 (fixed to TDK 1206 in 9f53362) and 6.3 V parts on the 12-24 V
    input (C21/C52, fixed in Rev2) and on +12V (C30, fixed in a2bb35c);
    C66-C68 were missed, so Rev1 has about 47 pF of ceramic output
    capacitance where ~140 uF was intended, leaving the 270 uF polymer
    C69 alone.
    Now TDK C3216X5R1A476M160AB, 47 uF 10 V X5R 1206, mirroring U4's
    C27-C29. Digikey number left bla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
2026-10-11 PCB: C66-C68 as 1206 47 uF next to U14, C69 moved down
    Update from schematic for beb3b79 plus Michael's placement:
    - C66-C68 (TDK 47 uF 10 V 1206) placed between U14's VOUT and the
    polymer cap C69, stacked at x = 166.6 mm with their own +5v/GND vias.
    - C69 and its via arrays moved ~4.6 mm down to make room.
    - The 2 mm +3.3v run on SIG (In3) moved 0.55 mm down between
    x = 162.3 and 178.5 mm, clear of C69's bottom via row (the first
    placement shorted it to +5v and GND).
    DRC with schematic parity, with and without zone refill, matches
    de81368: 0 unconnected, no new violations.
2026-10-11 USB hub: own 3.3 V rail (U20 LP38693MP-3.3 from +5v)
    The CM5's 3.3 V output is limited to 600 mA (300 mA per pin, CM5
    datasheet). The TUSB4041I took ~160 mA of it all the time (TI typical
    with 4 HS devices: 76 mA VDD33 + 86 mA core through the U13 LDO,
    ~215 mA with margin), leaving little for the microSD (CM5 Lite),
    a camera on J5 and HATs on the 40-pin header; camera + SD + hub could
    already exceed 600 mA without any HAT.
    - New U20 LP38693MP-3.3 (TI, 500 mA, 10 V max in, ceramic-stable,
    SOT-223-5) from +5v, EN tied to IN; C74 1 uF in, C75 10 uF out
    (existing BOM parts). ~0.41 W at 215 mA, ~28 C rise at 68.5 C/W.
    - New net HUB_3V3 replaces +3.3v on the hub side only: FB1 (hub
    VDD33),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
2026-10-11 HUB_3V3 also feeds the status LEDs, R52 and the TCA9538
    The hub-side 3.3 V copper on the PCB also runs on to D1/D2/U5, R52
    and U17/R4, so those move onto the hub's always-on rail too:
    - U5 + D1 (red power LED): the CM5's LED_nPWR is meant to light the
    red LED while the board is powered but shut down, and the CM5's
    3.3 V output is off exactly then (CM5 datasheet, pins 84/86), so the
    standby LED never worked. On HUB_3V3 it can.
    - D2 (green ACT LED): LED_nACT is 5 V tolerant open drain, so no
    back-powering into a shut-down CM5.
    - R52 (U16 OE# pull-up): U16 runs from +5v; on HUB_3V3 the LED gate
    stays shut while the CM5's 3.3 V is still down at boot.
    - U17 TCA9538 + R4: same rail as t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
2026-10-11 PCB: USB hub on its own 3.3 V rail (U20), CM5 3.3 V feed split
    Layout for 0105970 + 0fd2e30:
    - U20 (LP38693MP-3.3, SOT-223-5) with C74/C75 placed at ~(133, 137);
    IN/EN from +5v, OUT onto /HUB_3V3 (Michael's routing, 1 mm, F.Cu +
    SIG, joining the hub cluster next to U13).
    - The CM5 3.3 V used to reach the hub area over a 2 mm SIG trace that
    ended on four vias at (150.5, 115) and was then daisy-chained through
    the hub's pads on to the LEDs, R52 and U17. That feed is cut and the
    now dead-end 2 mm SIG run (~20 mm) removed; the hub-side copper (45
    segments, 8 vias) and its 13 pads moved to /HUB_3V3.
    - TP4 and its via moved off VBUS_EN; U20 EN-to-IN routing no longer
    crosses OUT/NC;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
2026-10-11 J15: USB-C orientation mux (HD3SS3220), 1.5 A advertisement, gated VBUS
    J15 (CM5 USB3-0 on a USB-C receptacle) only had TX1/RX1 wired, so
    SuperSpeed worked in one plug orientation only (480M the other way, as
    seen on Rev1); RX2 was AC-shorted to GND through C32/C33; 5.1k Rp to
    3.3 V advertised 3 A while U15 limits at ~1.7 A; VBUS was on whenever
    the CM5 set VBUS_EN, attached or not.
    New U21 TI HD3SS3220RNHR (USB Type-C port controller + USB3 2:1 mux,
    WQFN-30, new libreboard:HD3SS3220 symbol), stand-alone, no I2C:
    - J15 TX1/RX1/TX2/RX2 and CC1/CC2 go to U21's port side; U21 TX/RX go
    to CM5 USB3-0 TX/RX (TX AC-coupling caps are on the CM5).
    - PORT 4.7k to +5v = DFP (host only); CURRENT_MODE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
2026-10-11 BOM: LCSC codes for JLCPCB assembly, DigiKey numbers verified
    Sourcing pass for a rev3 build at JLCPCB (SMT + through-hole), keeping
    the DigiKey BOM usable. Report and per-part data in bom/rev3-sourcing.*.
    - New hidden "LCSC" field on 189 parts (88 of 93 part numbers).
    Passives use JLC Basic/Preferred equivalents where value, size,
    tolerance, voltage and dielectric match or improve (0402 resistors at
    62.5 mW: worst-case dissipation on this board < 5 mW); ICs and
    connectors use the exact part. Exact codes are stored even where JLC
    has no stock (U4/U14, U3, U16, U17, BT1) - see the report.
    - DigiKey: every existing number checked against its MPN (reel numbers
    kept). Filled: J7 (wa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
2026-10-11 J15: C57 100 uF polymer (7343) -> 47 uF ceramic (1206)
    With the HD3SS3220 gating, J15's VBUS only turns on after a device is
    attached, so the USB 2.0 host-port 120 uF hot-plug reservoir is no
    longer needed; a Type-C source needs >= 10 uF on VBUS. C57 becomes the
    same 47 uF 10 V X5R 1206 as C66-C68 (TDK C3216X5R1A476M160AB,
    445-6006-2-ND, LCSC C96123 Basic), freeing board space next to J15.
    With C58/C59 (2 x 10 uF) the port keeps ~30-35 uF effective at 5 V.
    Smaller VBUS capacitance also lets U15 discharge VBUS to vSafe0V faster,
    so U21 can re-enable the port sooner after a re-plug.
    Symbol Device:C_Polarized -> Device:C (same pin positions).
    Connectivity unchanged; ERC unchanged at 342.
    Co-A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
2026-10-11 BOM report: C57 is now the 47 uF 1206 (C66-C68 line)
2026-10-11 PCB checkpoint: J15 mux (U21) placed and routed, USB3_VBUS on a PWR zone
    Layout for 1abcc2e and e869b1f, plus Michael's placement and routing
    (work in progress):
    - U21 HD3SS3220, Q1/Q2, R57-R63 and C76-C78 placed and routed;
    R25/R26/C32/C33 gone; C57 is now the 1206 47 uF.
    - USB3_VBUS: the rev2 0.23 mm F.Cu/In2 traces are replaced by a zone
    on PWR (In2). U15 OUT and IN each have 3 vias; J15 VBUS is fed by
    the vias in A9 and B9, with F.Cu links to B4 and A4 (the A4 via was
    removed, it shorted J15_RX1_N on B.Cu). In a DC model at 2 A,
    U15-to-J15 copper resistance drops from 11.3 to 3.1 mOhm.
    - J15_ID rerouted clear of Q1 pin 3.
    DRC with schematic parity, with and without zone refill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
2026-10-11 Net classes: J15 SuperSpeed pairs in 90R
    The 90R pattern only matched /CM5_HighSpeed/USB3*, so the new
    U21-to-J15 nets (J15_TX1/TX2/RX1/RX2 _P/_N, from 1abcc2e) fell into
    Default (0.13 mm). Two more patterns, /CM5_HighSpeed/J15_TX* and
    /CM5_HighSpeed/J15_RX*, put all eight in 90R (0.147 mm / 0.253 mm
    gap); the other J15_* nets stay Default.
    Checked with the KiCad API; DRC with schematic parity unchanged.
    The existing 0.13 mm J15 pair routing still has to be redone.
2026-10-11 PCB: J15 SuperSpeed pairs at 90R, intra-pair skew matched
    Michael's rework after 3d6803a and ded29a1:
    - J15_TX1/TX2/RX1/RX2 re-routed with the 90R pair geometry
    (0.147 mm); the RX2 fan-out no longer runs 0.053 mm apart (narrowest
    P-N gap now 0.24 mm).
    - Intra-pair skew, with via heights counted (use_height_for_length_calcs):
    J15_TX1 0.03 mm, J15_TX2 0.01, J15_RX1 0.02, J15_RX2 0.04,
    USB3-0-TX 0.11, USB3-0-RX 0.13 (was 3.55 mm).
    J15_TX1_N still changes to B.Cu and back on its own; it is matched
    to P by length, vias included.
    ded29a1: 0 unconnected, no new violations, only the four old J11
    parity items.
    Co-Authored-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
2026-10-12 U3: MagJack TMJG4926HENL -> LINK-PP LPJG0926HENL (same pinout)
    The Rev1 Ethernet fault was never a broken winding: the jacks fitted
    (and the spares) are Taoglas TMJG0813GENL, which fits the same holes
    but has a different pinout (4/5 = a signal pair, 9 = centre tap,
    10 = GND, no pins 11-14). On our footprint that shorts one pair on
    the CT net and puts TRD3 on the centre tap and ground, so 100 Mb/s
    works and gigabit never can.
    U3 now names LINK-PP LPJG0926HENL. Its datasheet (LP18022610 rev A)
    has the same schematic, pin layout and footprint as TMJG4926HENL
    (SPE-23-8-193-B): TD1-TD4 on 1/2, 3/6, 7/8, 9/10, CT 4/5, VC 11-14,
    green LED 15/16, yellow 17/18. JLC C22457393, 2305 in stock; the
    Taog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
2026-10-12 Ethernet TVS U1/U2 (TPD4EUSB30): not fitted (DNP)
    They come from the CM5 IO board, whose schematic labels them
    "Ethernet POE Protection": there the cable-side centre taps go to a
    PoE header (J9). LibreBoard has no PoE (TR0-3_TAP unconnected) and
    the MagJack already isolates the cable side (1500 Vrms). On Rev1 the
    hand-soldered U1/U2 were the cause of the 100 Mb/s link drops, and
    the board ran clean with them removed.
    The footprints stay (flow-through: pin 1 to 10, 2 to 9, 4 to 7,
    5 to 6 under the package), so the lines are continuous with them
    empty and they can be fitted later. Same convention as C26: still in
    the BOM, dnp on the symbol and on the footprint.
    ERC 342 unchanged; DRC with sc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
2026-10-12 BOM: JLC sourcing decisions (U4/U14, U16, U17, BT1, Y1, J2, J8, SW1/SW2)
    Michael's decisions on bom/rev3-sourcing.md section 1:
    - U4/U14: TPS552892RYQR (unobtainable) -> TPS552892QWRYQRQ1, the
    AEC-Q100 version (same pins, RYQ package, VREF, input range).
    To be bought at Mouser and supplied to JLC (JLC and DigiKey 0).
    - U16: SOT-553 DRLR (0 at JLC) -> SC-70-5 SN74AHCT1G125DCKR
    (C350557), same pinout; SC-70-5 because U16 is 1.5-2.3 mm from
    C71/C70/R9/R52. Footprint Package_TO_SOT_SMD:SOT-353_SC-70-5.
    - U17 TCA9538DBR: hand-fitted from DigiKey; in_pos_files no /
    exclude_from_pos_files.
    - BT1: Linx BAT-HLD-007-SMT-TR -> Keystone 3000TR (C6997853), the
    12 mm retainer it copies: + tabs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
2026-10-12 CM5 connectors: split Module1 into Module1 (pins 1-100) and Module2 (101-200)
    Both Amphenol 10164227-1001A1RLF receptacles were one two-unit
    symbol and one footprint with a single reference, which JLC's
    placement file cannot express (one entry per part). Now:
    - Symbols libreboard:ComputeModule5-CM5_A / _B (added to
    libreboard.kicad_sym), made from the two units of the old symbol
    with the same pins and pin positions, so every wire still lands.
    Module1 (CM5_GPIO sheet) keeps pins 1-100; the former unit B on
    CM5_HighSpeed becomes Module2 with pins 101-200 (pin numbers kept).
    - Footprints libreboard:CM5_Connector_A / _B from the old
    Raspberry-Pi-5-Compute-Module footprint, origin at ea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
2026-10-12 PCB: U16 on SC-70-5 and SW1/SW2 Vx39 footprints after F8
    Michael's layout for 94e57a2: F8 replaced U16 (DRL5-L -> SOT-353
    SC-70-5, re-routed) and SW1/SW2 (PTS645 Vx58/Vx31 -> Vx39 outline,
    same pads, routing unchanged).
    Also, with KiCad closed:
    - removed a dangling 0.59 mm F.Cu stub of GPIO10 left at U16 pin 2
    (the B.Cu trace reaches the pad through the via in the pad);
    - reference text of SW1, SW2 and R41 thickened from 0.15 to 0.153 mm,
    the board's silkscreen minimum.
    DRC with schematic parity, with and without zone refill: 0
    unconnected; the U16/SW parity items are gone; no new violations.
2026-10-12 Fan controller: 10k pull-up on unused TACH5; ERC drawing cleanup
    From the ERC review (342 messages, none an electrical fault):
    - U10 (EMC2305) TACH5, pin 16, was floating. The datasheet types the
    TACH inputs as open-drain inputs that need an external pull-up, so
    it gets the same 10k to +3.3v as TACH1-4: new R64 (ERJ-U02F1002X,
    LCSC C25744) above R21-R24 on the +3.3v bus, joined to pin 16 by a
    TACH5 label. No-connect flags on the unused PWM5 (pin 15) and
    ALERT# (pin 12) outputs.
    - Removed the two GPIO_VREF sheet pins on the root sheet and the wire
    between them: neither sub-sheet has that label and the wire joined
    only those two pins. The CM5's GPIO_VREF pin is on +3.3v inside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
2026-10-12 Freeze J11/J15/J7 symbols and J15 footprint in the project libraries
    KiCad 10's stock library renamed the shield pin of
    Connector:USB_C_Receptacle_USB2.0_16P (J11), USB_C_Receptacle (J15)
    and Micro_SD_Card_Det2 (J7) from S1 / 11 to SH, and the stock
    Connector_USB:USB_C_Receptacle_Molex_105450-0101 footprint now has SH
    pads (and rounded pads). Our footprints use S1 / 11. Running "Update
    symbols/footprints from library" would have left the shield pads of
    these three connectors without their GND net.
    - The three symbols, exactly as cached in the schematic, are now in
    libreboard.kicad_sym and the instances link there
    (libreboard:USB_C_Receptacle_USB2.0_16P, libreboard:USB_C_Receptacle,
    li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
2026-10-12 BOM report: U4/U14 sourced through JLC global sourcing, hand-fit as fallback
    TPS552892QWRYQRQ1 cannot be shipped from the US to JLC. Plan A: JLC
    buys 20 through its global parts sourcing from Mouser (25 in stock).
    Plan B: buy at Mouser and fit U4/U14 by hand after assembly. The
    automotive grade is not needed; it is the only TPS552892 in stock.
    No design change.
2026-10-12 PCB: place and route R64 (TACH5 pull-up)
    Michael's layout for a62cd19: R64 (10k, 0402) next to U10, pin 1 on
    +3.3v, pin 2 on TACH5 to U10 pin 16, zones refilled.
    unconnected, no new violations (103, all old warnings); parity down
    to the four old J11 items (R64 and U10 pin 16 now match).
    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
2026-10-12 BOM report: J3 is fitted, only J19 is DNP
    The J3/J19 row said both were not fitted; in the schematic only J19
    has the DNP flag.
2026-10-12 Fab: JLCPCB Gerbers, drill, BOM and placement files for rev3
    fab/make_jlc.py regenerates everything in fab/rev3-jlc/ from the
    board with kicad-cli:
    - Gerbers for the 6 copper layers, mask, paste, silkscreen and
    Edge.Cuts with JLC's recommended KiCad settings (Protel extensions,
    no X2 / netlist attributes, mask subtracted from silkscreen, 4.6
    format); Excellon drill in mm, separate PTH/NPTH, alternate oval
    mode; zipped for upload (the zip is git-ignored).
    - Placement file from the board's position export without DNP and
    "exclude from position files" parts (U17), and without parts that
    have no LCSC number (the four fiducials): 187 parts, all top side.
    - BOM with the same 187 parts,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
2026-10-12 Fab: JLC placement corrections for headers and the CM5 connectors
    JLC's placement preview showed J8 turned 90 deg and sitting on its
    pin 1, the fan headers J51-J54 shifted up by half their length, and
    the CM5 connectors drawn across their footprints.
    fab/make_jlc.py now has a JLC_CORRECTIONS table (regex on footprint
    name): pin headers (J2, J3, J8) and the fan headers are placed at the
    centre of their numbered pads instead of KiCad's pin-1 origin, the
    pin headers get +90 deg, and CM5_Connector_A/B get +90 deg. Nine
    placement lines change; the BOM and Gerbers are unchanged. README
    explains the table and asks to confirm the CM5 connectors' pin-1
    mark in the next preview.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
2026-10-12 PCB: hide Module2's reference on the silkscreen
2026-10-12 Fab: fit JLC placement corrections from JLC's own footprints
    fab/jlc_fit.py downloads the JLCEDA/EasyEDA official-library footprint
    (https://easyeda.com, https://lceda.cn) for every LCSC number JLC places,
    fits its pads onto ours (by pad number, or by position where the
    numbering differs or a mounting pad would land off ours; symmetric pads
    are settled by the body outline) and writes fab/jlc-corrections.csv.
    make_jlc.py applies that file, falls back to a small table for parts
    without JLC data, and leaves Gerbers whose only change is the export
    date untouched.
2026-10-12 Fab: JLC placement from fitted corrections, regenerated CPL
    37 parts move or turn against the previous placement file, among them
    everything from the second JLC preview: USB-A J1/J6/J10/J17 (2.5 mm),
    J11, U3, J4, U12, U13, U16, U18, U21, U8, Q1, Q2 and J100/J101 (+270,
    settled by the body outline). Also fixed: Module1/2 (+270: JLC pin 1 on
    our pin 1, the old +90 put it on pin 100), SW1/SW2 (+180: button was
    facing into the board), J5 (placed by pad positions; JLC numbers the
    FH12 contacts from the other end, our footprint is Raspberry Pi's own)
    and the SOT-23/QFN parts JLC's library draws turned.
    Every JLC pad now lands within 0.2 mm of one of ours (U12 0.47 mm, long
    hand-soldering pads). J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
2026-10-13 PCB: touch up TRD0_N, TRD2_N and TRD3_P Ethernet routing
2026-10-13 BOM: J2 to a generic 2x7 header, J22 to the EDAC HDMI connector
    JLC has no footprint for the Molex parts chosen before (C561778,
    C5240402), so its preview could not show or place them.
    - J2: BOOMELE 2.54-2*7P (C71397, gold, 21.5k at JLC). 6/3 mm pins and a
    2.5 mm insulator instead of the C-Grid's 6.1/2.8 mm and 2.29 mm.
    - J22: EDAC 690-019-298-412 (C5291558, 1,850 at JLC), the part the
    footprint from Raspberry Pi's CM5 IO board was drawn for.
    JLC's footprints for both match ours pad for pad. Neither part is at
    DigiKey or Mouser, so Distributor = LCSC. Fields only: ERC (330) and DRC
    with schematic parity (103, 4 parity) unchanged.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
2026-10-13 Fab: regenerate for the J2/J22 parts and the Ethernet routing
    J22 now has JLC placement data (moved 2.6 mm to JLC's origin); J2 keeps
    its centred +270 placement, now from the fit. Copper Gerbers follow the
    TRD0/TRD2/TRD3 touch-up. Only five 0402 parts are left without a JLC
    footprint.
2026-10-13 BOM: J11 to GCT USB4105-GF-A-120
    JLC's stock of USB4105-GF-A (C3020560) dropped from 39 to 0. The -120
    (C5184243, 1,153 at JLC; DigiKey 2073-USB4105-GF-A-120TR-ND) is the
    same connector with 1.20 mm instead of 0.95 mm shell stakes; GCT's
    drawing has one PCB layout for all stake lengths, and on the 1.6 mm
    board the stakes do not come out the bottom. JLC's footprint matches
    ours pad for pad. Fields only: ERC, DRC and schematic parity unchanged.
2026-10-13 Fab: regenerate BOM and placement for J11 USB4105-GF-A-120
2026-10-13 Fab: also write an SMT-only BOM and placement file
    make_jlc.py now writes a second BOM/CPL pair without the through-hole
    parts (every numbered pad plated through), and a list of those parts
    with their order fields and solder joints, to compare JLC's price with
    buying and soldering them by hand. Parts with SMD pins and through-hole
    shell stakes (USB-C, HDMI, M.2) stay in the SMT set.
2026-10-13 Fab: SMT-only BOM/CPL and hand-fit list for the 16 through-hole parts
    171 parts on 80 BOM lines for JLC; J1/J6/J10/J17, J2, J3, J8, J51-J54,
    J100, J101, SW1, SW2 and U3 by hand (181 joints per board). The README
    lists DigiKey/Mouser numbers and 10-board list prices (about $191 vs
    about $145 at JLC, before JLC's setup and through-hole fees), with
    TMJG4926HENL for U3 and Molex 0010897140 for J2, the two LCSC-only parts.
    Also fixes J1/J6/J10/J17 described as USB-A: they are through-hole USB-C.
2026-10-13 Fab README: JLC quotes for the full vs SMT-only order
    The through-hole parts cost $90.82 at JLC for 5 boards (components,
    manual assembly, hand soldering; feeder and setup fees unchanged)
    against about $107 at DigiKey/Mouser plus 905 hand-soldered joints.
2026-10-20 BOM: Y1 to Epson X1G0041710031 (SG-210STF 24 MHz)
    JLC's stock of the YXC OT252024MJBA4SL (C669072) fell from 4,530 to 1.
    The Epson part (C70559, 7,235 at JLC) has the same pinout: pin 1 = ST,
    output running when high or open (Y1 pin 1 is unconnected), 2 GND,
    3 OUT, 4 VCC; 1.6-3.6 V supply (+1V8), CMOS, +-50 ppm, start-up <= 3 ms.
    JLC's footprint is the same as for the YXC part and matches ours.
    Fields only: ERC, DRC and schematic parity unchanged.
    Refs #24
2026-10-20 Fab: regenerate BOM for Y1 X1G0041710031; README minimum track width
    The smallest tracks are 0.1 mm neck-downs on the hub port D- lines, not
    0.127 mm.
2026-10-20 BOM: C71 to a 10 V 10 uF 0402 (Murata GRM155R61A106ME11D)
    C71 sits on +5v (5.19 V) and was a 6.3 V part shared with C34/C46.
    Same footprint, so fields only: LCSC C408132, DigiKey
    490-GRM155R61A106ME11DTR-ND. C34/C46 (1.2 V) keep the 6.3 V part.
    ERC, DRC and schematic parity unchanged.
2026-10-20 Fab: regenerate BOM for C71 (89 lines)
2026-10-20 Fab README: accept JLC06161H-3313's 1.54 mm real thickness
2026-10-20 PCB: move the fab-notes text from F.Cu to User.Comments
    The notes block sat on top copper about 25 mm above the board outline,
    so it was plotted into the top copper Gerber, saying OSP and 24.9 um
    inner copper. Moved to User.Comments (not plotted) and updated to this
    order: ENIG, 0.5 oz (15.2 um) inner copper, JLC06161H-3313 (1.54 mm),
    silkscreen on both sides. DRC unchanged.
2026-10-20 Fab: regenerate top copper without the out-of-board notes text
    Only shapes outside the board outline were removed (2,974 strokes);
    nothing inside the outline changed.
2026-10-20 C26: fit again, as APAQ 250AVCP470M0506 47 uF 25 V polymer
    C26 (bulk polymer on +12V, U4's output) was fitted on Rev1 but became
    DNP in 82c34c4, the KiCad 10 re-save, where it was the only DNP flag
    that changed - an accident, so JLC's placement left it empty. Fitted
    again. The Panasonic 20SVPF56MX (C2162042) has 2 at JLC with a minimum
    order of 6; the APAQ part (C54864098, 1,035 at JLC) is the only 5 mm
    polymer can in stock: 47 uF, 25 V, 35 mOhm, same footprint.
    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
2026-10-20 Fab: regenerate BOM and placement with C26 (188 parts, 90 lines)
    README: C26 placed again (no JLC footprint: check its polarity in the
    placement confirmation); U4/U14 now come from JLC's stock.
2026-11-09 Board test: libreboard_test.py for assembled rev3 boards
    Runs on the CM5. Automatic checks: PMIC rails, throttling, RTC/BT1,
    Ethernet 1000FD + ping + error counters, Wi-Fi/BT, TUSB4041 hub, J15
    Bitaxe, NVMe link and read speed, I2C devices (EMC2305, TCA9538, Sense
    HAT, OLED, INA219, DSI panel/touch), HDMI EDID, DSI, inputs, fans, hub
    software reset via U17 P7, kernel log. Guided checks: hub ports and J15
    both ways up, J11, touch, joystick, power button, display/OLED/LED
    visual checks with optional webcam photos, +12V at TP2. Report per
    board in /home/pi/libreboard-tests.
    Board 1: 41 pass; U17 not fitted, no coin cell in BT1.
    Refs #22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
