256foundation/libreboard/(notices)

Notices in the files:
CM5_GPIO.kicad_sch:
Copyright © 2024 Raspberry Pi Ltd.
